TomKeddie/prj-artix7-pcie/hardware/v2/images/blank_top.png

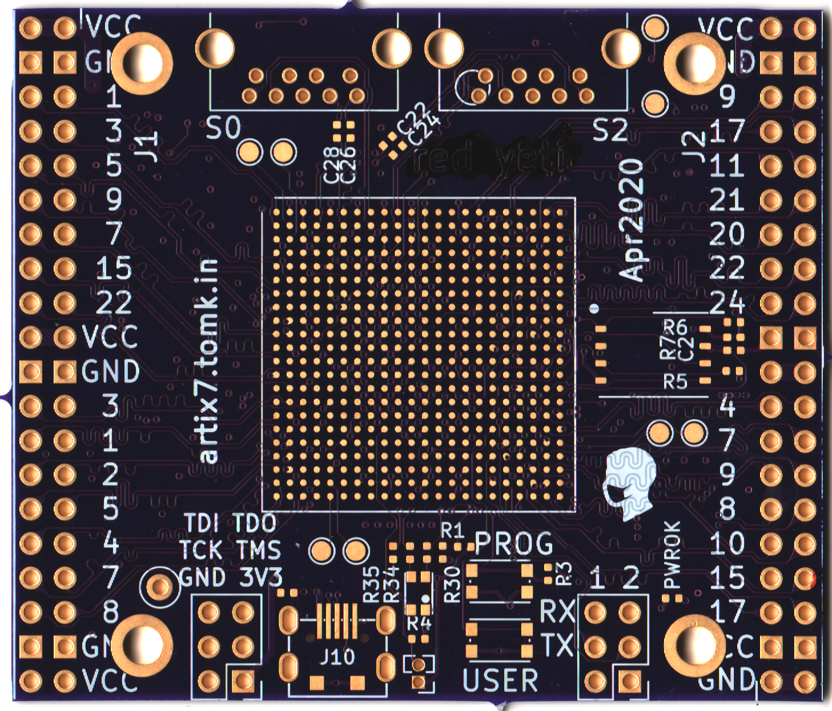
hardware/v2/images/blank_top.png
