TomKeddie/prj-artix7-pcie/hardware/v2/images/blank_bottom.png

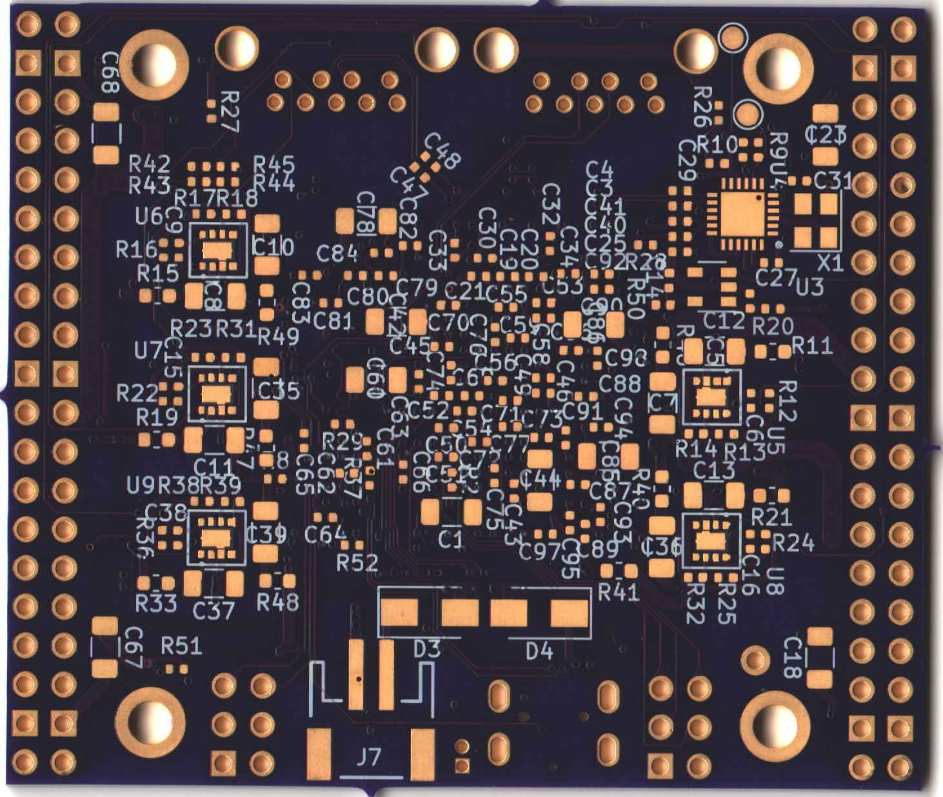
hardware/v2/images/blank_bottom.png
