TomKeddie/prj-artix7-pcie/hardware/v2/README.md

# PCIe artix7

## serdes
- x1 pcie connector (check serdes allocation)
- x1 usb3 connector for expanders and RPi
- x1 on SMA connectors
- x1 in loop?

## Power supply
- reuse supply from netv2

## PMODs
- lots

## CMOD
- maybe
