TomKeddie/prj-artix7-pcie/fpga/test_xc7a12t_cpg238/ex_des/pcie_7x_0_ex/pcie_7x_0_ex.runs/impl_1/.init_design.begin.rst

<?xml version="1.0"?>
<ProcessHandle Version="1" Minor="0">
    <Process Command=".planAhead." Owner="tom" Host="" Pid="7666">
    </Process>
</ProcessHandle>
