TomKeddie/prj-artix7-pcie/fpga/v2/plan/xilinx_ip/pcie_7x_0_ex/pcie_7x_0_ex.runs/synth_1/.vivado.begin.rst

<?xml version="1.0"?>
<ProcessHandle Version="1" Minor="0">
    <Process Command="vivado" Owner="tom" Host="" Pid="15843" HostCore="8" HostMemory="24609572">
    </Process>
</ProcessHandle>
