TomKeddie/prj-artix7-pcie/doc/artix7-pcie-power.pdf

Release: 14-Aug-2019

## Project Settings

| | | | 19% Transceiver…… | 0.494W
Family | | | | 14% I/O | | 0.364W
Device | | | | 59% Core Dynamic.. | 1.534W
Package | | 42.2°C | 5.8W | 8% Device Static | | 0.221W
Speed Grade | | | | Power supplied to off-chip devices… | 0.000W

### Temp Grade

Process | On-Chip Power | | | Power Supply
Voltage ID Used | | | | Voltage | Total (A) | Static
Characterization | (Jump to sheet) | (W) | (%) | 1.000 | 1.567 | 0.109
| | 0.507 | 19 | 1.000 | 0.063 | 0.009
| | 0.457 | 17 | 1.800 | 0.114 | 0.039
Junction Temperature | 42.8 °C | 0.271 | 10 | 2.000 | 0.000 | 0.000
Ambient Temp | | 0.125 | 5 | 3.300 | 0.105 | 0.002
Effective ΘJA | 6.8 °C/W | 0.000 | 0 | 2.500 | 0.000 | 0.000
Airflow | | 0.116 | 4 | 1.800 | 0.000 | 0.000
Heat Sink | | 0.001 | 0 | 1.500 | 0.000 | 0.000
ΘSA | | 0.058 | 2 | 1.350 | 0.000 | 0.000
Board Selection | I/O | 0.364 | 14 | 1.200 | 0.000 | 0.000
# of Board Layers | | 0.494 | 19 | 1.800 | 0.000 | 0.000

ΘJB | | 0.000 | 0 | 1.000 | 0.269 | 0.013
Board Temperature | | 0.000 | 0 | 1.200 | 0.156 | 0.004
| | 0.000 | 0 | 1.800 | 0.000 | 0.000
| Device Static | 0.221 | 8 | 1.075 | 0.000 | 0.000
Optimization | 1 | | | 1.075 | 0.000 | 0.000
1.800 | 0.030 | 0.030

## Spartan®-7, Artix®-7, Kintex®-7, Virtex®-7, Zynq®-7000

Maximum

Commercial

-1 | 6.8 °C/W

250 LFM

VCCO 2.5V

### Core Dynamic

VCCO 1.2V

VCCO 1.35V

Small (4"x4")

0.0 °C/W

## Environment

| | - | 1.500 | 0.000 | 0.000
| Messages | | | - | 1.800 | 0.000 | 0.000 0.000
| | | | - | 1.800 | 0.000
| | | | VCCADC

25.0 °C

### Transceiver

6.8 °C/W

## Summary

XILINX Power Advantage (check for updates) | File Support Request (WebCase)

## Implementation

Default

Xilinx Power Estimator User Guide

0.221

VCCAUX

## Xilinx Power Estimator (XPE) - 2019.1.2

## Power

## Device

Production

Resource | Source VCCINT
No

2.613 W

42.8 °C

Effective ΘJA

### Junction Temperature

### Total On-Chip Power

FGG484

Artix-7

MGTAVCC

### 8 to 11

MGTAVTT

VCCO 1.5V

### Thermal Margin

VCCO 1.8V

None

XC7A75T

25.0 °C | VCCO 3.3V VCCBRAM

VCCAUX_IO

Transceiver……

I/O |

Core Dynamic..

Device Static…..

Import File | Export File | Set Default Rates | Reset to Defaults

LOGIC

BRAM

DSP

IO

PLL

MMCM

GTP

Other

PCIE

CLOCK

User Override

User Override

Quick Estimate | Manage IP | Snapshot

Part
Ambient Temperature
Process
Implementation

### Summary

Total On-Chip Power
Junction Temperature
Effective ΘJA

### On-Chip Power

Clocking
Logic
I/O
BRAM
DSP
Transceiver
PS
Device Static

### Supply Summary

VCCINT

VCCBRAM

VCCAUX

VCCAUX_IO
VCCO 3.3V
VCCO 2.5V
VCCO 1.8V
VCCO 1.5V
VCCO 1.35V
VCCO 1.2V

MGTVCCAUX
MGTAVCC
MGTAVTT
MGTZVCCH
MGTZAVCC
MGTZVCCL

### Settings

Summary | Snapshot | Import | Clear All

VCCPINT

VCCPAUX

VCCPLL

VCCO_DDR

VCCO_MIO0

VCCO_MIO1

VCCADC

# Power Comparison Snapshots

# 0.2 Power ⁽W⁾

# 0.6 Power ⁽W⁾

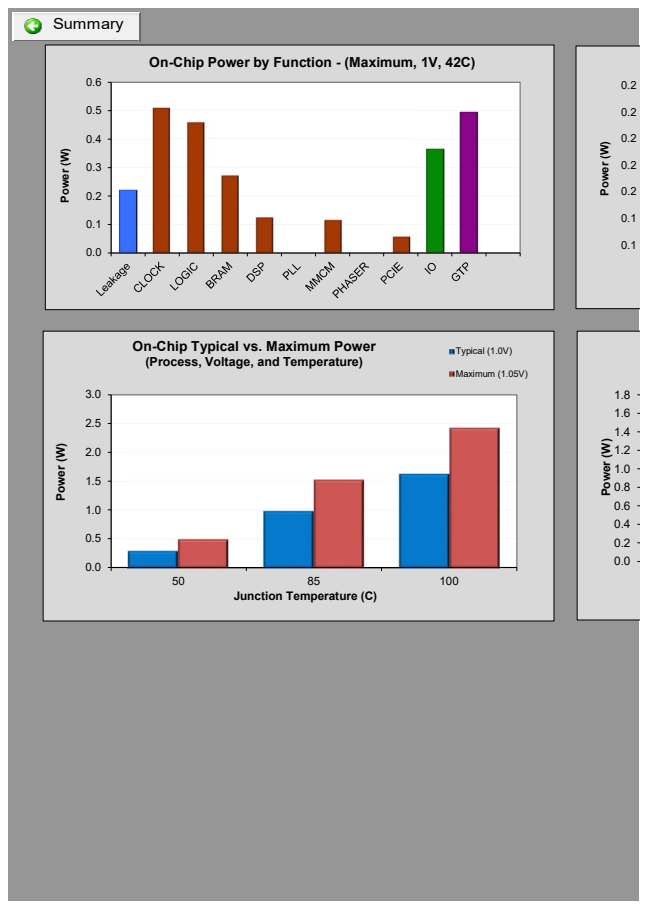
[picture p3: page 23]
1.8 Power ⁽W⁾; 100 Power ⁽W⁾; Junction Temperature (C); Typical (1.0V); Maximum (1.05V); Summary

On-Chip Power by Function - (Maximum, 1V, 42C)

On-Chip Typical vs. Maximum Power
(Process, Voltage, and Temperature)

On-Chip Power over Vccint - (Maximum, 42C)
On-Chip Power - (Maximum, 1V)

# 120 Current (mA⁾

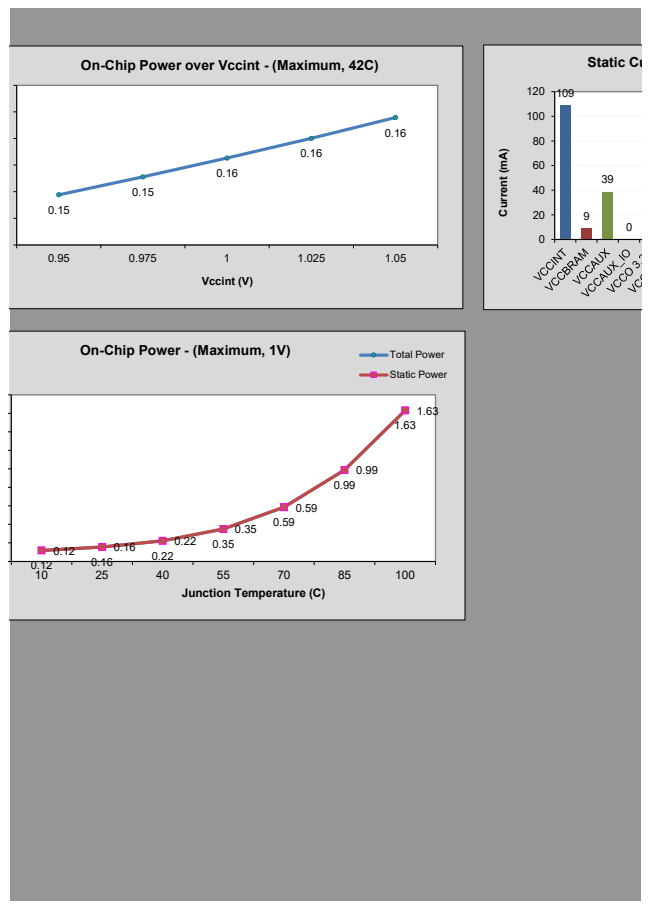
[picture p4: page 25]
Junction Temperature (C); On-Chip Power - (Maximum, 1V); Total Power; Static Power; Vccint (V)

Static Current by Supply

On-Chip Power over Vccint - (Maximum, 42C)

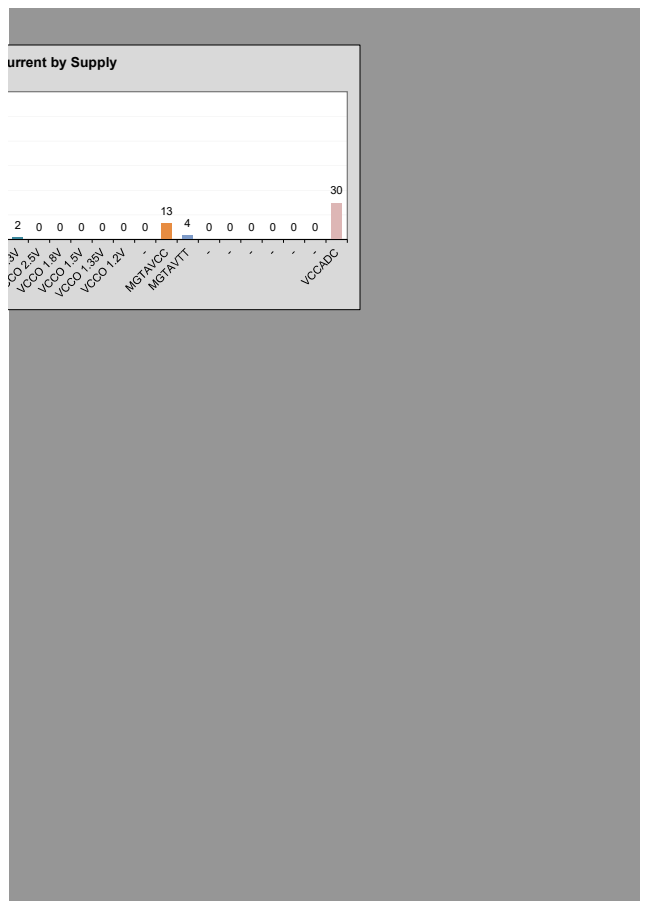
[picture p5: page 27]

Static Current by Supply

Part | XC7K325TFBG900-2LE | Junction Temp | 42.8 °C
Process | Maximum | Static Power | 0.221 W
Effective ΘJA 6.8 °C/W | | | 2.613 W
Implementation
Power (W) | Clocking* | Logic | I/O* | BRAM

29

### Total Power

Default

# IP Manager

## On-Chip Summary

## Device

## IP Modules

Summary | Manage IP

DSP | Transceiver* | Source

IP Catalog
Block Memory
Distributed Memory
Memory Interface
Transceiver Interface
Clock | PLL | MMCM | Logic | I/O | Phaser | BRAM | DSP | PCIE

GTP/X/H GTZ

VCCINT | 1.000V | 0.507W | Global | 2 | 6%
| | | Regional | 0 | 0%
I/O | 0 | 0%
Other | 0 | -

### Frequency

(MHz) | Type | Fanout

### Clock Buffer Enable

100.0 Global | 100000 | 100%
250.0 Global | 100000 | 100%
Global | 100%
Global | 100%
Global | 100%
Global | 100%
Global | 100%
Global | 100%
Global | 100%
Global | 100%
Global | 100%
Global | 100%
Global | 100%
Global | 100%
Global | 100%
Global | 100%
Global | 100%
Global | 100%
Global | 100%
Global | 100%
Global | 100%
Global | 100%
Global | 100%
Global | 100%
Global | 100%
Global | 100%
Global | 100%
Global | 100%
Global | 100%
Global | 100%
Global | 100%
Global | 100%
Global | 100%
Global | 100%
Global | 100%
Global | 100%
Global | 100%
Global | 100%

### Name

# Clock Tree Power

### Utilization

clk_100
clk_250

### Power

19% of total on-chip power 2.613W

Summary

Global | 100%
Global | 100%
Global | 100%
Global | 100%
Global | 100%
Global | 100%
Global | 100%
Global | 100%
Global | 100%
Global | 100%
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
0.000399
0.000399
0.000399
0.000399
0.000399
0.000399
0.000399
0.000399
0.000399
0.000399
0.000399
0.000399
0.000399
0.000399
0.000399
0.000399
0.000399
0.000399
0.000399
0.000399
0.000399
0.000399
0.000399
0.000399
0.000399
0.000399
0.000399
0.000399
0.000399
0.000399
0.000399
0.000399
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
