TomKeddie/prj-artix7-pcie/hardware/v2/bringup/rc2/hardware_manager.png

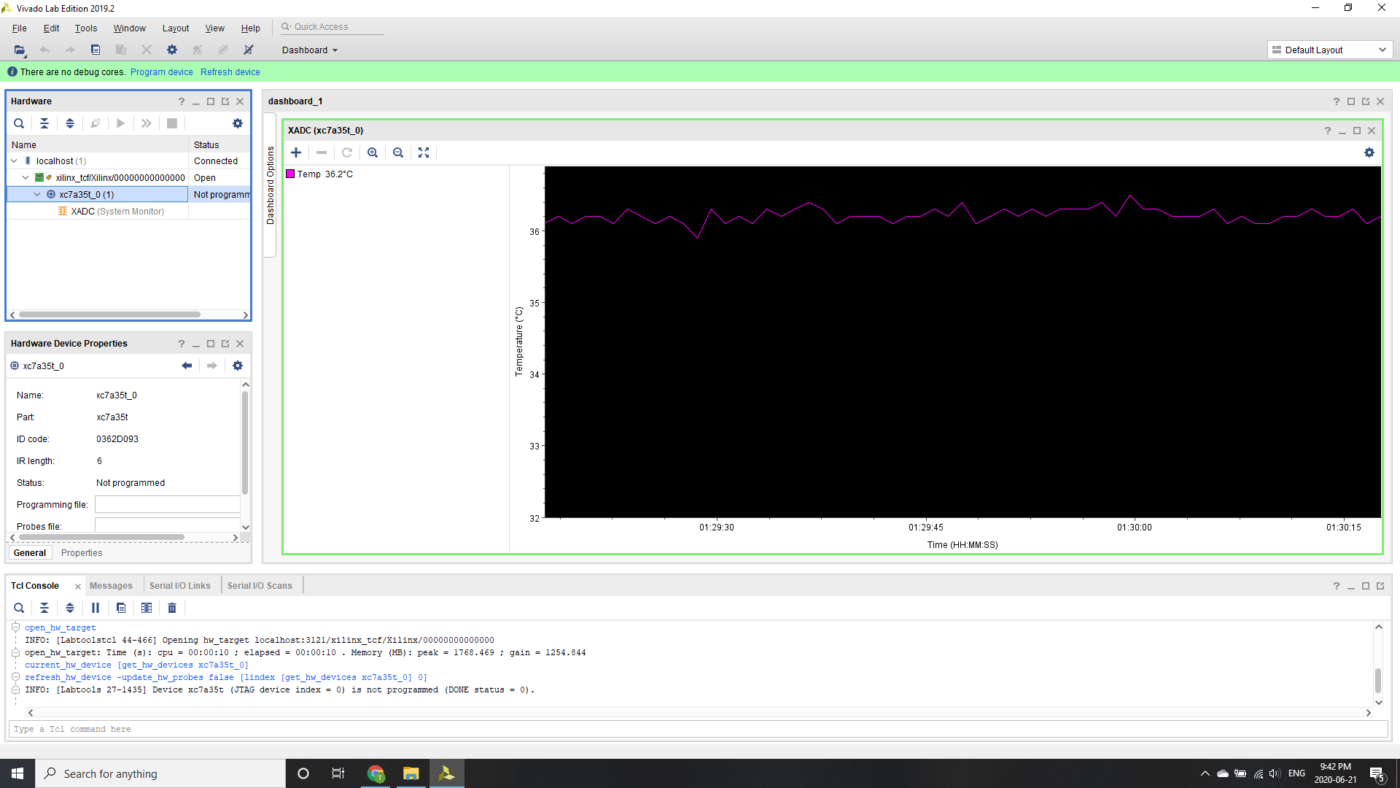
hardware/v2/bringup/rc2/hardware_manager.png
