TomKeddie/prj-artix7-pcie/hardware/v2/eye/20200802_X0Y0_X0Y2_eye_6.25_1e-5.png

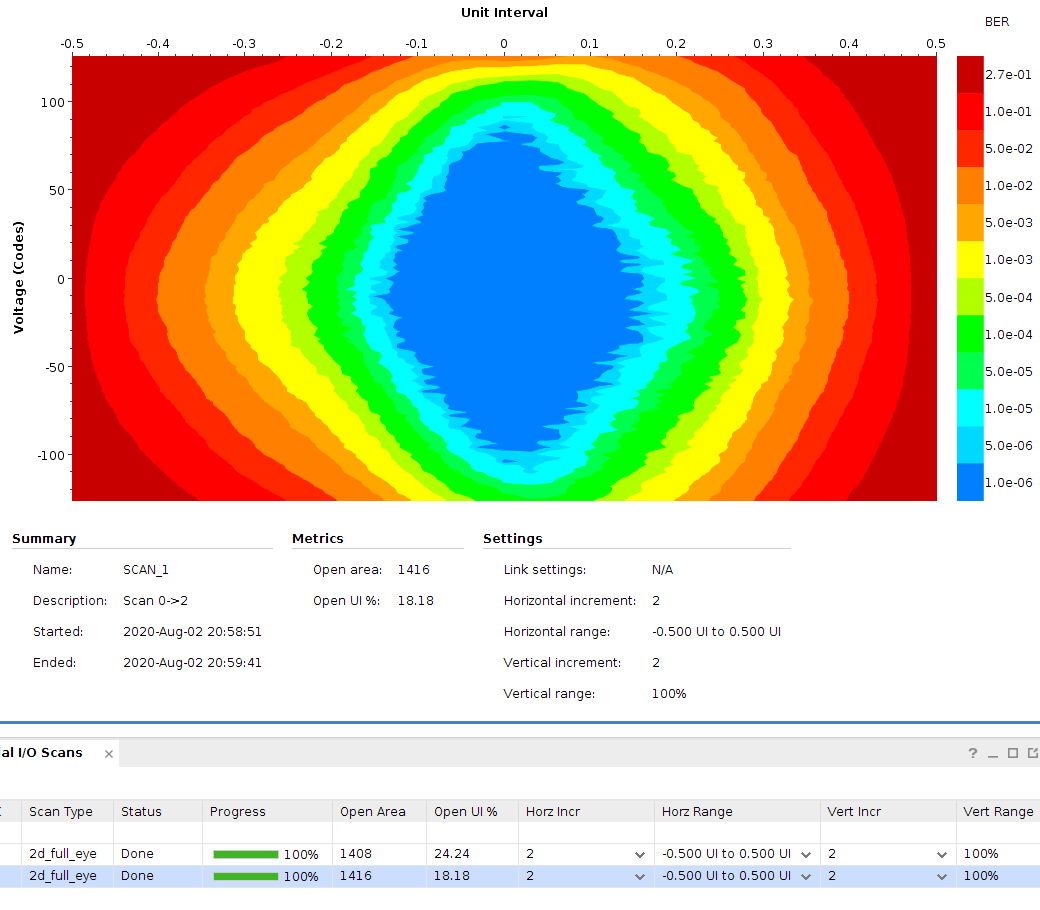
hardware/v2/eye/20200802_X0Y0_X0Y2_eye_6.25_1e-5.png
