TomKeddie/prj-artix7-pcie/hardware/v2/eye/20200802_X0Y2_X0Y0_eye_3.125_1e-10.png

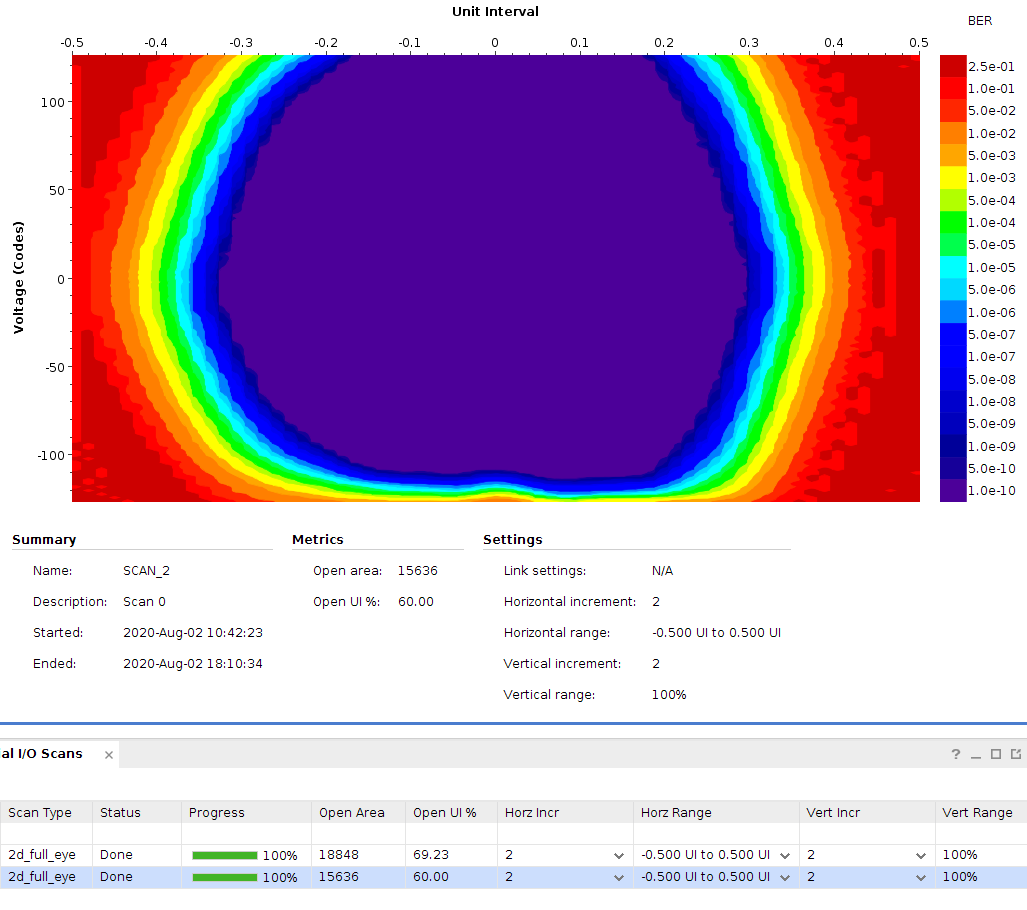
hardware/v2/eye/20200802_X0Y2_X0Y0_eye_3.125_1e-10.png
