TomKeddie/prj-artix7-pcie/hardware/v2/Screenshot_2020-03-27_16-05-11.png

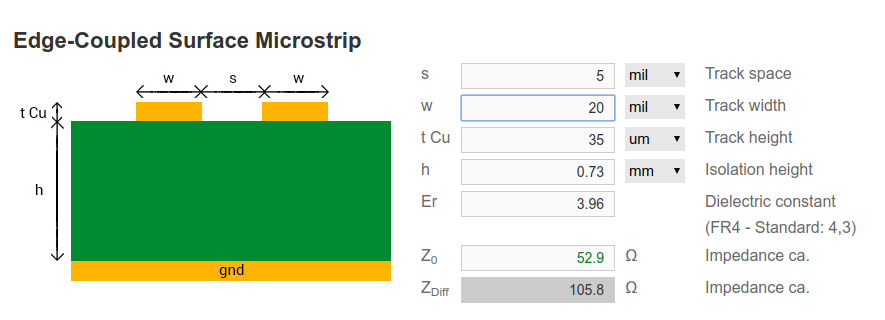
hardware/v2/Screenshot_2020-03-27_16-05-11.png
