TomKeddie/prj-artix7-pcie/hardware/v2/sep2020/Produce_DanZhi.SMT_Original_Snapshot.Bottom.2506220A_Y74.SMT020092078830.png

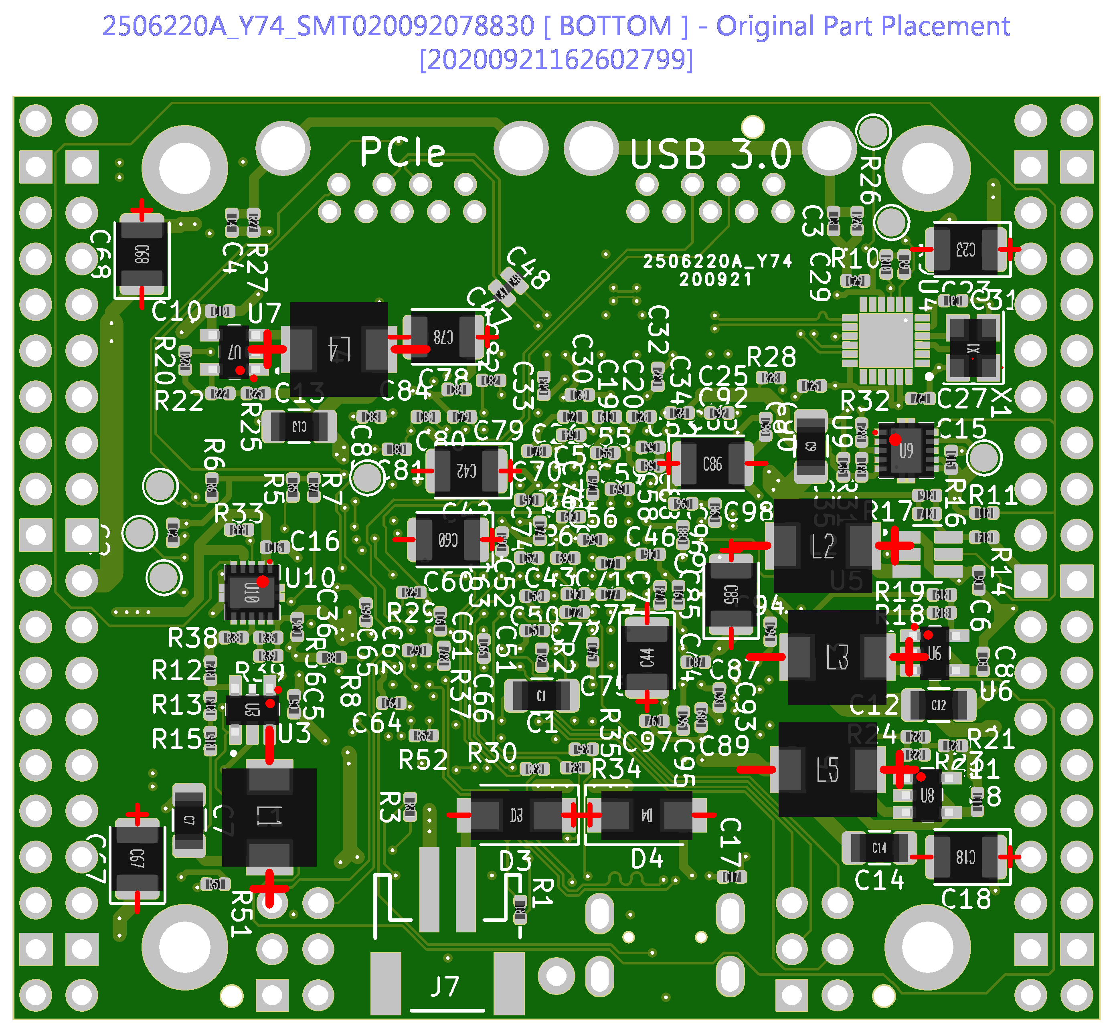
hardware/v2/sep2020/Produce_DanZhi.SMT_Original_Snapshot.Bottom.2506220A_Y74.SMT020092078830.png
