TomKeddie/prj-artix7-pcie/hardware/v2/artix7-pcie-v2_jlcpcb.csv

Comment | Designator | Footprint | LCSC
47uF/6.3V/X5R | C1 | tom-passives:C_1206_3216Metric | C96123
0.1uF/6.3V/X5R | C2,C3,C4,C17,C20,C21,C25,C27,C29,C30,C31,C32,C33 | tom-passives:C_0402_1005Metric | C1525
0.1uF/6.3V/X5R/PCIE | C22,C24,C26,C28,C47,C48 | tom-passives:C_0402_1005Metric | C1525
4.7uF/6.3V/X5R | C19,C34,C43,C45,C46,C50,C61,C62,C70,C71,C72,C73,C79,C80,C87,C88,C89,C90 | tom-passives:C_0402_1005Metric | C23733
4.7uF/10V/X5R | C5,C6,C8,C10,C11,C15,C16,C35,C36 | tom-passives:C_0402_1005Metric | C23733
10uF/25V/X7R | C7,C13 | tom-passives:C_1206_3216Metric | C13585
100uF/6.3V/X5R | C18,C23,C42,C44,C60,C67,C68,C78,C85,C86 | tom-passives:CP_EIA-3528-15_AVX-H | C16133
0.47uF/6.3V/X5R | C49,C51,C52,C53,C54,C55,C56,C58,C59,C63,C64,C65,C66,C69,C74,C75,C76,C77,C81,C82,C83,C84,C91,C92,C93,C94,C95,C96,C97,C98 | tom-passives:C_0402_1005Metric | C47339
47uF/10V/X7R | C9,C12,C14 | tom-passives:C_1206_3216Metric | C96123
DONE | D1 | tom-opto:LED_0402_1005Metric | C130722
E6C1206RGBC3UDA | D2 | tom-opto:E6C1206RGBC3UDA | C375571
SBR3U20SA-13 | D3,D4 | tom-semiconductors:D_SMA | C146738
PWR | D5,D6 | tom-opto:LED_0402_1005Metric | C130724
mask silk image | H1 | artix7-pcie-v2:mask | DNP
mech-only-no-pins | H2,H3,H4 | tom-mechanical:JLCPCB_ASSEMBLY_TOOL_HOLE | DNP
Conn_02x20_Odd_Even | J1,J2 | artix7-pcie-v2:Socket_Strip_Angled_2x20 | DNP
USB_B_Micro | J10 | tom-connectors:USB_MICRO_TAOBAO_SMD_PTH | DNP
USB3_A | J4 | tom-connectors:USB3_A_Aliexpress | DNP
USB3_A_AS_PCIE | J5 | tom-connectors:USB3_A_Aliexpress | DNP
JTAG | J6 | tom-connectors:PinHeader_2x03_P2.54mm_Vertical | DNP
Conn_01x02 | J7 | tom-connectors:JST-2-SMD | DNP
SER | J8 | tom-connectors:PinHeader_2x03_P2.54mm_Vertical | DNP
2.2uH/4.5A | L1,L2,L3,L4,L5 | tom-passives:L_MWSA0518S | C408345
300k/1% | R13,R22 | tom-passives:R_0402_1005Metric | C25774
100k/1% | R11,R12,R14,R17,R18,R20,R21,R24,R32,R33,R38 | tom-passives:R_0402_1005Metric | C25741
200k/1% | R16,R19,R23,R36 | tom-passives:R_0402_1005Metric | C25764
18k/1% | R25 | tom-passives:R_0402_1005Metric | C25762
1.5k | R29,R37 | tom-passives:R_0402_1005Metric | C25867
1.2k/1% | R30 | tom-passives:R_0402_1005Metric | C25862
150k/1% | R15,R31 | tom-passives:R_0402_1005Metric | C25755
300R/5% | R26,R27,R34,R35 | tom-passives:R_0402_1005Metric | C25102
330k/1% | R39 | tom-passives:R_0402_1005Metric | C25778
100R/1% | R28,R52 | tom-passives:R_0402_1005Metric | C25076
2.4k/5% | R6 | tom-passives:R_0402_1005Metric | C25882
4.7k/5% | R1,R2,R3,R4,R5,R7,R9,R10,R51 | tom-passives:R_0402_1005Metric | C25900
1k/1% | R8 | tom-passives:R_0402_1005Metric | C11702
PROG | SW1 | tom-mechanical:SW_Push_1P1T_NO_Vertical_Wuerth_434133025816 | DNP
USER | SW2 | tom-mechanical:SW_Push_1P1T_NO_Vertical_Wuerth_434133025816 | DNP
TestPoint | TP10,TP11,TP12,TP13 | tom-mechanical:MountingHole_2.7mm_M2.5_DIN965_Pad | DNP
SCL | TP14 | tom-mechanical:TestPoint_Pad_D1.5mm | DNP
SDA | TP15 | tom-mechanical:TestPoint_Pad_D1.5mm | DNP
TestPoint | TP1,TP2,TP3,TP4,TP5,TP6,TP7,TP8,TP16,TP17,TP18,TP19,TP20 | tom-mechanical:TestPoint_Pad_D1.5mm | DNP
TestPoint | TP9 | tom-mechanical:TestPoint_Loop_D2.50mm_Drill1.0mm | DNP
XC7A75T-FGG484 | U1 | artix7-pcie-v2:Xilinx_FGG484 | DNP
TPS74701DRCR | U9,U10 | artix7-pcie-v2:16624-01YE | C105262
MX25L51245GZ2I-10G | U2 | artix7-pcie-v2:WSON-8-1EP_8x6mm_P1.27mm | DNP
5P49V6965A000NLGI | U4 | artix7-pcie-v2:QFN50P400X400X100-25N-D | DNP
TLV62569PDDCR | U5 | artix7-pcie-v2:SOT95P280X110-6N | DNP
TLV62569DBVR | U3,U6,U7,U8 | artix7-pcie-v2:SOT95P280X145-5N | C141836
25MHz/10pF | X1 | tom-passives:Crystal_SMD_3225-4Pin_3.2x2.5mm | C9006
