TomKeddie/prj-artix7-pcie/fpga/v1/test_xc7a15t_csg325/ex_des/pcie_7x_0_ex/pcie_7x_0_ex.runs/impl_1/usage_statistics_webtalk.html

### Device Usage Page (usage_statistics_webtalk.html)

This HTML page displays the device usage statistics that will be sent to Xilinx.
To see the actual file transmitted to Xilinx, please click here.

software_version_and_target_device
beta | FALSE | build_version | 2188600
date_generated | Sat Sep 29 06:43:35 2018 | os_platform | LIN64
product_version | Vivado v2018.1 (64-bit) | project_id | d259a2cb10b943cda54699214e62da38
project_iteration | 1 | random_id | ff858b53-a1ef-43aa-b713-6dc5c6852ce6
registration_id | 211427051_0_0_653 | route_design | TRUE
target_device | xc7a25t | target_family | artix7
target_package | csg325 | target_speed | -1
tool_flow | Vivado

user_environment
cpu_name | Intel(R) Xeon(R) CPU W3530 @ 2.80GHz | cpu_speed | 1719.459 MHz
os_name | Arch | os_release | Arch Linux
system_ram | 25.000 GB | total_processors | 1

vivado_usage

gui_handlers
filesetpanel_file_set_panel_tree=5 | flownavigatortreepanel_flow_navigator_tree=1 | hcodeeditor_search_text_combo_box=2

java_command_handlers

runbitgen=1

other_data

guimode=1

project_data
constraintsetcount=1 | core_container=false | currentimplrun=impl_1 | currentsynthesisrun=synth_1
default_library=xil_defaultlib | designmode=RTL | export_simulation_activehdl=1 | export_simulation_ies=1
export_simulation_modelsim=1 | export_simulation_questa=1 | export_simulation_riviera=1 | export_simulation_vcs=1
export_simulation_xsim=1 | implstrategy=Vivado Implementation Defaults | launch_simulation_activehdl=0 | launch_simulation_ies=0
launch_simulation_modelsim=0 | launch_simulation_questa=0 | launch_simulation_riviera=0 | launch_simulation_vcs=0
launch_simulation_xsim=0 | simulator_language=Mixed | srcsetcount=17 | synthesisstrategy=Vivado Synthesis Defaults
target_language=VHDL | target_simulator=XSim | totalimplruns=1 | totalsynthesisruns=1

unisim_transformation

post_unisim_transformation
bufg=4 | bufgctrl=1 | carry4=9 | fdce=9
fdpe=2 | fdre=1586 | fdse=35 | gnd=33
gtpe2_channel=1 | gtpe2_common=2 | ibuf=5 | ibufds_gte2=1
lut1=60 | lut2=152 | lut3=253 | lut4=171
lut5=183 | lut6=218 | mmcme2_adv=1 | muxf7=2
obuf=2 | pcie_2_1=1 | ramb36e1=8 | srl16e=6
srlc32e=14 | vcc=41

pre_unisim_transformation
bufg=4 | bufgctrl=1 | carry4=9 | fdce=9
fdpe=2 | fdre=1586 | fdse=35 | gnd=33
gtpe2_channel=1 | gtpe2_common=2 | ibuf=5 | ibufds_gte2=1
lut1=60 | lut2=152 | lut3=253 | lut4=171
lut5=183 | lut6=218 | mmcme2_adv=1 | muxf7=2
obuf=2 | pcie_2_1=1 | ramb36e1=8 | srl16e=6
srlc32e=14 | vcc=41

power_opt_design

command_line_options_spo
-cell_types=default::all | -clocks=default::[not_specified] | -exclude_cells=default::[not_specified] | -include_cells=default::[not_specified]

usage
bram_ports_augmented=0 | bram_ports_newly_gated=8 | bram_ports_total=16 | flow_state=default
slice_registers_augmented=0 | slice_registers_newly_gated=0 | slice_registers_total=1223 | srls_augmented=0
srls_newly_gated=0 | srls_total=13

ip_statistics

pcie_7x_0_pcie2_top/1
bar_0=FFFFF804 | bar_1=FFFFFFFF | bar_2=00000000 | bar_3=00000000
bar_4=00000000 | bar_5=00000000 | bram_lat=0 | c_aer_base_ptr=000
c_aer_cap_ecrc_check_capable=FALSE | c_aer_cap_ecrc_gen_capable=FALSE | c_aer_cap_multiheader=FALSE | c_aer_cap_nextptr=000
c_aer_cap_on=FALSE | c_aer_cap_optional_err_support=000000 | c_aer_cap_permit_rooterr_update=FALSE | c_buf_opt_bma=TRUE
c_component_name=pcie_7x_0 | c_cpl_inf=TRUE | c_cpl_infinite=TRUE | c_cpl_timeout_disable_sup=FALSE
c_cpl_timeout_range=1110 | c_cpl_timeout_ranges_sup=E | c_d1_support=FALSE | c_d2_support=FALSE
c_data_width=64 | c_de_emph=FALSE | c_dev_cap2_ari_forwarding_supported=FALSE | c_dev_cap2_atomicop32_completer_supported=FALSE
c_dev_cap2_atomicop64_completer_supported=FALSE | c_dev_cap2_atomicop_routing_supported=FALSE | c_dev_cap2_cas128_completer_supported=FALSE | c_dev_cap2_tph_completer_supported=00
c_dev_control_ext_tag_default=FALSE | c_dev_port_type=0 | c_dis_lane_reverse=TRUE | c_disable_rx_poisoned_resp=FALSE
c_disable_scrambling=FALSE | c_disable_tx_aspm_l0s=FALSE | c_dll_lnk_actv_cap=FALSE | c_dsi_bool=FALSE
c_dsn_base_ptr=100 | c_dsn_cap_enabled=TRUE | c_dsn_next_ptr=000 | c_enable_msg_route=00000000000
c_ep_l0s_accpt_lat=6 | c_ep_l1_accpt_lat=7 | c_ext_pci_cfg_space_addr=3FF | c_fc_cpld=205
c_fc_cplh=36 | c_fc_npd=24 | c_fc_nph=12 | c_fc_pd=181
c_fc_ph=32 | c_gen1=false | c_header_type=00 | c_hw_auton_spd_disable=FALSE
c_last_cfg_dw=10C | c_link_cap_aspm_optionality=FALSE | c_ll_ack_timeout=0000 | c_ll_ack_timeout_enable=FALSE
c_ll_ack_timeout_function=0 | c_ll_replay_timeout=0000 | c_ll_replay_timeout_enable=FALSE | c_ll_replay_timeout_func=1
c_msi=0 | c_msi_64b_addr=TRUE | c_msi_cap_on=TRUE | c_msi_mult_msg_extn=0
c_msi_per_vctr_mask_cap=FALSE | c_msix_cap_on=FALSE | c_msix_next_ptr=00 | c_msix_pba_bir=0
c_msix_pba_offset=0 | c_msix_table_bir=0 | c_msix_table_offset=0 | c_msix_table_size=000
c_pci_cfg_space_addr=3F | c_pcie_blk_locn=0 | c_pcie_cap_next_ptr=00 | c_pcie_cap_slot_implemented=FALSE
c_pcie_dbg_ports=TRUE | c_pcie_fast_config=0 | c_perf_level_high=TRUE | c_phantom_functions=0
c_pm_cap_next_ptr=48 | c_pme_support=0F | c_rbar_base_ptr=000 | c_rbar_cap_control_encodedbar0=00
c_rbar_cap_control_encodedbar1=00 | c_rbar_cap_control_encodedbar2=00 | c_rbar_cap_control_encodedbar3=00 | c_rbar_cap_control_encodedbar4=00
c_rbar_cap_control_encodedbar5=00 | c_rbar_cap_index0=0 | c_rbar_cap_index1=0 | c_rbar_cap_index2=0
c_rbar_cap_index3=0 | c_rbar_cap_index4=0 | c_rbar_cap_index5=0 | c_rbar_cap_nextptr=000
c_rbar_cap_on=FALSE | c_rbar_cap_sup0=00001 | c_rbar_cap_sup1=00001 | c_rbar_cap_sup2=00001
c_rbar_cap_sup3=00001 | c_rbar_cap_sup4=00001 | c_rbar_cap_sup5=00001 | c_rbar_num=0
c_rcb=0 | c_recrc_check=0 | c_recrc_check_trim=FALSE | c_root_cap_crs=FALSE
c_rx_raddr_lat=0 | c_rx_ram_limit=3FF | c_rx_rdata_lat=2 | c_rx_write_lat=0
c_silicon_rev=2 | c_slot_cap_attn_butn=FALSE | c_slot_cap_attn_ind=FALSE | c_slot_cap_elec_interlock=FALSE
c_slot_cap_hotplug_cap=FALSE | c_slot_cap_hotplug_surprise=FALSE | c_slot_cap_mrl=FALSE | c_slot_cap_no_cmd_comp_sup=FALSE
c_slot_cap_physical_slot_num=0 | c_slot_cap_pwr_ctrl=FALSE | c_slot_cap_pwr_ind=FALSE | c_slot_cap_pwr_limit_scale=0
c_slot_cap_pwr_limit_value=0 | c_trgt_lnk_spd=0 | c_trn_np_fc=TRUE | c_tx_last_tlp=31
c_tx_raddr_lat=0 | c_tx_rdata_lat=2 | c_tx_write_lat=0 | c_upconfig_capable=TRUE
c_upstream_facing=TRUE | c_ur_atomic=FALSE | c_ur_inv_req=TRUE | c_ur_prs_response=TRUE
c_vc_base_ptr=000 | c_vc_cap_enabled=FALSE | c_vc_cap_reject_snoop=FALSE | c_vc_next_ptr=000
c_vsec_base_ptr=000 | c_vsec_cap_enabled=FALSE | c_vsec_next_ptr=000 | c_xlnx_ref_board=NONE
cap_ver=2 | cardbus_cis_ptr=00000000 | cfg_ctl_if=TRUE | cfg_fc_if=TRUE
cfg_mgmt_if=TRUE | cfg_status_if=TRUE | class_code=058000 | cmps=0
con_scl_fctr_d0_state=0 | con_scl_fctr_d1_state=0 | con_scl_fctr_d2_state=0 | con_scl_fctr_d3_state=0
core_container=NA | cost_table=1 | d1_sup=0 | d2_sup=0
dev_id=7011 | dev_port_type=0000 | dis_scl_fctr_d0_state=0 | dis_scl_fctr_d1_state=0
dis_scl_fctr_d2_state=0 | dis_scl_fctr_d3_state=0 | dsi=0 | enable_jtag_dbg=TRUE
ep_l0s_accpt_lat=110 | ep_l1_accpt_lat=111 | err_reporting_if=TRUE | ext_ch_gt_drp=TRUE
ext_pipe_interface=FALSE | ext_startup_primitive=FALSE | ext_tag_fld_sup=FALSE | int_pin=1
intx=TRUE | iptotal=1 | keep_width=8 | link_cap_max_link_width=1
max_lnk_spd=1 | max_lnk_wdt=000001 | mps=000 | no_soft_rst=TRUE
pci_exp_int_freq=2 | pci_exp_ref_freq=0 | pcie_async_en=FALSE | pcie_ext_clk=TRUE
pcie_ext_gt_common=TRUE | phantm_func_sup=00 | pipe_sim=FALSE | pl_interface=TRUE
pme_sup=0F | pwr_con_d0_state=00 | pwr_con_d1_state=00 | pwr_con_d2_state=00
pwr_con_d3_state=00 | pwr_dis_d0_state=00 | pwr_dis_d1_state=00 | pwr_dis_d2_state=00
pwr_dis_d3_state=00 | rcv_msg_if=TRUE | rev_id=00 | shared_logic_in_core=FALSE
slot_clk=TRUE | subsys_id=0007 | subsys_ven_id=10EE | transceiver_ctrl_status_ports=TRUE
ven_id=10EE | x_ipcorerevision=8 | x_iplanguage=VHDL | x_iplibrary=ip
x_ipname=pcie_7x | x_ipproduct=Vivado 2018.1 | x_ipsimlanguage=MIXED | x_ipvendor=xilinx.com
x_ipversion=3.3 | xrom_bar=00000000

xpm_cdc_single/1
core_container=NA | dest_sync_ff=2 | init_sync_ff=0 | iptotal=2
sim_assert_chk=0 | src_input_reg=0 | version=0

report_drc

command_line_options
-append=default::[not_specified] | -checks=default::[not_specified] | -fail_on=default::[not_specified] | -force=default::[not_specified]
-format=default::[not_specified] | -internal=default::[not_specified] | -internal_only=default::[not_specified] | -messages=default::[not_specified]
-name=default::[not_specified] | -no_waivers=default::[not_specified] | -return_string=default::[not_specified] | -ruledecks=default::[not_specified]
-upgrade_cw=default::[not_specified] | -waived=default::[not_specified]

results
cfgbvs-1=1 | rtstat-10=1

report_methodology

command_line_options
-append=default::[not_specified] | -checks=default::[not_specified] | -fail_on=default::[not_specified] | -force=default::[not_specified]
-format=default::[not_specified] | -messages=default::[not_specified] | -name=default::[not_specified] | -return_string=default::[not_specified]

-waived=default::[not_specified]

results
lutar-1=1 | timing-28=2 | xdcb-5=12

report_power

command_line_options
-advisory=default::[not_specified] | -append=default::[not_specified] | -file=[specified] | -format=default::text
-hier=default::power | -l=default::[not_specified] | -name=default::[not_specified] | -no_propagation=default::[not_specified]
-return_string=default::[not_specified] | -rpx=[specified] | -verbose=default::[not_specified] | -vid=default::[not_specified]

-xpe=default::[not_specified]

usage
-xpe=0.025000 | airflow=250 (LFM) | ambient_temp=25.0 (C) | bi-dir_toggle=12.500000
bidir_output_enable=1.000000 | board_layers=12to15 (12 to 15 Layers) | board_selection=medium (10"x10") | bram=0.014921
clocks=0.008585 | confidence_level_clock_activity=High | confidence_level_design_state=High | confidence_level_device_models=High
confidence_level_internal_activity=Medium | confidence_level_io_activity=Low | confidence_level_overall=Low | customer=TBD
customer_class=TBD | devstatic=0.063128 | die=xc7a25tcsg325-1 | dsp_output_toggle=12.500000
dynamic=0.310279 | effective_thetaja=5.3 | enable_probability=0.990000 | family=artix7
ff_toggle=12.500000 | flow_state=routed | gtp=0.148820 | heatsink=medium (Medium Profile)
i/o=0.000000 | input_toggle=12.500000 | junction_temp=27.0 (C) | logic=0.001604
mgtavcc_dynamic_current=0.066700 | mgtavcc_static_current=0.001386 | mgtavcc_total_current=0.068086 | mgtavcc_voltage=1.000000
mgtavtt_dynamic_current=0.059100 | mgtavtt_static_current=0.002529 | mgtavtt_total_current=0.061629 | mgtavtt_voltage=1.200000
mmcm=0.106817 | netlist_net_matched=NA | off-chip_power=0.000000 | on-chip_power=0.373407
output_enable=1.000000 | output_load=5.000000 | output_toggle=12.500000 | package=csg325
pct_clock_constrained=2.410000 | pct_inputs_defined=20 | platform=lin64 | process=typical
ram_enable=50.000000 | ram_write=50.000000 | read_saif=False | set/reset_probability=0.000000
signal_rate=False | signals=0.004531 | simulation_file=None | speedgrade=-1
static_prob=False | temp_grade=commercial | thetajb=9.4 (C/W) | thetasa=4.6 (C/W)
toggle_rate=False | user_board_temp=25.0 (C) | user_effective_thetaja=5.3 | user_junc_temp=27.0 (C)
user_thetajb=9.4 (C/W) | user_thetasa=4.6 (C/W) | vccadc_dynamic_current=0.000000 | vccadc_static_current=0.020000
vccadc_total_current=0.020000 | vccadc_voltage=1.800000 | vccaux_dynamic_current=0.058791 | vccaux_io_dynamic_current=0.000000
vccaux_io_static_current=0.000000 | vccaux_io_total_current=0.000000 | vccaux_io_voltage=1.800000 | vccaux_static_current=0.009477
vccaux_total_current=0.068268 | vccaux_voltage=1.800000 | vccbram_dynamic_current=0.001180 | vccbram_static_current=0.000380
vccbram_total_current=0.001560 | vccbram_voltage=1.000000 | vccint_dynamic_current=0.065654 | vccint_static_current=0.005269
vccint_total_current=0.070923 | vccint_voltage=1.000000 | vcco12_dynamic_current=0.000000 | vcco12_static_current=0.000000
vcco12_total_current=0.000000 | vcco12_voltage=1.200000 | vcco135_dynamic_current=0.000000 | vcco135_static_current=0.000000
vcco135_total_current=0.000000 | vcco135_voltage=1.350000 | vcco15_dynamic_current=0.000000 | vcco15_static_current=0.000000
vcco15_total_current=0.000000 | vcco15_voltage=1.500000 | vcco18_dynamic_current=0.000000 | vcco18_static_current=0.000000
vcco18_total_current=0.000000 | vcco18_voltage=1.800000 | vcco25_dynamic_current=0.000000 | vcco25_static_current=0.000000
vcco25_total_current=0.000000 | vcco25_voltage=2.500000 | vcco33_dynamic_current=0.000000 | vcco33_static_current=0.000000
vcco33_total_current=0.000000 | vcco33_voltage=3.300000 | version=2018.1

report_utilization

clocking
bufgctrl_available=32 | bufgctrl_fixed=0 | bufgctrl_used=4 | bufgctrl_util_percentage=12.50
bufhce_available=48 | bufhce_fixed=0 | bufhce_used=0 | bufhce_util_percentage=0.00
bufio_available=12 | bufio_fixed=0 | bufio_used=0 | bufio_util_percentage=0.00
bufmrce_available=6 | bufmrce_fixed=0 | bufmrce_used=0 | bufmrce_util_percentage=0.00
bufr_available=12 | bufr_fixed=0 | bufr_used=0 | bufr_util_percentage=0.00
mmcme2_adv_available=3 | mmcme2_adv_fixed=0 | mmcme2_adv_used=1 | mmcme2_adv_util_percentage=33.33
plle2_adv_available=3 | plle2_adv_fixed=0 | plle2_adv_used=0 | plle2_adv_util_percentage=0.00

dsp
dsps_available=80 | dsps_fixed=0 | dsps_used=0 | dsps_util_percentage=0.00

io_standard
blvds_25=0 | diff_hstl_i=0 | diff_hstl_i_18=0 | diff_hstl_ii=0
diff_hstl_ii_18=1 | diff_hsul_12=0 | diff_mobile_ddr=0 | diff_sstl135=0
diff_sstl135_r=0 | diff_sstl15=0 | diff_sstl15_r=0 | diff_sstl18_i=0
diff_sstl18_ii=0 | hstl_i=0 | hstl_i_18=0 | hstl_ii=0
hstl_ii_18=0 | hsul_12=0 | lvcmos12=0 | lvcmos15=0
lvcmos18=1 | lvcmos25=0 | lvcmos33=1 | lvds_25=0
lvttl=0 | mini_lvds_25=0 | mobile_ddr=0 | pci33_3=0
ppds_25=0 | rsds_25=0 | sstl135=0 | sstl135_r=0
sstl15=0 | sstl15_r=0 | sstl18_i=0 | sstl18_ii=0

tmds_33=0

memory
block_ram_tile_available=45 | block_ram_tile_fixed=0 | block_ram_tile_used=8 | block_ram_tile_util_percentage=17.78
ramb18_available=90 | ramb18_fixed=0 | ramb18_used=0 | ramb18_util_percentage=0.00
ramb36_fifo_available=45 | ramb36_fifo_fixed=4 | ramb36_fifo_used=8 | ramb36_fifo_util_percentage=17.78

ramb36e1_only_used=8

primitives
bufg_functional_category=Clock | bufg_used=3 | bufgctrl_functional_category=Clock | bufgctrl_used=1
carry4_functional_category=CarryLogic | carry4_used=3 | fdce_functional_category=Flop & Latch | fdce_used=9
fdpe_functional_category=Flop & Latch | fdpe_used=2 | fdre_functional_category=Flop & Latch | fdre_used=1185
fdse_functional_category=Flop & Latch | fdse_used=27 | gtpe2_channel_functional_category=IO | gtpe2_channel_used=1
gtpe2_common_functional_category=IO | gtpe2_common_used=1 | ibuf_functional_category=IO | ibuf_used=5
ibufds_gte2_functional_category=IO | ibufds_gte2_used=1 | lut1_functional_category=LUT | lut1_used=12
lut2_functional_category=LUT | lut2_used=117 | lut3_functional_category=LUT | lut3_used=211
lut4_functional_category=LUT | lut4_used=154 | lut5_functional_category=LUT | lut5_used=100
lut6_functional_category=LUT | lut6_used=183 | mmcme2_adv_functional_category=Clock | mmcme2_adv_used=1
obuf_functional_category=IO | obuf_used=2 | pcie_2_1_functional_category=Specialized Resource | pcie_2_1_used=1
ramb36e1_functional_category=Block Memory | ramb36e1_used=8 | srl16e_functional_category=Distributed Memory | srl16e_used=6
srlc32e_functional_category=Distributed Memory | srlc32e_used=7

slice_logic
f7_muxes_available=7300 | f7_muxes_fixed=0 | f7_muxes_used=0 | f7_muxes_util_percentage=0.00
f8_muxes_available=3650 | f8_muxes_fixed=0 | f8_muxes_used=0 | f8_muxes_util_percentage=0.00
lut_as_distributed_ram_fixed=0 | lut_as_distributed_ram_used=0 | lut_as_logic_available=14600 | lut_as_logic_fixed=0
lut_as_logic_used=677 | lut_as_logic_util_percentage=4.64 | lut_as_memory_available=5000 | lut_as_memory_fixed=0
lut_as_memory_used=11 | lut_as_memory_util_percentage=0.22 | lut_as_shift_register_fixed=0 | lut_as_shift_register_used=11
register_as_flip_flop_available=29200 | register_as_flip_flop_fixed=0 | register_as_flip_flop_used=1223 | register_as_flip_flop_util_percentage=4.19
register_as_latch_available=29200 | register_as_latch_fixed=0 | register_as_latch_used=0 | register_as_latch_util_percentage=0.00
slice_luts_available=14600 | slice_luts_fixed=0 | slice_luts_used=688 | slice_luts_util_percentage=4.71
slice_registers_available=29200 | slice_registers_fixed=0 | slice_registers_used=1223 | slice_registers_util_percentage=4.19
fully_used_lut_ff_pairs_fixed=4.19 | fully_used_lut_ff_pairs_used=61 | lut_as_distributed_ram_fixed=0 | lut_as_distributed_ram_used=0
lut_as_logic_available=14600 | lut_as_logic_fixed=0 | lut_as_logic_used=677 | lut_as_logic_util_percentage=4.64
lut_as_memory_available=5000 | lut_as_memory_fixed=0 | lut_as_memory_used=11 | lut_as_memory_util_percentage=0.22
lut_as_shift_register_fixed=0 | lut_as_shift_register_used=11 | lut_ff_pairs_with_one_unused_flip_flop_fixed=11 | lut_ff_pairs_with_one_unused_flip_flop_used=309
lut_ff_pairs_with_one_unused_lut_output_fixed=309 | lut_ff_pairs_with_one_unused_lut_output_used=365 | lut_flip_flop_pairs_available=14600 | lut_flip_flop_pairs_fixed=0
lut_flip_flop_pairs_used=443 | lut_flip_flop_pairs_util_percentage=3.03 | slice_available=3650 | slice_fixed=0
slice_used=363 | slice_util_percentage=9.95 | slicel_fixed=0 | slicel_used=229
slicem_fixed=0 | slicem_used=134 | unique_control_sets_used=32 | using_o5_and_o6_fixed=32
using_o5_and_o6_used=2 | using_o5_output_only_fixed=2 | using_o5_output_only_used=0 | using_o6_output_only_fixed=0

using_o6_output_only_used=9

specific_feature
bscane2_available=4 | bscane2_fixed=0 | bscane2_used=0 | bscane2_util_percentage=0.00
capturee2_available=1 | capturee2_fixed=0 | capturee2_used=0 | capturee2_util_percentage=0.00
dna_port_available=1 | dna_port_fixed=0 | dna_port_used=0 | dna_port_util_percentage=0.00
efuse_usr_available=1 | efuse_usr_fixed=0 | efuse_usr_used=0 | efuse_usr_util_percentage=0.00
frame_ecce2_available=1 | frame_ecce2_fixed=0 | frame_ecce2_used=0 | frame_ecce2_util_percentage=0.00
icape2_available=2 | icape2_fixed=0 | icape2_used=0 | icape2_util_percentage=0.00
pcie_2_1_available=1 | pcie_2_1_fixed=1 | pcie_2_1_used=1 | pcie_2_1_util_percentage=100.00
startupe2_available=1 | startupe2_fixed=0 | startupe2_used=0 | startupe2_util_percentage=0.00
xadc_available=1 | xadc_fixed=0 | xadc_used=0 | xadc_util_percentage=0.00

router

usage
actual_expansions=10004202 | bogomips=5602 | bram18=0 | bram36=8
bufg=0 | bufr=0 | congestion_level=0 | ctrls=32
dsp=0 | effort=2 | estimated_expansions=2286738 | ff=1223
global_clocks=4 | high_fanout_nets=2 | iob=1 | lut=721
movable_instances=2135 | nets=3295 | pins=14983 | pll=0
router_runtime=0.000000 | router_timing_driven=1 | threads=8 | timing_constraints_exist=1

synthesis

command_line_options
-assert=default::[not_specified] | -bufg=default::12 | -cascade_dsp=default::auto | -constrset=default::[not_specified]
-control_set_opt_threshold=default::auto | -directive=default::default | -fanout_limit=default::10000 | -flatten_hierarchy=default::rebuilt
-fsm_extraction=default::auto | -gated_clock_conversion=default::off | -generic=default::[not_specified] | -include_dirs=default::[not_specified]
-keep_equivalent_registers=default::[not_specified] | -max_bram=default::-1 | -max_bram_cascade_height=default::-1 | -max_dsp=default::-1
-max_uram=default::-1 | -max_uram_cascade_height=default::-1 | -mode=default::default | -name=default::[not_specified]
-no_lc=default::[not_specified] | -no_srlextract=default::[not_specified] | -no_timing_driven=default::[not_specified] | -part=xc7a25tcsg325-1
-resource_sharing=default::auto | -retiming=default::[not_specified] | -rtl=default::[not_specified] | -rtl_skip_constraints=default::[not_specified]
-rtl_skip_ip=default::[not_specified] | -seu_protect=default::none | -sfcu=default::[not_specified] | -shreg_min_size=default::3
-top=xilinx_pcie_2_1_ep_7x | -verilog_define=default::[not_specified]

usage
elapsed=00:00:58s | hls_ip=0 | memory_gain=476.348MB | memory_peak=1656.301MB
