TomKeddie/prj-artix7-pcie/fpga/test_xc7a12t_cpg238/test_xc7a12t_cpg238.runs/pcie_7x_0_synth_1/.vivado.begin.rst

<?xml version="1.0"?>
<ProcessHandle Version="1" Minor="0">
    <Process Command="vivado" Owner="tom" Host="z400" Pid="26144">
    </Process>
</ProcessHandle>
