TomKeddie/prj-artix7-pcie/fpga/v1/test_xc7a12t_cpg238/test_xc7a12t_cpg238.ip_user_files/sim_scripts/pcie_7x_0/activehdl/file_info.txt

xpm_cdc.sv,systemverilog,xil_defaultlib,../../../../../../../../../../../opt/Xilinx/Vivado/2018.1/data/ip/xpm/xpm_cdc/hdl/xpm_cdc.sv,
xpm_memory.sv,systemverilog,xil_defaultlib,../../../../../../../../../../../opt/Xilinx/Vivado/2018.1/data/ip/xpm/xpm_memory/hdl/xpm_memory.sv,
xpm_VCOMP.vhd,vhdl,xpm,../../../../../../../../../../../opt/Xilinx/Vivado/2018.1/data/ip/xpm/xpm_VCOMP.vhd,
pcie_7x_0_core_top.vhd,vhdl,xil_defaultlib,../../../../test_xc7a12t_cpg238.srcs/sources_1/ip/pcie_7x_0/source/pcie_7x_0_core_top.vhd,
pcie_7x_0_pipe_drp.v,verilog,xil_defaultlib,../../../../test_xc7a12t_cpg238.srcs/sources_1/ip/pcie_7x_0/source/pcie_7x_0_pipe_drp.v,
pcie_7x_0_pipe_eq.v,verilog,xil_defaultlib,../../../../test_xc7a12t_cpg238.srcs/sources_1/ip/pcie_7x_0/source/pcie_7x_0_pipe_eq.v,
pcie_7x_0_pipe_rate.v,verilog,xil_defaultlib,../../../../test_xc7a12t_cpg238.srcs/sources_1/ip/pcie_7x_0/source/pcie_7x_0_pipe_rate.v,
pcie_7x_0_pipe_reset.v,verilog,xil_defaultlib,../../../../test_xc7a12t_cpg238.srcs/sources_1/ip/pcie_7x_0/source/pcie_7x_0_pipe_reset.v,
pcie_7x_0_pipe_sync.v,verilog,xil_defaultlib,../../../../test_xc7a12t_cpg238.srcs/sources_1/ip/pcie_7x_0/source/pcie_7x_0_pipe_sync.v,
pcie_7x_0_gtp_pipe_rate.v,verilog,xil_defaultlib,../../../../test_xc7a12t_cpg238.srcs/sources_1/ip/pcie_7x_0/source/pcie_7x_0_gtp_pipe_rate.v,
pcie_7x_0_gtp_pipe_drp.v,verilog,xil_defaultlib,../../../../test_xc7a12t_cpg238.srcs/sources_1/ip/pcie_7x_0/source/pcie_7x_0_gtp_pipe_drp.v,
pcie_7x_0_gtp_pipe_reset.v,verilog,xil_defaultlib,../../../../test_xc7a12t_cpg238.srcs/sources_1/ip/pcie_7x_0/source/pcie_7x_0_gtp_pipe_reset.v,
pcie_7x_0_pipe_user.v,verilog,xil_defaultlib,../../../../test_xc7a12t_cpg238.srcs/sources_1/ip/pcie_7x_0/source/pcie_7x_0_pipe_user.v,
pcie_7x_0_pipe_wrapper.v,verilog,xil_defaultlib,../../../../test_xc7a12t_cpg238.srcs/sources_1/ip/pcie_7x_0/source/pcie_7x_0_pipe_wrapper.v,
pcie_7x_0_qpll_drp.v,verilog,xil_defaultlib,../../../../test_xc7a12t_cpg238.srcs/sources_1/ip/pcie_7x_0/source/pcie_7x_0_qpll_drp.v,
pcie_7x_0_qpll_reset.v,verilog,xil_defaultlib,../../../../test_xc7a12t_cpg238.srcs/sources_1/ip/pcie_7x_0/source/pcie_7x_0_qpll_reset.v,
pcie_7x_0_qpll_wrapper.v,verilog,xil_defaultlib,../../../../test_xc7a12t_cpg238.srcs/sources_1/ip/pcie_7x_0/source/pcie_7x_0_qpll_wrapper.v,
pcie_7x_0_rxeq_scan.v,verilog,xil_defaultlib,../../../../test_xc7a12t_cpg238.srcs/sources_1/ip/pcie_7x_0/source/pcie_7x_0_rxeq_scan.v,
pcie_7x_0_axi_basic_rx_null_gen.vhd,vhdl,xil_defaultlib,../../../../test_xc7a12t_cpg238.srcs/sources_1/ip/pcie_7x_0/source/pcie_7x_0_axi_basic_rx_null_gen.vhd,
pcie_7x_0_axi_basic_rx_pipeline.vhd,vhdl,xil_defaultlib,../../../../test_xc7a12t_cpg238.srcs/sources_1/ip/pcie_7x_0/source/pcie_7x_0_axi_basic_rx_pipeline.vhd,
pcie_7x_0_axi_basic_rx.vhd,vhdl,xil_defaultlib,../../../../test_xc7a12t_cpg238.srcs/sources_1/ip/pcie_7x_0/source/pcie_7x_0_axi_basic_rx.vhd,
pcie_7x_0_axi_basic_top.vhd,vhdl,xil_defaultlib,../../../../test_xc7a12t_cpg238.srcs/sources_1/ip/pcie_7x_0/source/pcie_7x_0_axi_basic_top.vhd,
pcie_7x_0_axi_basic_tx_pipeline.vhd,vhdl,xil_defaultlib,../../../../test_xc7a12t_cpg238.srcs/sources_1/ip/pcie_7x_0/source/pcie_7x_0_axi_basic_tx_pipeline.vhd,
pcie_7x_0_axi_basic_tx_thrtl_ctl.vhd,vhdl,xil_defaultlib,../../../../test_xc7a12t_cpg238.srcs/sources_1/ip/pcie_7x_0/source/pcie_7x_0_axi_basic_tx_thrtl_ctl.vhd,
pcie_7x_0_axi_basic_tx.vhd,vhdl,xil_defaultlib,../../../../test_xc7a12t_cpg238.srcs/sources_1/ip/pcie_7x_0/source/pcie_7x_0_axi_basic_tx.vhd,
pcie_7x_0_pcie_7x.vhd,vhdl,xil_defaultlib,../../../../test_xc7a12t_cpg238.srcs/sources_1/ip/pcie_7x_0/source/pcie_7x_0_pcie_7x.vhd,
pcie_7x_0_pcie_bram_7x.vhd,vhdl,xil_defaultlib,../../../../test_xc7a12t_cpg238.srcs/sources_1/ip/pcie_7x_0/source/pcie_7x_0_pcie_bram_7x.vhd,
pcie_7x_0_pcie_bram_top_7x.vhd,vhdl,xil_defaultlib,../../../../test_xc7a12t_cpg238.srcs/sources_1/ip/pcie_7x_0/source/pcie_7x_0_pcie_bram_top_7x.vhd,
pcie_7x_0_pcie_brams_7x.vhd,vhdl,xil_defaultlib,../../../../test_xc7a12t_cpg238.srcs/sources_1/ip/pcie_7x_0/source/pcie_7x_0_pcie_brams_7x.vhd,
pcie_7x_0_pcie_pipe_lane.vhd,vhdl,xil_defaultlib,../../../../test_xc7a12t_cpg238.srcs/sources_1/ip/pcie_7x_0/source/pcie_7x_0_pcie_pipe_lane.vhd,
pcie_7x_0_pcie_pipe_misc.vhd,vhdl,xil_defaultlib,../../../../test_xc7a12t_cpg238.srcs/sources_1/ip/pcie_7x_0/source/pcie_7x_0_pcie_pipe_misc.vhd,
pcie_7x_0_pcie_pipe_pipeline.vhd,vhdl,xil_defaultlib,../../../../test_xc7a12t_cpg238.srcs/sources_1/ip/pcie_7x_0/source/pcie_7x_0_pcie_pipe_pipeline.vhd,
pcie_7x_0_gt_rx_valid_filter_7x.vhd,vhdl,xil_defaultlib,../../../../test_xc7a12t_cpg238.srcs/sources_1/ip/pcie_7x_0/source/pcie_7x_0_gt_rx_valid_filter_7x.vhd,
pcie_7x_0_gt_top.vhd,vhdl,xil_defaultlib,../../../../test_xc7a12t_cpg238.srcs/sources_1/ip/pcie_7x_0/source/pcie_7x_0_gt_top.vhd,
pcie_7x_0_gt_wrapper.v,verilog,xil_defaultlib,../../../../test_xc7a12t_cpg238.srcs/sources_1/ip/pcie_7x_0/source/pcie_7x_0_gt_wrapper.v,
pcie_7x_0_gt_common.v,verilog,xil_defaultlib,../../../../test_xc7a12t_cpg238.srcs/sources_1/ip/pcie_7x_0/source/pcie_7x_0_gt_common.v,
pcie_7x_0_gtp_cpllpd_ovrd.v,verilog,xil_defaultlib,../../../../test_xc7a12t_cpg238.srcs/sources_1/ip/pcie_7x_0/source/pcie_7x_0_gtp_cpllpd_ovrd.v,
pcie_7x_0_gtx_cpllpd_ovrd.v,verilog,xil_defaultlib,../../../../test_xc7a12t_cpg238.srcs/sources_1/ip/pcie_7x_0/source/pcie_7x_0_gtx_cpllpd_ovrd.v,
pcie_7x_0_pcie_top.vhd,vhdl,xil_defaultlib,../../../../test_xc7a12t_cpg238.srcs/sources_1/ip/pcie_7x_0/source/pcie_7x_0_pcie_top.vhd,
pcie_7x_0_pcie2_top.vhd,vhdl,xil_defaultlib,../../../../test_xc7a12t_cpg238.srcs/sources_1/ip/pcie_7x_0/source/pcie_7x_0_pcie2_top.vhd,
pcie_7x_0.vhd,vhdl,xil_defaultlib,../../../../test_xc7a12t_cpg238.srcs/sources_1/ip/pcie_7x_0/sim/pcie_7x_0.vhd,
glbl.v,Verilog,xil_defaultlib,glbl.v
