TomKeddie/prj-artix7-pcie/fpga/v1/test_xc7a25t_csg325/test_xc7a25t_csg325.ip_user_files/sim_scripts/pcie_7x_0/activehdl/file_info.txt

xpm_cdc.sv,systemverilog,xil_defaultlib,../../../../../../../../../../../../../opt/Xilinx/Vivado/2018.1/data/ip/xpm/xpm_cdc/hdl/xpm_cdc.sv,incdir="../../../../test_xc7a25t_csg325.srcs/sources_1/ip/pcie_7x_0/ip_0/hdl/verilog"
xpm_memory.sv,systemverilog,xil_defaultlib,../../../../../../../../../../../../../opt/Xilinx/Vivado/2018.1/data/ip/xpm/xpm_memory/hdl/xpm_memory.sv,incdir="../../../../test_xc7a25t_csg325.srcs/sources_1/ip/pcie_7x_0/ip_0/hdl/verilog"
xpm_VCOMP.vhd,vhdl,xpm,../../../../../../../../../../../../../opt/Xilinx/Vivado/2018.1/data/ip/xpm/xpm_VCOMP.vhd,incdir="../../../../test_xc7a25t_csg325.srcs/sources_1/ip/pcie_7x_0/ip_0/hdl/verilog"
jtag_axi_v1_2_rfs.v,verilog,jtag_axi,../../../ipstatic/hdl/jtag_axi_v1_2_rfs.v,incdir="../../../../test_xc7a25t_csg325.srcs/sources_1/ip/pcie_7x_0/ip_0/hdl/verilog"
pcie_7x_0_jtag.v,verilog,xil_defaultlib,../../../../test_xc7a25t_csg325.srcs/sources_1/ip/pcie_7x_0/ip_0/sim/pcie_7x_0_jtag.v,incdir="../../../../test_xc7a25t_csg325.srcs/sources_1/ip/pcie_7x_0/ip_0/hdl/verilog"
pcie_7x_0_core_top.vhd,vhdl,xil_defaultlib,../../../../test_xc7a25t_csg325.srcs/sources_1/ip/pcie_7x_0/source/pcie_7x_0_core_top.vhd,incdir="../../../../test_xc7a25t_csg325.srcs/sources_1/ip/pcie_7x_0/ip_0/hdl/verilog"
pcie_7x_0_pipe_drp.v,verilog,xil_defaultlib,../../../../test_xc7a25t_csg325.srcs/sources_1/ip/pcie_7x_0/source/pcie_7x_0_pipe_drp.v,incdir="../../../../test_xc7a25t_csg325.srcs/sources_1/ip/pcie_7x_0/ip_0/hdl/verilog"
pcie_7x_0_pipe_eq.v,verilog,xil_defaultlib,../../../../test_xc7a25t_csg325.srcs/sources_1/ip/pcie_7x_0/source/pcie_7x_0_pipe_eq.v,incdir="../../../../test_xc7a25t_csg325.srcs/sources_1/ip/pcie_7x_0/ip_0/hdl/verilog"
pcie_7x_0_pipe_rate.v,verilog,xil_defaultlib,../../../../test_xc7a25t_csg325.srcs/sources_1/ip/pcie_7x_0/source/pcie_7x_0_pipe_rate.v,incdir="../../../../test_xc7a25t_csg325.srcs/sources_1/ip/pcie_7x_0/ip_0/hdl/verilog"
pcie_7x_0_pipe_reset.v,verilog,xil_defaultlib,../../../../test_xc7a25t_csg325.srcs/sources_1/ip/pcie_7x_0/source/pcie_7x_0_pipe_reset.v,incdir="../../../../test_xc7a25t_csg325.srcs/sources_1/ip/pcie_7x_0/ip_0/hdl/verilog"
pcie_7x_0_pipe_sync.v,verilog,xil_defaultlib,../../../../test_xc7a25t_csg325.srcs/sources_1/ip/pcie_7x_0/source/pcie_7x_0_pipe_sync.v,incdir="../../../../test_xc7a25t_csg325.srcs/sources_1/ip/pcie_7x_0/ip_0/hdl/verilog"
pcie_7x_0_gtp_pipe_rate.v,verilog,xil_defaultlib,../../../../test_xc7a25t_csg325.srcs/sources_1/ip/pcie_7x_0/source/pcie_7x_0_gtp_pipe_rate.v,incdir="../../../../test_xc7a25t_csg325.srcs/sources_1/ip/pcie_7x_0/ip_0/hdl/verilog"
pcie_7x_0_gtp_pipe_drp.v,verilog,xil_defaultlib,../../../../test_xc7a25t_csg325.srcs/sources_1/ip/pcie_7x_0/source/pcie_7x_0_gtp_pipe_drp.v,incdir="../../../../test_xc7a25t_csg325.srcs/sources_1/ip/pcie_7x_0/ip_0/hdl/verilog"
pcie_7x_0_gtp_pipe_reset.v,verilog,xil_defaultlib,../../../../test_xc7a25t_csg325.srcs/sources_1/ip/pcie_7x_0/source/pcie_7x_0_gtp_pipe_reset.v,incdir="../../../../test_xc7a25t_csg325.srcs/sources_1/ip/pcie_7x_0/ip_0/hdl/verilog"
pcie_7x_0_pipe_user.v,verilog,xil_defaultlib,../../../../test_xc7a25t_csg325.srcs/sources_1/ip/pcie_7x_0/source/pcie_7x_0_pipe_user.v,incdir="../../../../test_xc7a25t_csg325.srcs/sources_1/ip/pcie_7x_0/ip_0/hdl/verilog"
pcie_7x_0_pipe_wrapper.v,verilog,xil_defaultlib,../../../../test_xc7a25t_csg325.srcs/sources_1/ip/pcie_7x_0/source/pcie_7x_0_pipe_wrapper.v,incdir="../../../../test_xc7a25t_csg325.srcs/sources_1/ip/pcie_7x_0/ip_0/hdl/verilog"
pcie_7x_0_qpll_reset.v,verilog,xil_defaultlib,../../../../test_xc7a25t_csg325.srcs/sources_1/ip/pcie_7x_0/source/pcie_7x_0_qpll_reset.v,incdir="../../../../test_xc7a25t_csg325.srcs/sources_1/ip/pcie_7x_0/ip_0/hdl/verilog"
pcie_7x_0_rxeq_scan.v,verilog,xil_defaultlib,../../../../test_xc7a25t_csg325.srcs/sources_1/ip/pcie_7x_0/source/pcie_7x_0_rxeq_scan.v,incdir="../../../../test_xc7a25t_csg325.srcs/sources_1/ip/pcie_7x_0/ip_0/hdl/verilog"
pcie_7x_0_axi_basic_rx_null_gen.vhd,vhdl,xil_defaultlib,../../../../test_xc7a25t_csg325.srcs/sources_1/ip/pcie_7x_0/source/pcie_7x_0_axi_basic_rx_null_gen.vhd,incdir="../../../../test_xc7a25t_csg325.srcs/sources_1/ip/pcie_7x_0/ip_0/hdl/verilog"
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
pcie_7x_0.vhd,vhdl,xil_defaultlib,../../../../test_xc7a25t_csg325.srcs/sources_1/ip/pcie_7x_0/sim/pcie_7x_0.vhd,incdir="../../../../test_xc7a25t_csg325.srcs/sources_1/ip/pcie_7x_0/ip_0/hdl/verilog"
glbl.v,Verilog,xil_defaultlib,glbl.v
