TomKeddie/prj-artix7-pcie/hardware/v2/bringup/rc2/power-sequence-saleae.png

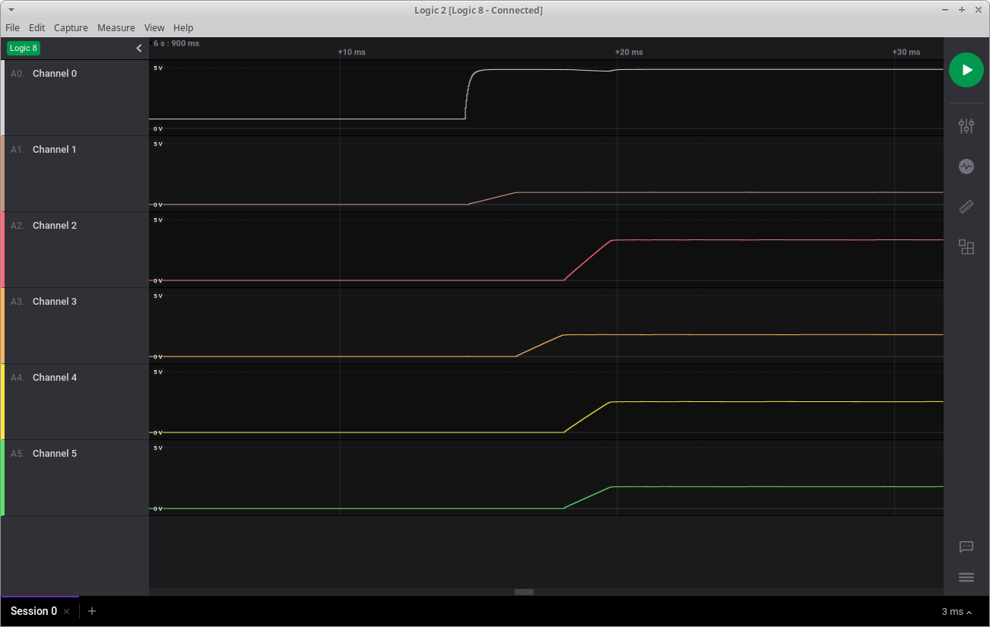
hardware/v2/bringup/rc2/power-sequence-saleae.png
