TomKeddie/prj-artix7-pcie/hardware/v2/artix7-pcie-v2.kicad_pcb

## KiCad design hardware/v2/artix7-pcie-v2.kicad_pcb (2020-12-11)

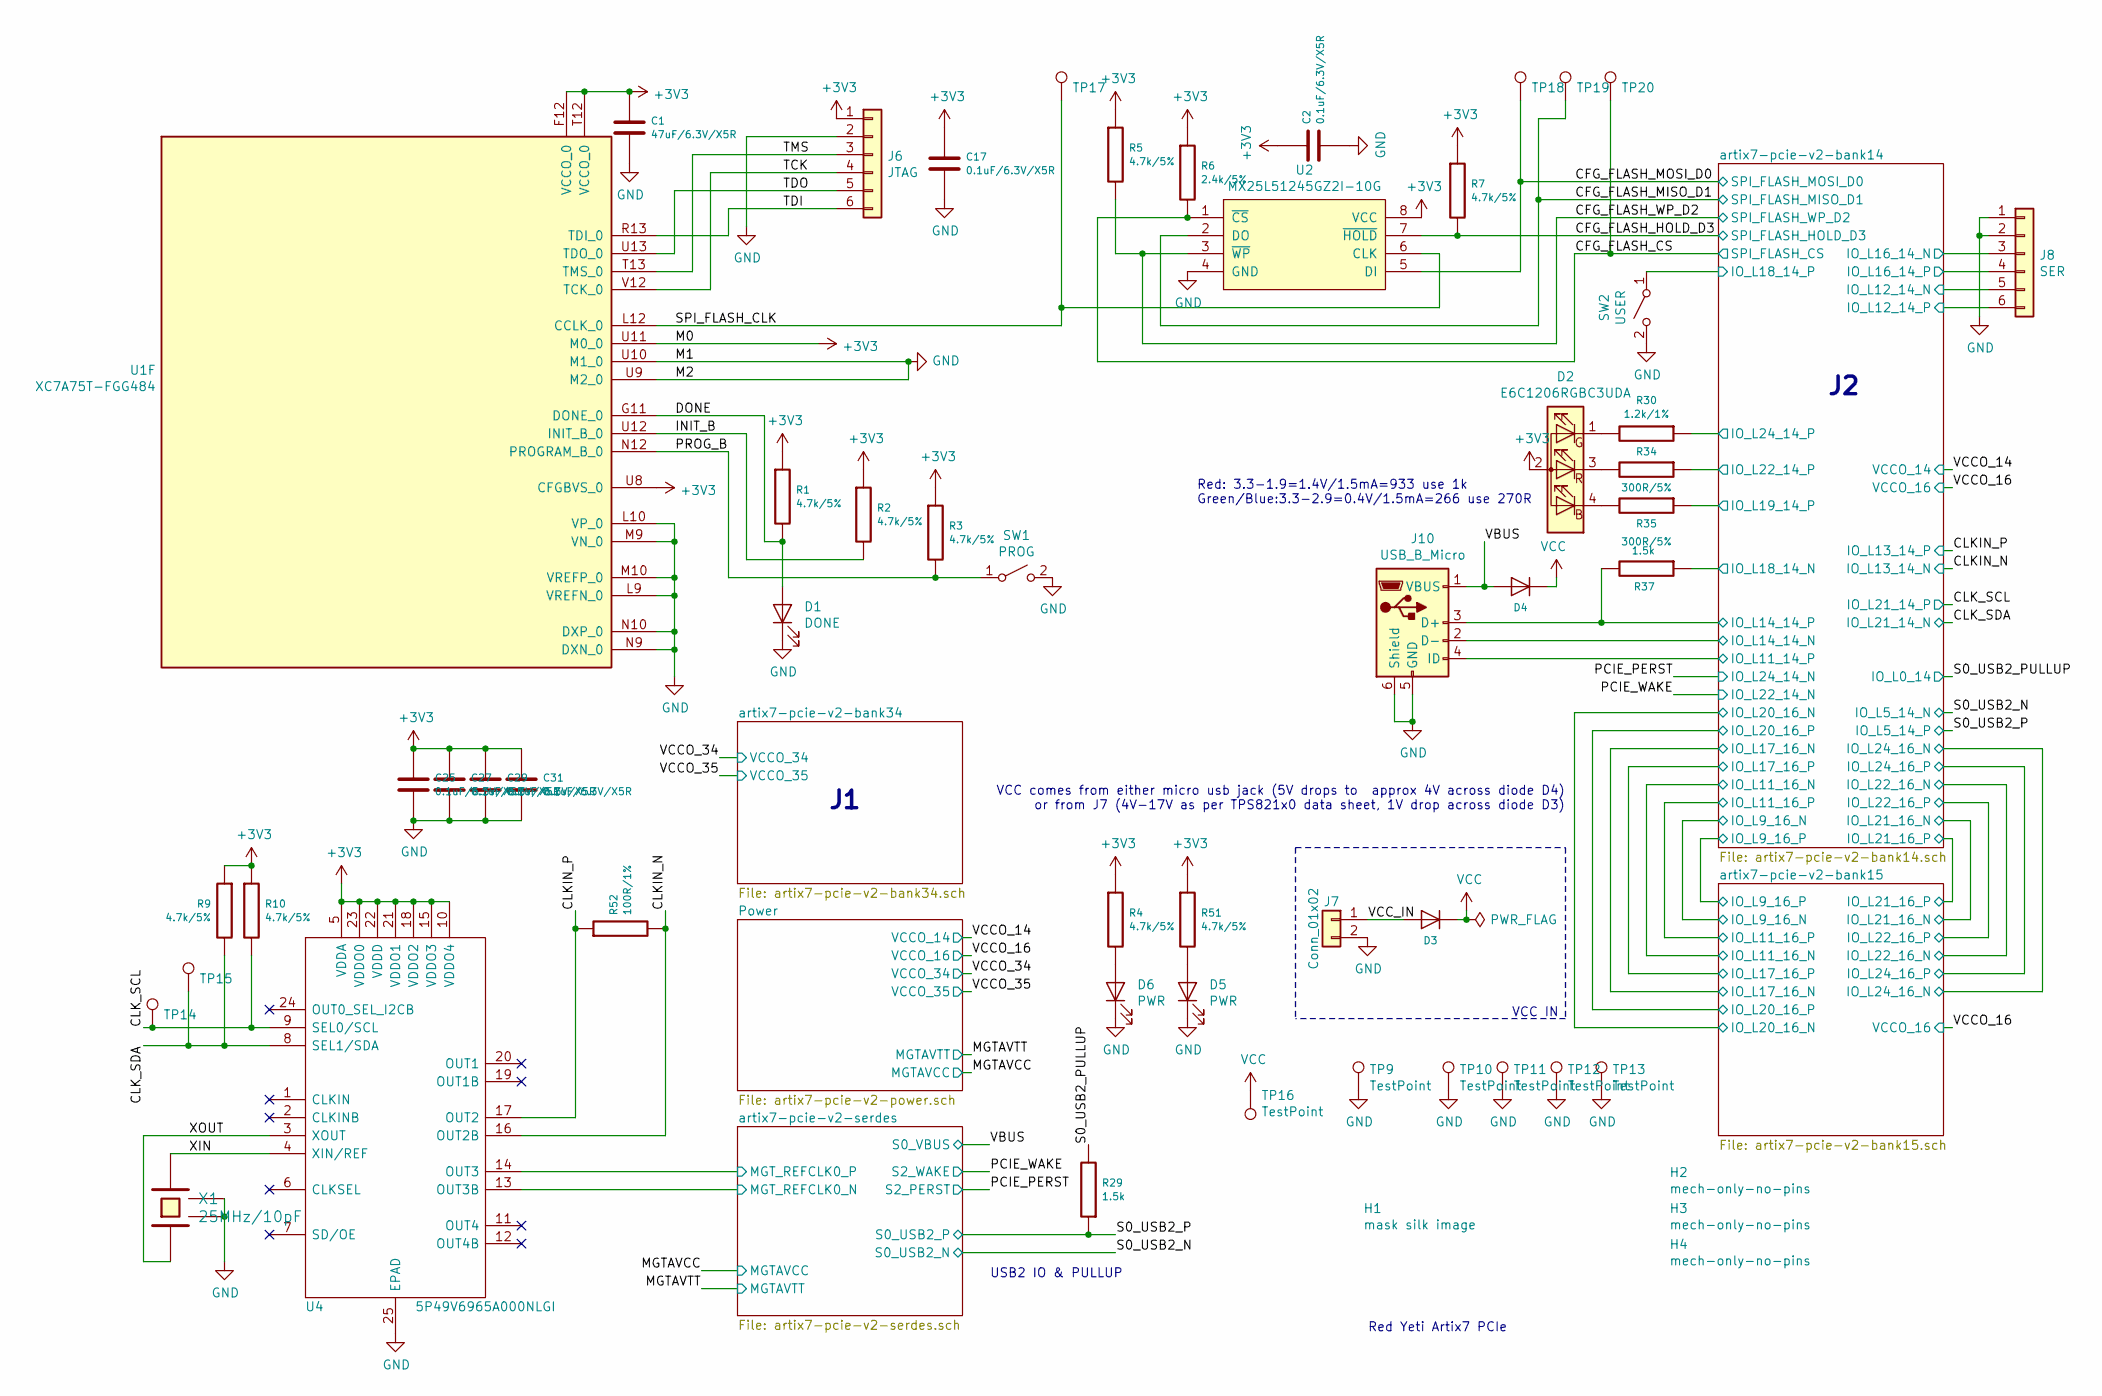
[picture p15: schematic artix7-pcie-v2.sch]

Parts:
C1: 47uF/6.3V/X5R; C_1206_3216Metric; LCSC C96123
C2, C17, C25, C27, C29, C31: 0.1uF/6.3V/X5R; C_0402_1005Metric; LCSC C1525
D1: DONE; LED_0402_1005Metric; LCSC C130722
D2: E6C1206RGBC3UDA; LCSC C375571
D3, D4: SBR3U20SA-13; D_SMA; LCSC C146738
D5, D6: PWR; LED_0402_1005Metric; LCSC C130724
H1: mask silk image; mask; LCSC DNP
H2, H3, H4: mech-only-no-pins; JLCPCB_ASSEMBLY_TOOL_HOLE; LCSC DNP
J6: JTAG; PinHeader_2x03_P2.54mm_Vertical; LCSC DNP
J7: Conn_01x02; JST-2-SMD; LCSC DNP
J8: SER; PinHeader_2x03_P2.54mm_Vertical; LCSC DNP
J10: USB_B_Micro; USB_MICRO_TAOBAO_SMD_PTH; LCSC DNP
R1, R2, R3, R4, R5, R7, R9, R10, R51: 4.7k/5%; R_0402_1005Metric; LCSC C25900
R6: 2.4k/5%; R_0402_1005Metric; LCSC C25882
R29, R37: 1.5k; R_0402_1005Metric; LCSC C25867
R30: 1.2k/1%; R_0402_1005Metric; LCSC C25862
R34, R35: 300R/5%; R_0402_1005Metric; LCSC C25102
R52: 100R/1%; R_0402_1005Metric; LCSC C25076
SW1: PROG; SW_Push_1P1T_NO_Vertical_Wuerth_434133025816; LCSC DNP
SW2: USER; SW_Push_1P1T_NO_Vertical_Wuerth_434133025816; LCSC DNP
TP9: TestPoint; TestPoint_Loop_D2.50mm_Drill1.0mm; LCSC DNP
TP10, TP11, TP12, TP13: TestPoint; MountingHole_2.7mm_M2.5_DIN965_Pad; LCSC DNP
TP14: SCL; TestPoint_Pad_D1.5mm; LCSC DNP
TP15: SDA; TestPoint_Pad_D1.5mm; LCSC DNP
TP16, TP17, TP18, TP19, TP20: TestPoint; TestPoint_Pad_D1.5mm; LCSC DNP
U1: XC7A75T-FGG484; Xilinx_FGG484; LCSC DNP
U2: MX25L51245GZ2I-10G; WSON-8-1EP_8x6mm_P1.27mm; LCSC DNP
U4: 5P49V6965A000NLGI; QFN50P400X400X100-25N-D; Mouser Part Number 972-49V6965A000NLGI
X1: 25MHz/10pF; Crystal_SMD_3225-4Pin_3.2x2.5mm; LCSC C9006

Connections:
+3V3: C1.1, C2.1, C17.1, C25.1, C27.1, C29.1, C31.1, D2.2 (A), J6.1, R1.1, R2.1, R3.1, R4.1, R5.1, R6.1, R7.1, R9.1, R10.1, R51.1, U1.F12 (VCCO_0), U1.T12 (VCCO_0), U1.U8 (CFGBVS_0), U1.U11 (M0_0), U2.8 (VCC), U4.5 (VDDA), U4.10 (VDDO4), U4.15 (VDDO3), U4.18 (VDDO2), U4.21 (VDDO1), U4.22 (VDDD), U4.23 (VDDO0); also elsewhere on the board
/CFG_FLASH_CS: R6.2, TP20.1, U2.1 (~CS); also elsewhere on the board
/CFG_FLASH_HOLD_D3: R7.2, U2.7 (~HOLD); also elsewhere on the board
/CFG_FLASH_MISO_D1: TP19.1, U2.2 (DO); also elsewhere on the board
/CFG_FLASH_MOSI_D0: TP18.1, U2.5 (DI); also elsewhere on the board
/CFG_FLASH_WP_D2: R5.2, U2.3 (~WP); also elsewhere on the board
/CLKIN_N: R52.2, U4.16 (OUT2B); also elsewhere on the board
/CLKIN_P: R52.1, U4.17 (OUT2); also elsewhere on the board
/CLK_SCL: R10.2, TP14.1, U4.9 (SEL0/SCL); also elsewhere on the board
/CLK_SDA: R9.2, TP15.1, U4.8 (SEL1/SDA); also elsewhere on the board
/DONE: D1.2 (A), R1.2, U1.G11 (DONE_0)
/INIT_B: R2.2, U1.U12 (INIT_B_0)
/PROG_B: R3.2, SW1.1 (A), U1.N12 (PROGRAM_B_0)
/S0_USB2_P: R29.1; also elsewhere on the board
/S0_USB2_PULLUP: R29.2; also elsewhere on the board
/SPI_FLASH_CLK: TP17.1, U1.L12 (CCLK_0), U2.6 (CLK)
/TCK: J6.4, U1.V12 (TCK_0)
/TDI: J6.6, U1.R13 (TDI_0)
/TDO: J6.5, U1.U13 (TDO_0)
/TMS: J6.3, U1.T13 (TMS_0)
/VBUS: D4.2 (A), J10.1 (VBUS); also elsewhere on the board
/VCC_IN: D3.2 (A), J7.1
/XIN: U4.4 (XIN/REF), X1.3
/XOUT: U4.3 (XOUT), X1.1
/artix7-pcie-v2-bank14/IO_L11_14_P: J10.4 (ID); also elsewhere on the board
/artix7-pcie-v2-bank14/IO_L12_14_N: J8.5; also elsewhere on the board
/artix7-pcie-v2-bank14/IO_L12_14_P: J8.6; also elsewhere on the board
/artix7-pcie-v2-bank14/IO_L14_14_N: J10.2 (D-); also elsewhere on the board
/artix7-pcie-v2-bank14/IO_L14_14_P: J10.3 (D+), R37.2; also elsewhere on the board
/artix7-pcie-v2-bank14/IO_L16_14_N: J8.3; also elsewhere on the board
/artix7-pcie-v2-bank14/IO_L16_14_P: J8.4; also elsewhere on the board
/artix7-pcie-v2-bank14/IO_L18_14_N: R37.1; also elsewhere on the board
/artix7-pcie-v2-bank14/IO_L18_14_P: SW2.1 (A); also elsewhere on the board
/artix7-pcie-v2-bank14/IO_L19_14_P: R35.1; also elsewhere on the board
/artix7-pcie-v2-bank14/IO_L22_14_P: R34.1; also elsewhere on the board
/artix7-pcie-v2-bank14/IO_L24_14_P: R30.1; also elsewhere on the board
/artix7-pcie-v2-serdes/MGT_REFCLK0_N: U4.13 (OUT3B); also elsewhere on the board
/artix7-pcie-v2-serdes/MGT_REFCLK0_P: U4.14 (OUT3); also elsewhere on the board
GND: C1.2, C2.2, C17.2, C25.2, C27.2, C29.2, C31.2, D1.1 (K), D5.1 (K), D6.1 (K), J6.2, J7.2, J8.1, J8.2, J10.5 (GND), J10.6 (Shield), SW1.2 (B), SW2.2 (B), TP9.1, TP10.1, TP11.1, TP12.1, TP13.1, U1.L9 (VREFN_0), U1.L10 (VP_0), U1.M9 (VN_0), U1.M10 (VREFP_0), U1.N9 (DXN_0), U1.N10 (DXP_0), U1.U9 (M2_0), U1.U10 (M1_0), U2.4 (GND), U4.25 (EPAD), X1.2 (GND), X1.4 (GND); also elsewhere on the board
unnamed: D2.1 (G), R30.2
unnamed: D2.3 (R), R34.2
unnamed: D2.4 (B), R35.2
unnamed: D5.2 (A), R51.2
unnamed: D6.2 (A), R4.2
VCC: D3.1 (K), D4.1 (K), TP16.1; also elsewhere on the board

Notes on the sheet:
USB2 IO & PULLUP
VCC IN
Red: 3.3-1.9=1.4V/1.5mA=933 use 1k Green/Blue:3.3-2.9=0.4V/1.5mA=266 use 270R
VCC comes from either micro usb jack (5V drops to approx 4V across diode D4) or from J7 (4V-17V as per TPS821x0 data sheet, 1V drop across diode D3)
Red Yeti Artix7 PCIe

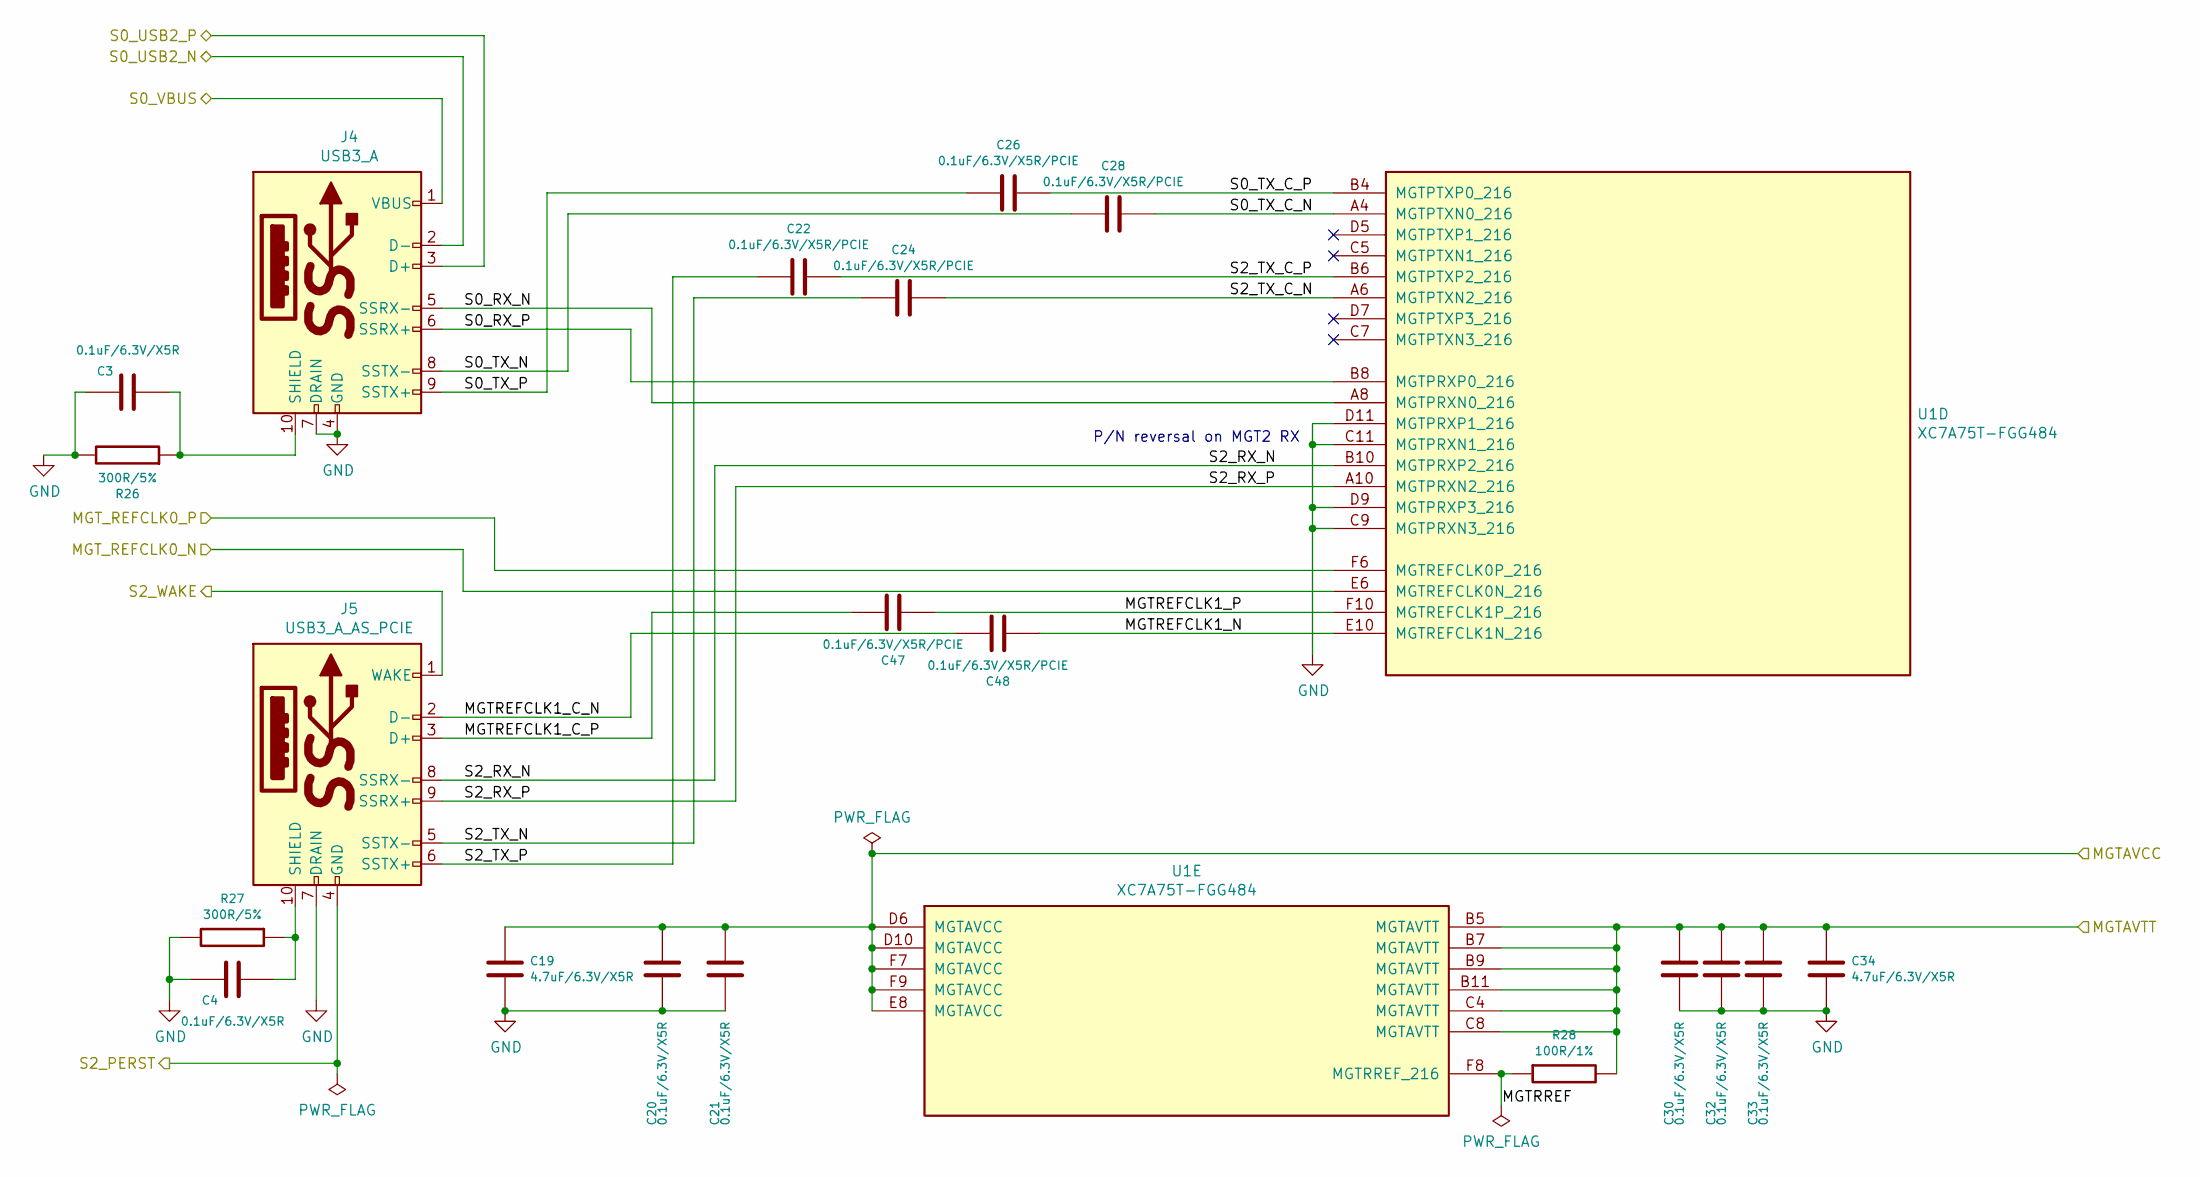
[picture p16: schematic artix7-pcie-v2-serdes.sch]

Parts:
C3, C4, C20, C21, C30, C32, C33: 0.1uF/6.3V/X5R; C_0402_1005Metric; LCSC C1525
C19, C34: 4.7uF/6.3V/X5R; C_0402_1005Metric; LCSC C23733
C22, C24, C26, C28, C47, C48: 0.1uF/6.3V/X5R/PCIE; C_0402_1005Metric; LCSC C1525
J4: USB3_A; USB3_A_Aliexpress; Digikey 2057-USB-A3-S-RA-ND
J5: USB3_A_AS_PCIE; USB3_A_Aliexpress; Digikey 2057-USB-A3-S-RA-ND
R26, R27: 300R/5%; R_0402_1005Metric; LCSC C25102
R28: 100R/1%; R_0402_1005Metric; LCSC C25076
U1: XC7A75T-FGG484; Xilinx_FGG484; LCSC DNP

Connections:
+1V0: C19.1, C20.1, C21.1, U1.D6 (MGTAVCC), U1.D10 (MGTAVCC), U1.E8 (MGTAVCC), U1.F7 (MGTAVCC), U1.F9 (MGTAVCC); also elsewhere on the board
/MGTAVTT: C30.1, C32.1, C33.1, C34.1, R28.2, U1.B5 (MGTAVTT), U1.B7 (MGTAVTT), U1.B9 (MGTAVTT), U1.B11 (MGTAVTT), U1.C4 (MGTAVTT), U1.C8 (MGTAVTT); also elsewhere on the board
/PCIE_PERST: J5.4 (GND); also elsewhere on the board
/PCIE_WAKE: J5.1 (WAKE); also elsewhere on the board
/S0_USB2_N: J4.2 (D-); also elsewhere on the board
/S0_USB2_P: J4.3 (D+); also elsewhere on the board
/VBUS: J4.1 (VBUS); also elsewhere on the board
/artix7-pcie-v2-serdes/MGTREFCLK1_C_N: C48.2, J5.2 (D-)
/artix7-pcie-v2-serdes/MGTREFCLK1_C_P: C47.2, J5.3 (D+)
/artix7-pcie-v2-serdes/MGTREFCLK1_N: C48.1, U1.E10 (MGTREFCLK1N_216)
/artix7-pcie-v2-serdes/MGTREFCLK1_P: C47.1, U1.F10 (MGTREFCLK1P_216)
/artix7-pcie-v2-serdes/MGTRREF: R28.1, U1.F8 (MGTRREF_216)
/artix7-pcie-v2-serdes/MGT_REFCLK0_N: U1.E6 (MGTREFCLK0N_216); also elsewhere on the board
/artix7-pcie-v2-serdes/MGT_REFCLK0_P: U1.F6 (MGTREFCLK0P_216); also elsewhere on the board
/artix7-pcie-v2-serdes/S0_RX_N: J4.5 (SSRX-), U1.A8 (MGTPRXN0_216)
/artix7-pcie-v2-serdes/S0_RX_P: J4.6 (SSRX+), U1.B8 (MGTPRXP0_216)
/artix7-pcie-v2-serdes/S0_TX_C_N: C28.1, U1.A4 (MGTPTXN0_216)
/artix7-pcie-v2-serdes/S0_TX_C_P: C26.1, U1.B4 (MGTPTXP0_216)
/artix7-pcie-v2-serdes/S0_TX_N: C28.2, J4.8 (SSTX-)
/artix7-pcie-v2-serdes/S0_TX_P: C26.2, J4.9 (SSTX+)
/artix7-pcie-v2-serdes/S2_RX_N: J5.8 (SSRX-), U1.B10 (MGTPRXP2_216)
/artix7-pcie-v2-serdes/S2_RX_P: J5.9 (SSRX+), U1.A10 (MGTPRXN2_216)
/artix7-pcie-v2-serdes/S2_TX_C_N: C24.1, U1.A6 (MGTPTXN2_216)
/artix7-pcie-v2-serdes/S2_TX_C_P: C22.1, U1.B6 (MGTPTXP2_216)
/artix7-pcie-v2-serdes/S2_TX_N: C24.2, J5.5 (SSTX-)
/artix7-pcie-v2-serdes/S2_TX_P: C22.2, J5.6 (SSTX+)
GND: C3.2, C4.2, C19.2, C20.2, C21.2, C30.2, C32.2, C33.2, C34.2, J4.4 (GND), J4.7 (DRAIN), J5.7 (DRAIN), R26.2, R27.2, U1.C9 (MGTPRXN3_216), U1.C11 (MGTPRXN1_216), U1.D9 (MGTPRXP3_216), U1.D11 (MGTPRXP1_216); also elsewhere on the board
unnamed: C3.1, J4.10 (SHIELD), R26.1
unnamed: C4.1, J5.10 (SHIELD), R27.1

Notes on the sheet:
P/N reversal on MGT2 RX

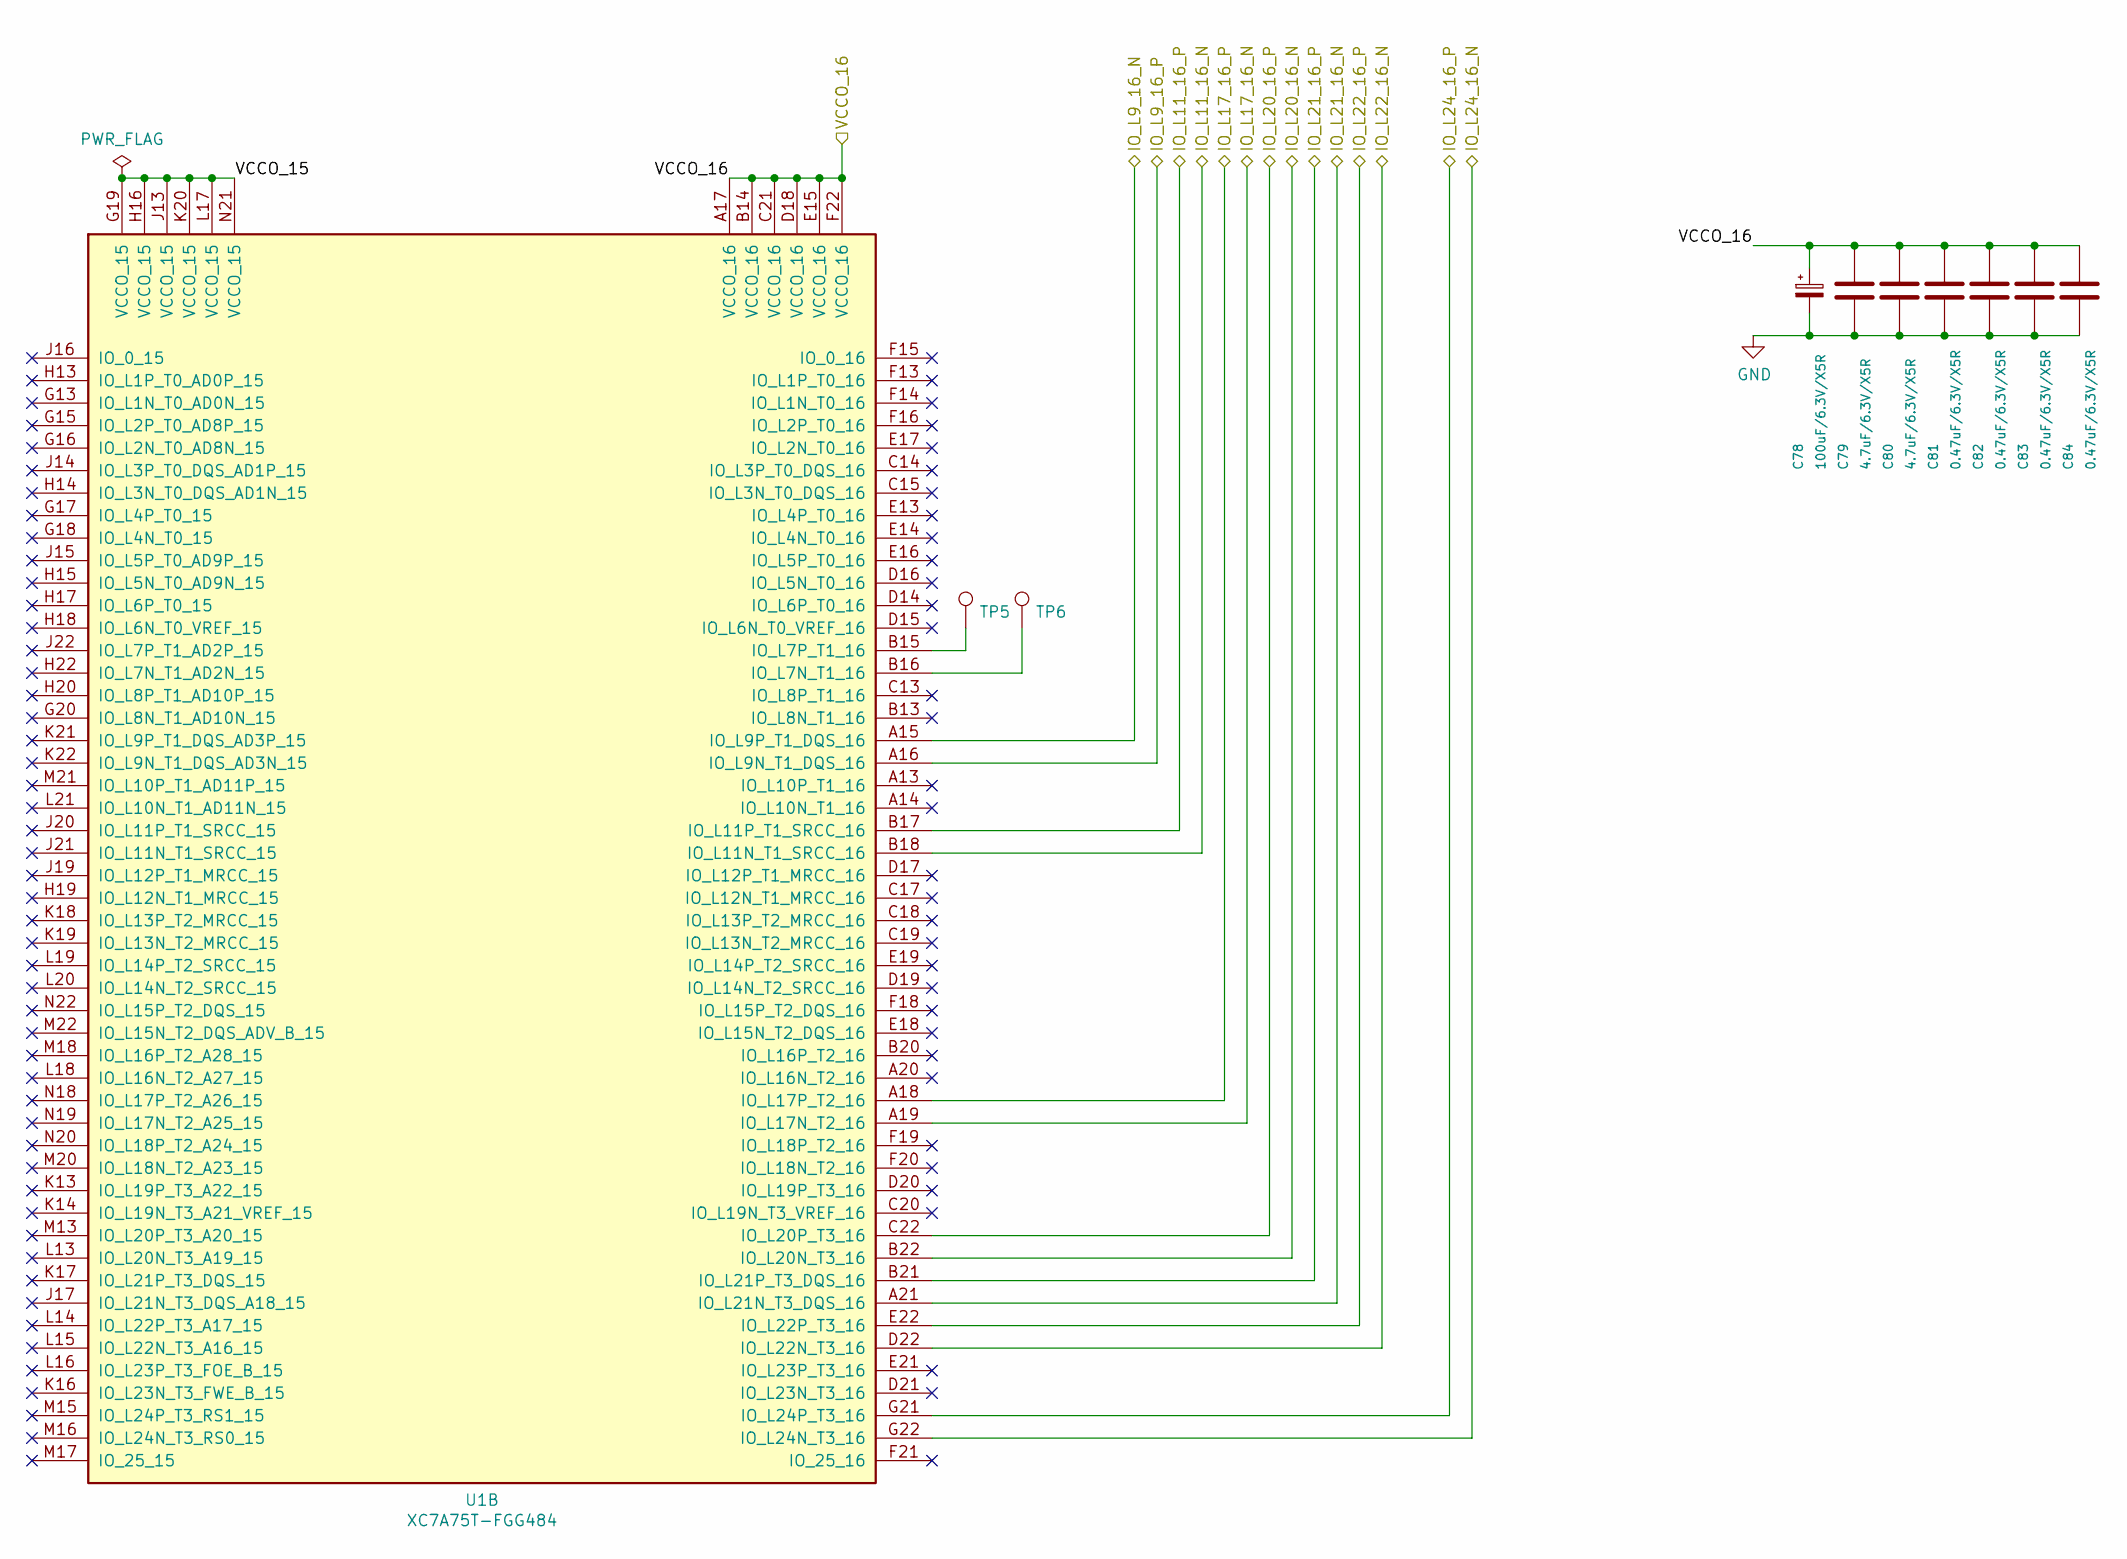
[picture p17: schematic artix7-pcie-v2-bank15.sch]

Parts:
C78: 100uF/6.3V/X5R; CP_EIA-3528-15_AVX-H; LCSC C16133
C79, C80: 4.7uF/6.3V/X5R; C_0402_1005Metric; LCSC C23733
C81, C82, C83, C84: 0.47uF/6.3V/X5R; C_0402_1005Metric; LCSC C47339
TP5, TP6: TestPoint; TestPoint_Pad_D1.5mm; LCSC DNP
U1: XC7A75T-FGG484; Xilinx_FGG484; LCSC DNP

Connections:
/VCCO_16: C78.1, C79.1, C80.1, C81.1, C82.1, C83.1, C84.1, U1.A17 (VCCO_16), U1.B14 (VCCO_16), U1.C21 (VCCO_16), U1.D18 (VCCO_16), U1.E15 (VCCO_16), U1.F22 (VCCO_16); also elsewhere on the board
/artix7-pcie-v2-bank14/IO_L9_16_N: U1.A15 (IO_L9P_T1_DQS_16); also elsewhere on the board
/artix7-pcie-v2-bank14/IO_L9_16_P: U1.A16 (IO_L9N_T1_DQS_16); also elsewhere on the board
/artix7-pcie-v2-bank14/IO_L11_16_N: U1.B18 (IO_L11N_T1_SRCC_16); also elsewhere on the board
/artix7-pcie-v2-bank14/IO_L11_16_P: U1.B17 (IO_L11P_T1_SRCC_16); also elsewhere on the board
/artix7-pcie-v2-bank14/IO_L17_16_N: U1.A19 (IO_L17N_T2_16); also elsewhere on the board
/artix7-pcie-v2-bank14/IO_L17_16_P: U1.A18 (IO_L17P_T2_16); also elsewhere on the board
/artix7-pcie-v2-bank14/IO_L20_16_N: U1.B22 (IO_L20N_T3_16); also elsewhere on the board
/artix7-pcie-v2-bank14/IO_L20_16_P: U1.C22 (IO_L20P_T3_16); also elsewhere on the board
/artix7-pcie-v2-bank14/IO_L21_16_N: U1.A21 (IO_L21N_T3_DQS_16); also elsewhere on the board
/artix7-pcie-v2-bank14/IO_L21_16_P: U1.B21 (IO_L21P_T3_DQS_16); also elsewhere on the board
/artix7-pcie-v2-bank14/IO_L22_16_N: U1.D22 (IO_L22N_T3_16); also elsewhere on the board
/artix7-pcie-v2-bank14/IO_L22_16_P: U1.E22 (IO_L22P_T3_16); also elsewhere on the board
/artix7-pcie-v2-bank14/IO_L24_16_N: U1.G22 (IO_L24N_T3_16); also elsewhere on the board
/artix7-pcie-v2-bank14/IO_L24_16_P: U1.G21 (IO_L24P_T3_16); also elsewhere on the board
/artix7-pcie-v2-bank15/VCCO_15: U1.G19 (VCCO_15), U1.H16 (VCCO_15), U1.J13 (VCCO_15), U1.K20 (VCCO_15), U1.L17 (VCCO_15), U1.N21 (VCCO_15)
GND: C78.2, C79.2, C80.2, C81.2, C82.2, C83.2, C84.2; also elsewhere on the board
unnamed: TP5.1, U1.B15 (IO_L7P_T1_16)
unnamed: TP6.1, U1.B16 (IO_L7N_T1_16)

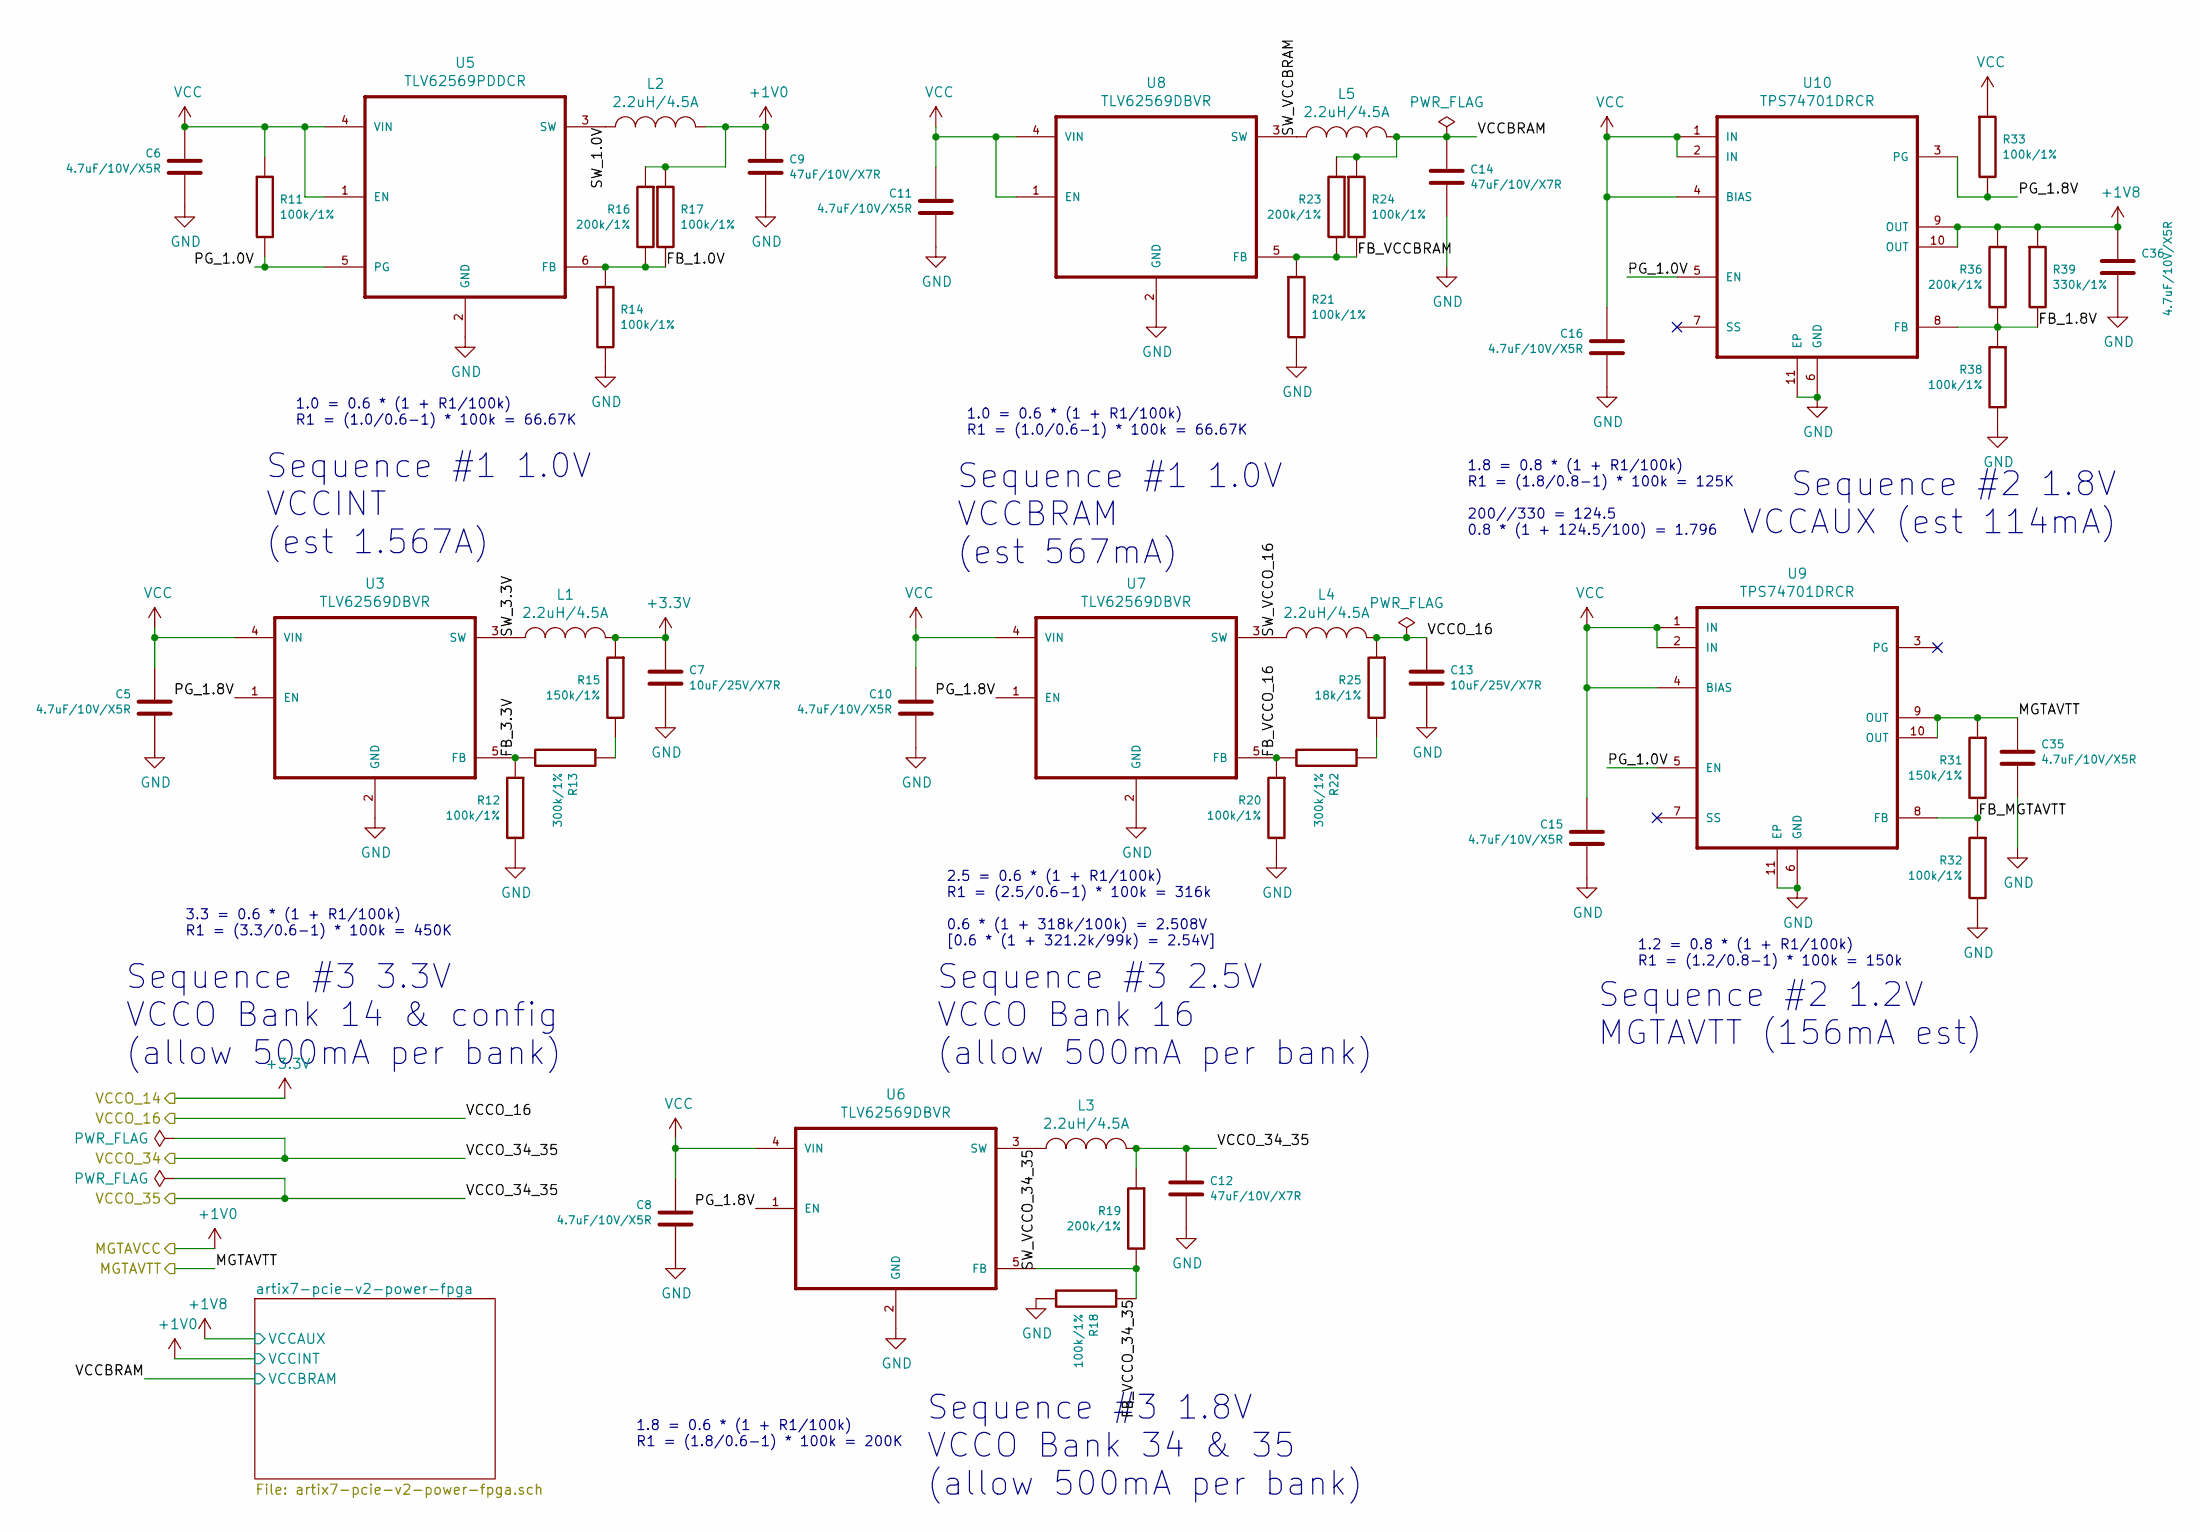
[picture p18: schematic artix7-pcie-v2-power.sch]

Parts:
C5, C6, C8, C10, C11, C15, C16, C35, C36: 4.7uF/10V/X5R; C_0402_1005Metric; LCSC C23733
C7, C13: 10uF/25V/X7R; C_1206_3216Metric; MFGPN C3216X7R1E106M160AE; LCSC C13585
C9, C12, C14: 47uF/10V/X7R; C_1206_3216Metric; LCSC C96123
L1, L2, L3, L4, L5: 2.2uH/4.5A; L_MWSA0518S; MPN MWSA0518S-2R2MT; LCSC C408345
R11, R12, R14, R17, R18, R20, R21, R24, R32, R33, R38: 100k/1%; R_0402_1005Metric; LCSC C25741
R13, R22: 300k/1%; R_0402_1005Metric; LCSC C25774
R15, R31: 150k/1%; R_0402_1005Metric; LCSC C25755
R16, R19, R23, R36: 200k/1%; R_0402_1005Metric; LCSC C25764
R25: 18k/1%; R_0402_1005Metric; LCSC C25762
R39: 330k/1%; R_0402_1005Metric; LCSC C25778
U3, U6, U7, U8: TLV62569DBVR; SOT95P280X145-5N; LCSC C141836
U5: TLV62569PDDCR; SOT95P280X110-6N; LCSC DNP
U9, U10: TPS74701DRCR; 16624-01YE; LCSC C105262

Connections:
+1V0: C9.2, L2.2, R16.1, R17.1; also elsewhere on the board
+1V8: C36.2, R36.1, R39.1, U10.9 (OUT), U10.10 (OUT); also elsewhere on the board
+3V3: C7.2, L1.2, R15.1; also elsewhere on the board
/MGTAVTT: C35.2, R31.1, U9.9 (OUT), U9.10 (OUT); also elsewhere on the board
/Power/FB_1.0V: R14.1, R16.2, R17.2, U5.6 (FB)
/Power/FB_1.8V: R36.2, R38.1, R39.2, U10.8 (FB)
/Power/FB_3.3V: R12.1, R13.2, U3.5 (FB)
/Power/FB_MGTAVTT: R31.2, R32.1, U9.8 (FB)
/Power/FB_VCCBRAM: R21.1, R23.2, R24.2, U8.5 (FB)
/Power/FB_VCCO_16: R20.1, R22.2, U7.5 (FB)
/Power/FB_VCCO_34_35: R18.1, R19.2, U6.5 (FB)
/Power/PG_1.0V: R11.2, U5.5 (PG), U9.5 (EN), U10.5 (EN)
/Power/PG_1.8V: R33.2, U3.1 (EN), U6.1 (EN), U7.1 (EN), U10.3 (PG)
/Power/SW_1.0V: L2.1, U5.3 (SW)
/Power/SW_3.3V: L1.1, U3.3 (SW)
/Power/SW_VCCBRAM: L5.1, U8.3 (SW)
/Power/SW_VCCO_16: L4.1, U7.3 (SW)
/Power/SW_VCCO_34_35: L3.1, U6.3 (SW)
/Power/VCCBRAM: C14.2, L5.2, R23.1, R24.1; also elsewhere on the board
/VCCO_16: C13.2, L4.2, R25.1; also elsewhere on the board
/VCCO_34: C12.2, L3.2, R19.1; also elsewhere on the board
GND: C5.1, C6.1, C7.1, C8.1, C9.1, C10.1, C11.1, C12.1, C13.1, C14.1, C15.1, C16.1, C35.1, C36.1, R12.2, R14.2, R18.2, R20.2, R21.2, R32.2, R38.2, U3.2 (GND), U5.2 (GND), U6.2 (GND), U7.2 (GND), U8.2 (GND), U9.6 (GND), U9.11 (EP), U10.6 (GND), U10.11 (EP); also elsewhere on the board
unnamed: R13.1, R15.2
unnamed: R22.1, R25.2
VCC: C5.2, C6.2, C8.2, C10.2, C11.2, C15.2, C16.2, R11.1, R33.1, U3.4 (VIN), U5.1 (EN), U5.4 (VIN), U6.4 (VIN), U7.4 (VIN), U8.1 (EN), U8.4 (VIN), U9.1 (IN), U9.2 (IN), U9.4 (BIAS), U10.1 (IN), U10.2 (IN), U10.4 (BIAS); also elsewhere on the board

Notes on the sheet:
1.0 = 0.6 * (1 + R1/100k) R1 = (1.0/0.6-1) * 100k = 66.67K
Sequence #1 1.0V VCCINT (est 1.567A)
Sequence #1 1.0V VCCBRAM (est 567mA)
Sequence #2 1.8V VCCAUX (est 114mA)
1.8 = 0.8 * (1 + R1/100k) R1 = (1.8/0.8-1) * 100k = 125K 200//330 = 124.5 0.8 * (1 + 124.5/100) = 1.796
1.2 = 0.8 * (1 + R1/100k) R1 = (1.2/0.8-1) * 100k = 150k
Sequence #2 1.2V MGTAVTT (156mA est)
Sequence #3 3.3V VCCO Bank 14 & config (allow 500mA per bank)
3.3 = 0.6 * (1 + R1/100k) R1 = (3.3/0.6-1) * 100k = 450K
2.5 = 0.6 * (1 + R1/100k) R1 = (2.5/0.6-1) * 100k = 316k 0.6 * (1 + 318k/100k) = 2.508V [0.6 * (1 + 321.2k/99k) = 2.54V]
Sequence #3 2.5V VCCO Bank 16 (allow 500mA per bank)
Sequence #3 1.8V VCCO Bank 34 & 35 (allow 500mA per bank)
1.8 = 0.6 * (1 + R1/100k) R1 = (1.8/0.6-1) * 100k = 200K
