TomKeddie/prj-artix7-pcie/hardware/v2/artix7-pcie-v2.kicad_pcb

## KiCad design hardware/v2/artix7-pcie-v2.kicad_pcb (continued)

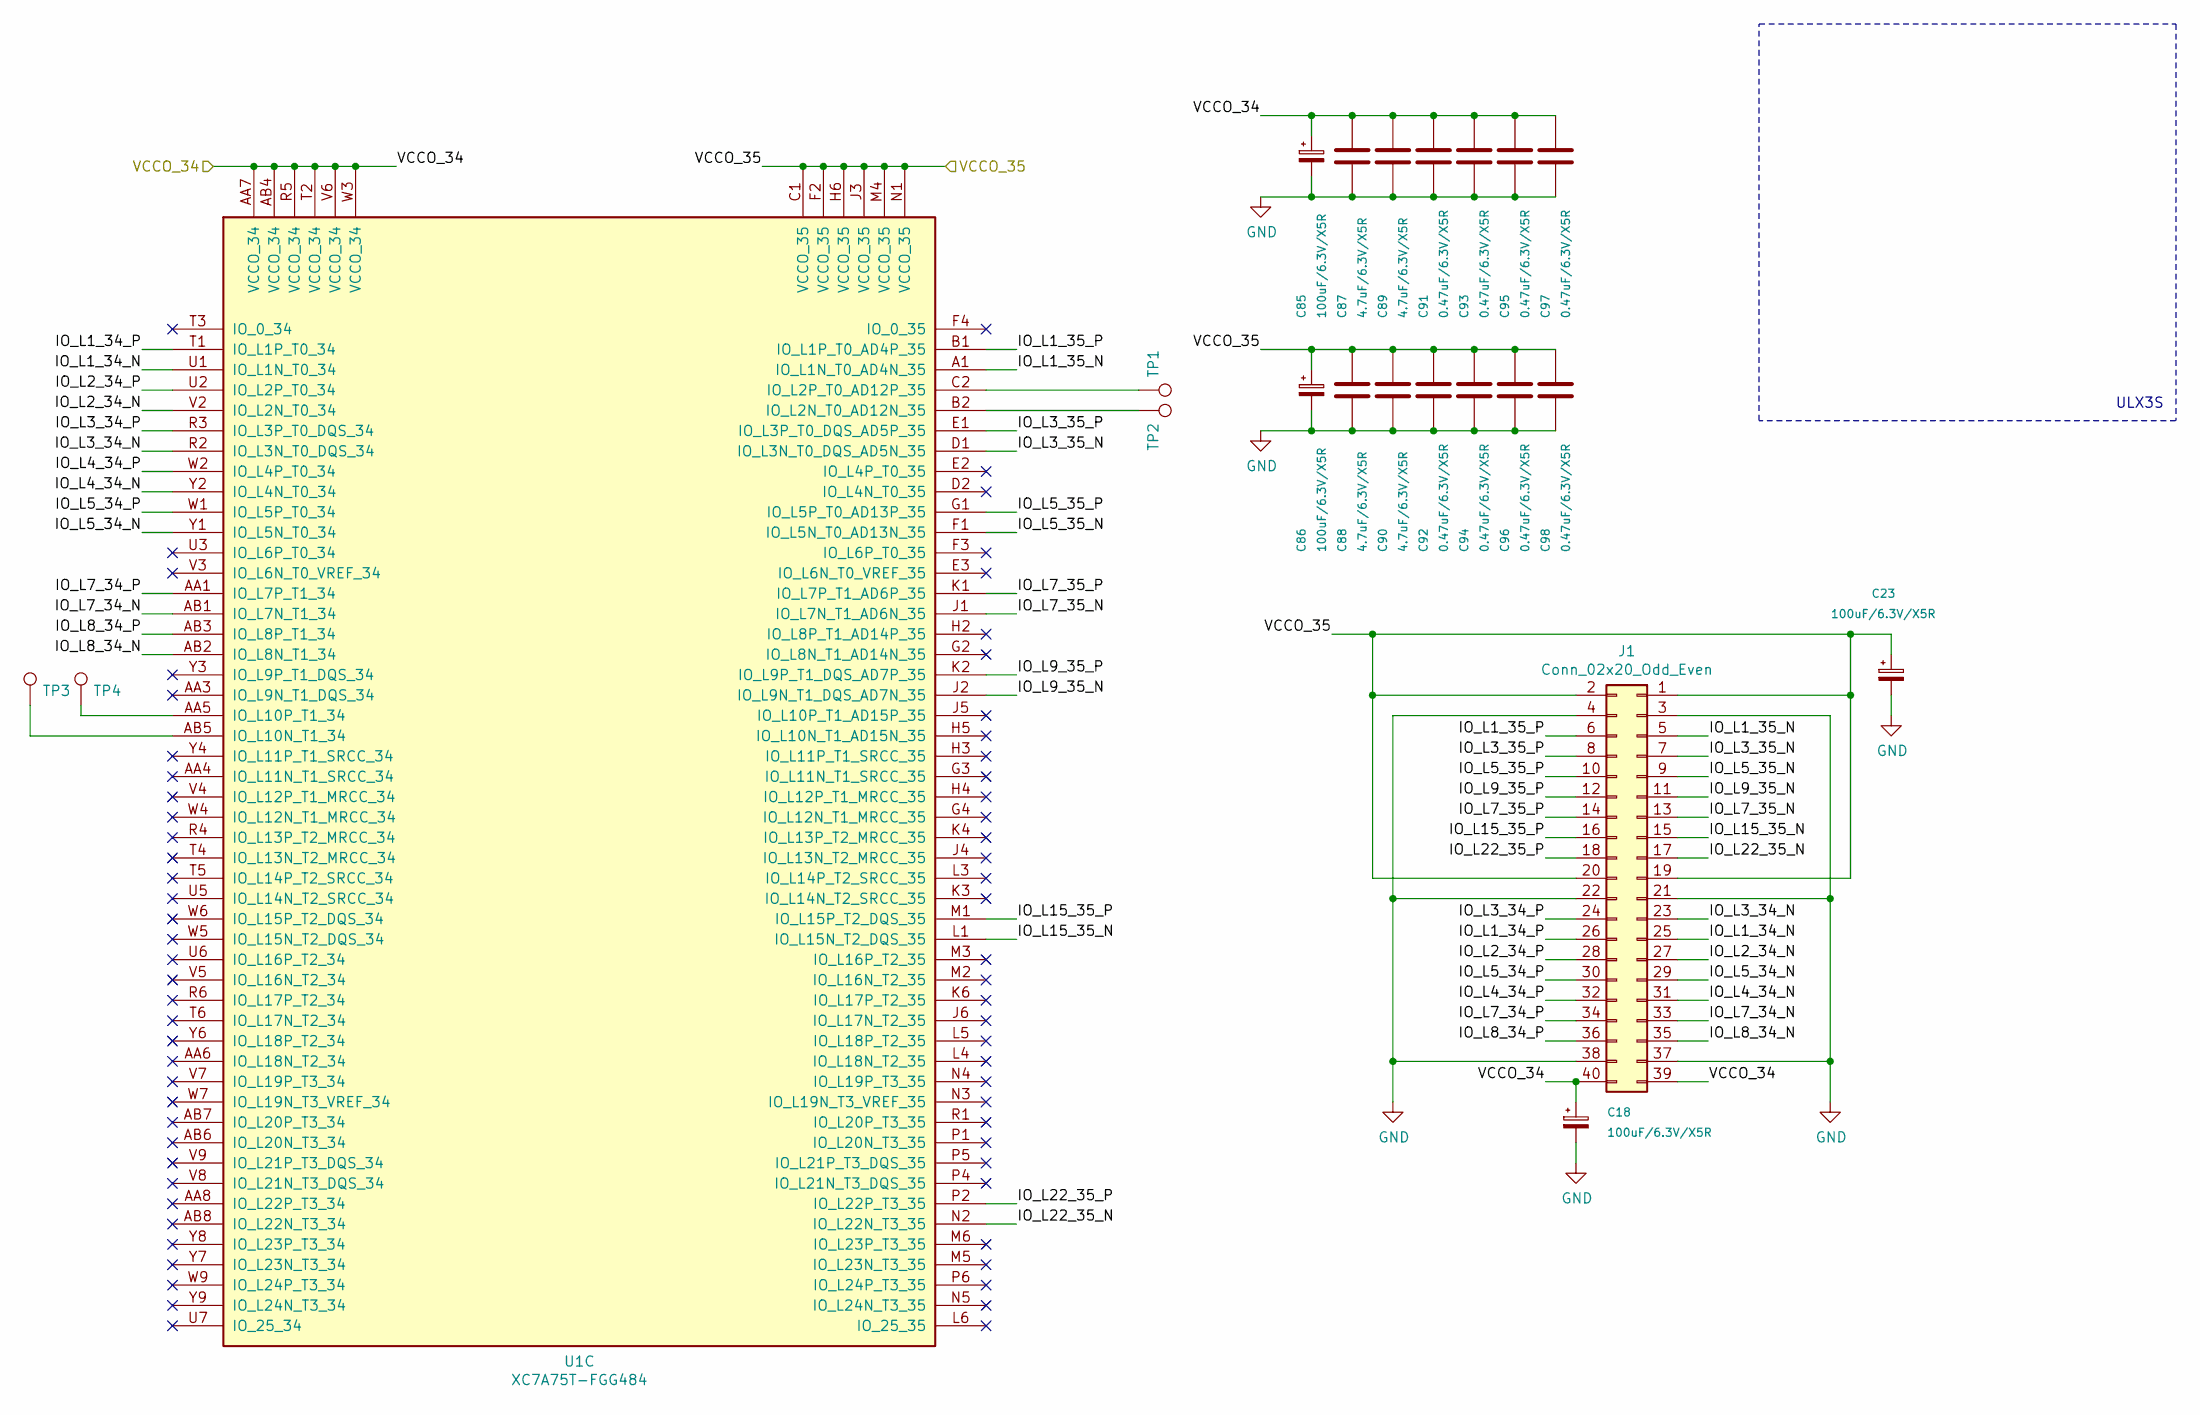
[picture p19: schematic artix7-pcie-v2-bank34.sch]

Parts:
C18, C23, C85, C86: 100uF/6.3V/X5R; CP_EIA-3528-15_AVX-H; LCSC C16133
C87, C88, C89, C90: 4.7uF/6.3V/X5R; C_0402_1005Metric; LCSC C23733
C91, C92, C93, C94, C95, C96, C97, C98: 0.47uF/6.3V/X5R; C_0402_1005Metric; LCSC C47339
J1: Conn_02x20_Odd_Even; Socket_Strip_Angled_2x20; LCSC DNP
TP1, TP2, TP3, TP4: TestPoint; TestPoint_Pad_D1.5mm; LCSC DNP
U1: XC7A75T-FGG484; Xilinx_FGG484; LCSC DNP

Connections:
/VCCO_34: C18.1, C23.1, C85.1, C86.1, C87.1, C88.1, C89.1, C90.1, C91.1, C92.1, C93.1, C94.1, C95.1, C96.1, C97.1, C98.1, J1.1, J1.2, J1.19, J1.20, J1.39, J1.40, U1.AA7 (VCCO_34), U1.AB4 (VCCO_34), U1.C1 (VCCO_35), U1.F2 (VCCO_35), U1.H6 (VCCO_35), U1.J3 (VCCO_35), U1.M4 (VCCO_35), U1.N1 (VCCO_35), U1.R5 (VCCO_34), U1.T2 (VCCO_34), U1.V6 (VCCO_34), U1.W3 (VCCO_34); also elsewhere on the board
/artix7-pcie-v2-bank34/IO_L1_34_N: J1.25, U1.U1 (IO_L1N_T0_34)
/artix7-pcie-v2-bank34/IO_L1_34_P: J1.26, U1.T1 (IO_L1P_T0_34)
/artix7-pcie-v2-bank34/IO_L1_35_N: J1.5, U1.A1 (IO_L1N_T0_AD4N_35)
/artix7-pcie-v2-bank34/IO_L1_35_P: J1.6, U1.B1 (IO_L1P_T0_AD4P_35)
/artix7-pcie-v2-bank34/IO_L2_34_N: J1.27, U1.V2 (IO_L2N_T0_34)
/artix7-pcie-v2-bank34/IO_L2_34_P: J1.28, U1.U2 (IO_L2P_T0_34)
/artix7-pcie-v2-bank34/IO_L3_34_N: J1.23, U1.R2 (IO_L3N_T0_DQS_34)
/artix7-pcie-v2-bank34/IO_L3_34_P: J1.24, U1.R3 (IO_L3P_T0_DQS_34)
/artix7-pcie-v2-bank34/IO_L3_35_N: J1.7, U1.D1 (IO_L3N_T0_DQS_AD5N_35)
/artix7-pcie-v2-bank34/IO_L3_35_P: J1.8, U1.E1 (IO_L3P_T0_DQS_AD5P_35)
/artix7-pcie-v2-bank34/IO_L4_34_N: J1.31, U1.Y2 (IO_L4N_T0_34)
/artix7-pcie-v2-bank34/IO_L4_34_P: J1.32, U1.W2 (IO_L4P_T0_34)
/artix7-pcie-v2-bank34/IO_L5_34_N: J1.29, U1.Y1 (IO_L5N_T0_34)
/artix7-pcie-v2-bank34/IO_L5_34_P: J1.30, U1.W1 (IO_L5P_T0_34)
/artix7-pcie-v2-bank34/IO_L5_35_N: J1.9, U1.F1 (IO_L5N_T0_AD13N_35)
/artix7-pcie-v2-bank34/IO_L5_35_P: J1.10, U1.G1 (IO_L5P_T0_AD13P_35)
/artix7-pcie-v2-bank34/IO_L7_34_N: J1.33, U1.AB1 (IO_L7N_T1_34)
/artix7-pcie-v2-bank34/IO_L7_34_P: J1.34, U1.AA1 (IO_L7P_T1_34)
/artix7-pcie-v2-bank34/IO_L7_35_N: J1.13, U1.J1 (IO_L7N_T1_AD6N_35)
/artix7-pcie-v2-bank34/IO_L7_35_P: J1.14, U1.K1 (IO_L7P_T1_AD6P_35)
/artix7-pcie-v2-bank34/IO_L8_34_N: J1.35, U1.AB2 (IO_L8N_T1_34)
/artix7-pcie-v2-bank34/IO_L8_34_P: J1.36, U1.AB3 (IO_L8P_T1_34)
/artix7-pcie-v2-bank34/IO_L9_35_N: J1.11, U1.J2 (IO_L9N_T1_DQS_AD7N_35)
/artix7-pcie-v2-bank34/IO_L9_35_P: J1.12, U1.K2 (IO_L9P_T1_DQS_AD7P_35)
/artix7-pcie-v2-bank34/IO_L15_35_N: J1.15, U1.L1 (IO_L15N_T2_DQS_35)
/artix7-pcie-v2-bank34/IO_L15_35_P: J1.16, U1.M1 (IO_L15P_T2_DQS_35)
/artix7-pcie-v2-bank34/IO_L22_35_N: J1.17, U1.N2 (IO_L22N_T3_35)
/artix7-pcie-v2-bank34/IO_L22_35_P: J1.18, U1.P2 (IO_L22P_T3_35)
GND: C18.2, C23.2, C85.2, C86.2, C87.2, C88.2, C89.2, C90.2, C91.2, C92.2, C93.2, C94.2, C95.2, C96.2, C97.2, C98.2, J1.3, J1.4, J1.21, J1.22, J1.37, J1.38; also elsewhere on the board
unnamed: TP1.1, U1.C2 (IO_L2P_T0_AD12P_35)
unnamed: TP2.1, U1.B2 (IO_L2N_T0_AD12N_35)
unnamed: TP3.1, U1.AB5 (IO_L10N_T1_34)
unnamed: TP4.1, U1.AA5 (IO_L10P_T1_34)

Notes on the sheet:
ULX3S

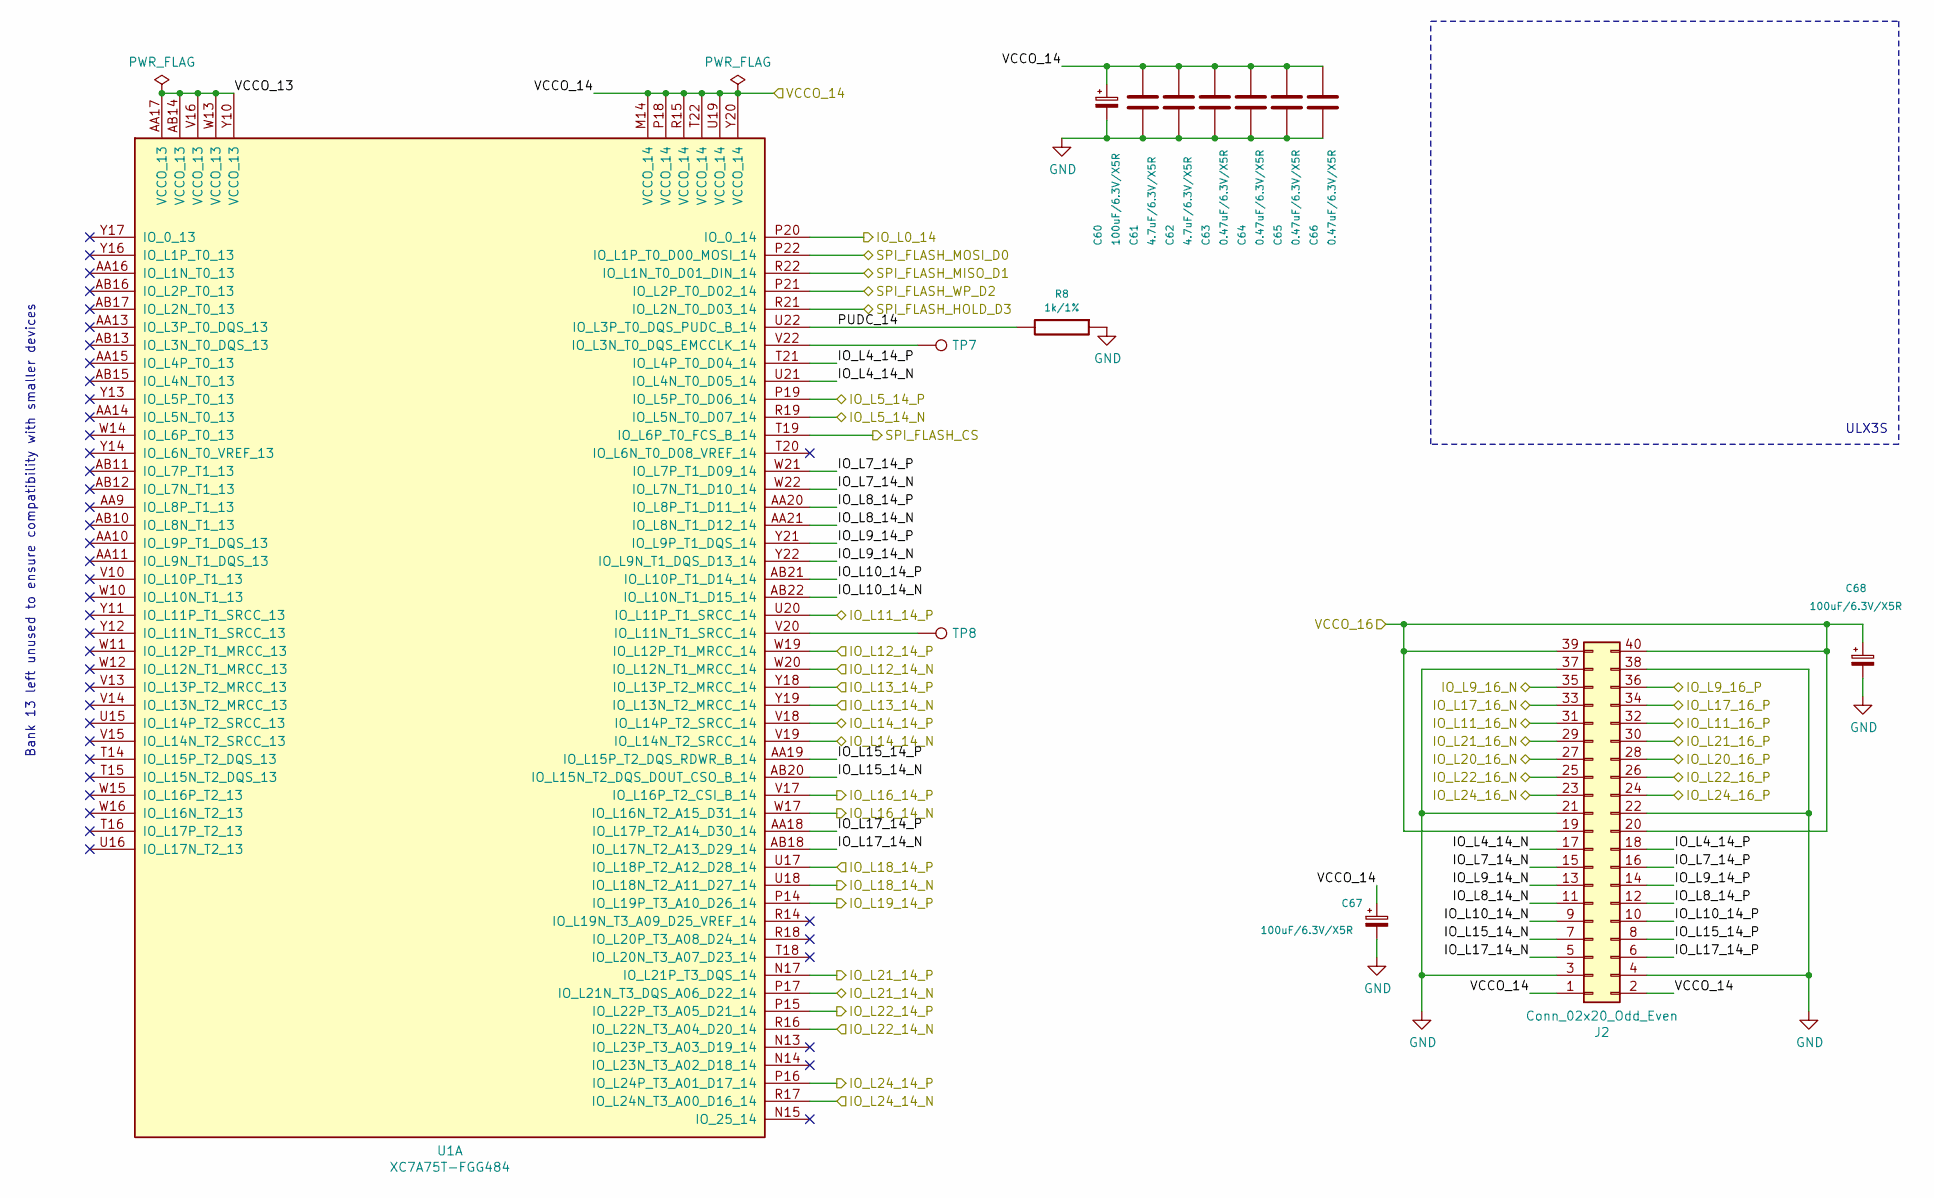
[picture p20: schematic artix7-pcie-v2-bank14.sch]

Parts:
C60, C67, C68: 100uF/6.3V/X5R; CP_EIA-3528-15_AVX-H; LCSC C16133
C61, C62: 4.7uF/6.3V/X5R; C_0402_1005Metric; LCSC C23733
C63, C64, C65, C66: 0.47uF/6.3V/X5R; C_0402_1005Metric; LCSC C47339
J2: Conn_02x20_Odd_Even; Socket_Strip_Angled_2x20; LCSC DNP
R8: 1k/1%; R_0402_1005Metric; LCSC C11702
TP7, TP8: TestPoint; TestPoint_Pad_D1.5mm; LCSC DNP
U1: XC7A75T-FGG484; Xilinx_FGG484; LCSC DNP

Connections:
+3V3: C60.1, C61.1, C62.1, C63.1, C64.1, C65.1, C66.1, C67.1, J2.1, J2.2, U1.M14 (VCCO_14), U1.P18 (VCCO_14), U1.R15 (VCCO_14), U1.T22 (VCCO_14), U1.U19 (VCCO_14), U1.Y20 (VCCO_14); also elsewhere on the board
/CFG_FLASH_CS: U1.T19 (IO_L6P_T0_FCS_B_14); also elsewhere on the board
/CFG_FLASH_HOLD_D3: U1.R21 (IO_L2N_T0_D03_14); also elsewhere on the board
/CFG_FLASH_MISO_D1: U1.R22 (IO_L1N_T0_D01_DIN_14); also elsewhere on the board
/CFG_FLASH_MOSI_D0: U1.P22 (IO_L1P_T0_D00_MOSI_14); also elsewhere on the board
/CFG_FLASH_WP_D2: U1.P21 (IO_L2P_T0_D02_14); also elsewhere on the board
/CLKIN_N: U1.Y19 (IO_L13N_T2_MRCC_14); also elsewhere on the board
/CLKIN_P: U1.Y18 (IO_L13P_T2_MRCC_14); also elsewhere on the board
/CLK_SCL: U1.N17 (IO_L21P_T3_DQS_14); also elsewhere on the board
/CLK_SDA: U1.P17 (IO_L21N_T3_DQS_A06_D22_14); also elsewhere on the board
/PCIE_PERST: U1.R17 (IO_L24N_T3_A00_D16_14); also elsewhere on the board
/PCIE_WAKE: U1.R16 (IO_L22N_T3_A04_D20_14); also elsewhere on the board
/S0_USB2_N: U1.R19 (IO_L5N_T0_D07_14); also elsewhere on the board
/S0_USB2_P: U1.P19 (IO_L5P_T0_D06_14); also elsewhere on the board
/S0_USB2_PULLUP: U1.P20 (IO_0_14); also elsewhere on the board
/VCCO_16: C68.1, J2.19, J2.20, J2.39, J2.40; also elsewhere on the board
/artix7-pcie-v2-bank14/IO_L4_14_N: J2.17, U1.U21 (IO_L4N_T0_D05_14)
/artix7-pcie-v2-bank14/IO_L4_14_P: J2.18, U1.T21 (IO_L4P_T0_D04_14)
/artix7-pcie-v2-bank14/IO_L7_14_N: J2.15, U1.W22 (IO_L7N_T1_D10_14)
/artix7-pcie-v2-bank14/IO_L7_14_P: J2.16, U1.W21 (IO_L7P_T1_D09_14)
/artix7-pcie-v2-bank14/IO_L8_14_N: J2.11, U1.AA21 (IO_L8N_T1_D12_14)
/artix7-pcie-v2-bank14/IO_L8_14_P: J2.12, U1.AA20 (IO_L8P_T1_D11_14)
/artix7-pcie-v2-bank14/IO_L9_14_N: J2.13, U1.Y22 (IO_L9N_T1_DQS_D13_14)
/artix7-pcie-v2-bank14/IO_L9_14_P: J2.14, U1.Y21 (IO_L9P_T1_DQS_14)
/artix7-pcie-v2-bank14/IO_L9_16_N: J2.35; also elsewhere on the board
/artix7-pcie-v2-bank14/IO_L9_16_P: J2.36; also elsewhere on the board
/artix7-pcie-v2-bank14/IO_L10_14_N: J2.9, U1.AB22 (IO_L10N_T1_D15_14)
/artix7-pcie-v2-bank14/IO_L10_14_P: J2.10, U1.AB21 (IO_L10P_T1_D14_14)
/artix7-pcie-v2-bank14/IO_L11_14_P: U1.U20 (IO_L11P_T1_SRCC_14); also elsewhere on the board
/artix7-pcie-v2-bank14/IO_L11_16_N: J2.31; also elsewhere on the board
/artix7-pcie-v2-bank14/IO_L11_16_P: J2.32; also elsewhere on the board
/artix7-pcie-v2-bank14/IO_L12_14_N: U1.W20 (IO_L12N_T1_MRCC_14); also elsewhere on the board
/artix7-pcie-v2-bank14/IO_L12_14_P: U1.W19 (IO_L12P_T1_MRCC_14); also elsewhere on the board
/artix7-pcie-v2-bank14/IO_L14_14_N: U1.V19 (IO_L14N_T2_SRCC_14); also elsewhere on the board
/artix7-pcie-v2-bank14/IO_L14_14_P: U1.V18 (IO_L14P_T2_SRCC_14); also elsewhere on the board
/artix7-pcie-v2-bank14/IO_L15_14_N: J2.7, U1.AB20 (IO_L15N_T2_DQS_DOUT_CSO_B_14)
/artix7-pcie-v2-bank14/IO_L15_14_P: J2.8, U1.AA19 (IO_L15P_T2_DQS_RDWR_B_14)
/artix7-pcie-v2-bank14/IO_L16_14_N: U1.W17 (IO_L16N_T2_A15_D31_14); also elsewhere on the board
/artix7-pcie-v2-bank14/IO_L16_14_P: U1.V17 (IO_L16P_T2_CSI_B_14); also elsewhere on the board
/artix7-pcie-v2-bank14/IO_L17_14_N: J2.5, U1.AB18 (IO_L17N_T2_A13_D29_14)
/artix7-pcie-v2-bank14/IO_L17_14_P: J2.6, U1.AA18 (IO_L17P_T2_A14_D30_14)
/artix7-pcie-v2-bank14/IO_L17_16_N: J2.33; also elsewhere on the board
/artix7-pcie-v2-bank14/IO_L17_16_P: J2.34; also elsewhere on the board
/artix7-pcie-v2-bank14/IO_L18_14_N: U1.U18 (IO_L18N_T2_A11_D27_14); also elsewhere on the board
/artix7-pcie-v2-bank14/IO_L18_14_P: U1.U17 (IO_L18P_T2_A12_D28_14); also elsewhere on the board
/artix7-pcie-v2-bank14/IO_L19_14_P: U1.P14 (IO_L19P_T3_A10_D26_14); also elsewhere on the board
/artix7-pcie-v2-bank14/IO_L20_16_N: J2.27; also elsewhere on the board
/artix7-pcie-v2-bank14/IO_L20_16_P: J2.28; also elsewhere on the board
/artix7-pcie-v2-bank14/IO_L21_16_N: J2.29; also elsewhere on the board
/artix7-pcie-v2-bank14/IO_L21_16_P: J2.30; also elsewhere on the board
/artix7-pcie-v2-bank14/IO_L22_14_P: U1.P15 (IO_L22P_T3_A05_D21_14); also elsewhere on the board
/artix7-pcie-v2-bank14/IO_L22_16_N: J2.25; also elsewhere on the board
/artix7-pcie-v2-bank14/IO_L22_16_P: J2.26; also elsewhere on the board
/artix7-pcie-v2-bank14/IO_L24_14_P: U1.P16 (IO_L24P_T3_A01_D17_14); also elsewhere on the board
/artix7-pcie-v2-bank14/IO_L24_16_N: J2.23; also elsewhere on the board
/artix7-pcie-v2-bank14/IO_L24_16_P: J2.24; also elsewhere on the board
/artix7-pcie-v2-bank14/PUDC_14: R8.2, U1.U22 (IO_L3P_T0_DQS_PUDC_B_14)
/artix7-pcie-v2-bank14/VCCO_13: U1.AA17 (VCCO_13), U1.AB14 (VCCO_13), U1.V16 (VCCO_13), U1.W13 (VCCO_13), U1.Y10 (VCCO_13)
GND: C60.2, C61.2, C62.2, C63.2, C64.2, C65.2, C66.2, C67.2, C68.2, J2.3, J2.4, J2.21, J2.22, J2.37, J2.38, R8.1; also elsewhere on the board
unnamed: TP7.1, U1.V22 (IO_L3N_T0_DQS_EMCCLK_14)
unnamed: TP8.1, U1.V20 (IO_L11N_T1_SRCC_14)

Notes on the sheet:
Bank 13 left unused to ensure compatibility with smaller devices
ULX3S

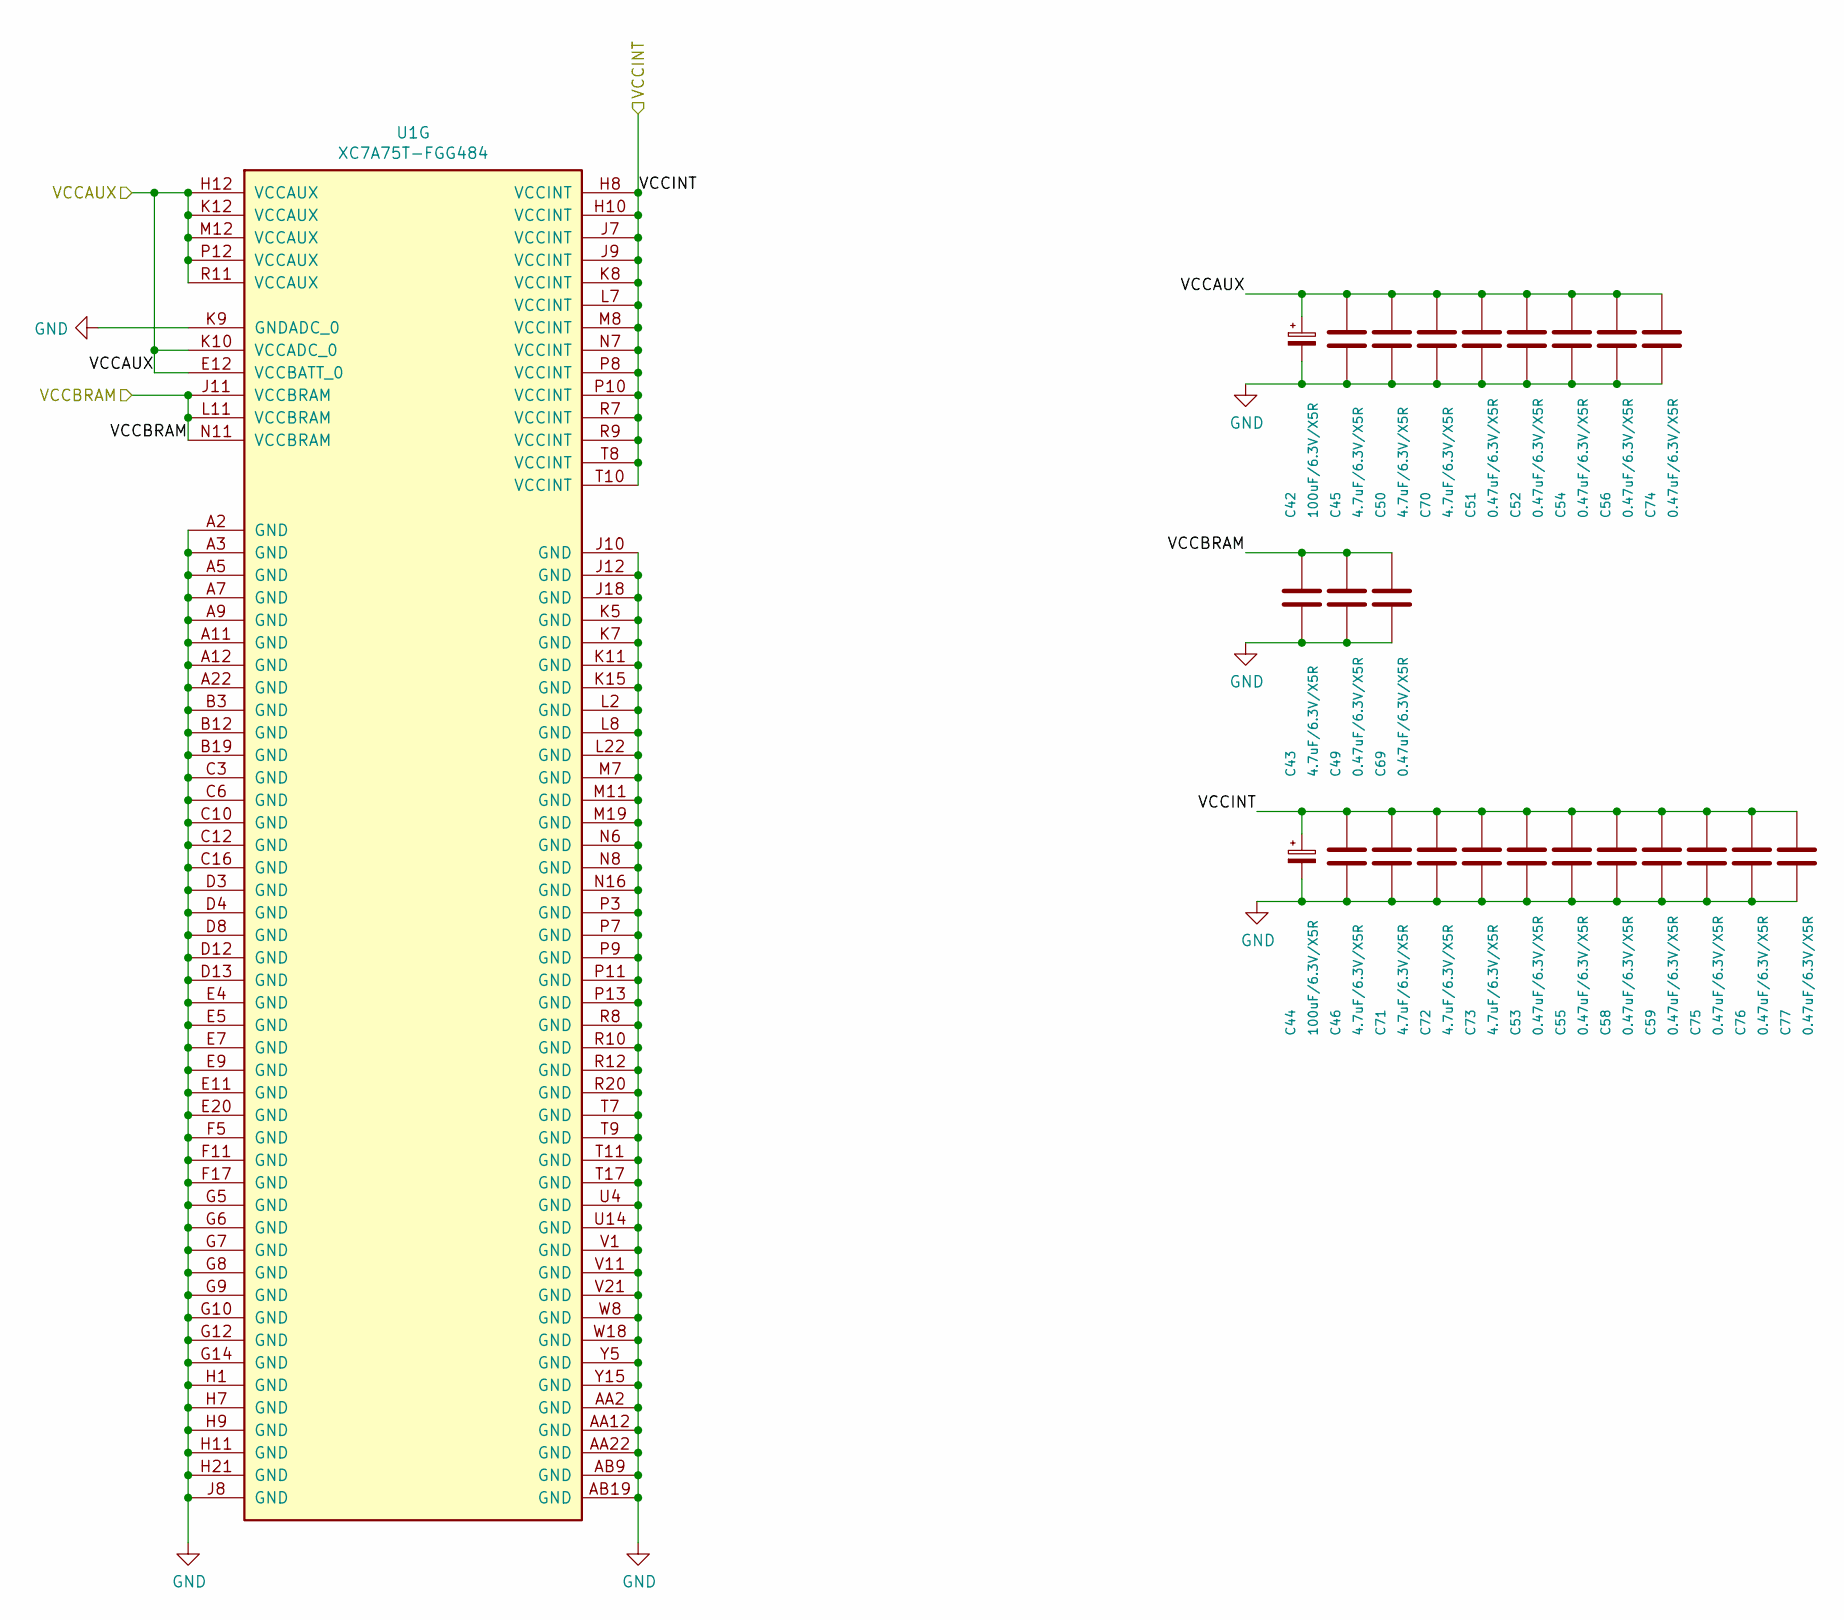
[picture p21: schematic artix7-pcie-v2-power-fpga.sch]

Parts:
C42, C44: 100uF/6.3V/X5R; CP_EIA-3528-15_AVX-H; LCSC C16133
C43, C45, C46, C50, C70, C71, C72, C73: 4.7uF/6.3V/X5R; C_0402_1005Metric; LCSC C23733
C49, C51, C52, C53, C54, C55, C56, C58, C59, C69, C74, C75, C76, C77: 0.47uF/6.3V/X5R; C_0402_1005Metric; LCSC C47339
U1: XC7A75T-FGG484; Xilinx_FGG484; LCSC DNP

Connections:
+1V0: C44.1, C46.1, C53.1, C55.1, C58.1, C59.1, C71.1, C72.1, C73.1, C75.1, C76.1, C77.1, U1.H8 (VCCINT), U1.H10 (VCCINT), U1.J7 (VCCINT), U1.J9 (VCCINT), U1.K8 (VCCINT), U1.L7 (VCCINT), U1.M8 (VCCINT), U1.N7 (VCCINT), U1.P8 (VCCINT), U1.P10 (VCCINT), U1.R7 (VCCINT), U1.R9 (VCCINT), U1.T8 (VCCINT), U1.T10 (VCCINT); also elsewhere on the board
+1V8: C42.1, C45.1, C50.1, C51.1, C52.1, C54.1, C56.1, C70.1, C74.1, U1.E12 (VCCBATT_0), U1.H12 (VCCAUX), U1.K10 (VCCADC_0), U1.K12 (VCCAUX), U1.M12 (VCCAUX), U1.P12 (VCCAUX), U1.R11 (VCCAUX); also elsewhere on the board
/Power/VCCBRAM: C43.1, C49.1, C69.1, U1.J11 (VCCBRAM), U1.L11 (VCCBRAM), U1.N11 (VCCBRAM); also elsewhere on the board
GND: C42.2, C43.2, C44.2, C45.2, C46.2, C49.2, C50.2, C51.2, C52.2, C53.2, C54.2, C55.2, C56.2, C58.2, C59.2, C69.2, C70.2, C71.2, C72.2, C73.2, C74.2, C75.2, C76.2, C77.2, U1.A2 (GND), U1.A3 (GND), U1.A5 (GND), U1.A7 (GND), U1.A9 (GND), U1.A11 (GND), U1.A12 (GND), U1.A22 (GND), U1.AA2 (GND), U1.AA12 (GND), U1.AA22 (GND), U1.AB9 (GND), U1.AB19 (GND), U1.B3 (GND), U1.B12 (GND), U1.B19 (GND), U1.C3 (GND), U1.C6 (GND), U1.C10 (GND), U1.C12 (GND), U1.C16 (GND), U1.D3 (GND), U1.D4 (GND), U1.D8 (GND), U1.D12 (GND), U1.D13 (GND), U1.E4 (GND), U1.E5 (GND), U1.E7 (GND), U1.E9 (GND), U1.E11 (GND), U1.E20 (GND), U1.F5 (GND), U1.F11 (GND), U1.F17 (GND), U1.G5 (GND), U1.G6 (GND), U1.G7 (GND), U1.G8 (GND), U1.G9 (GND), U1.G10 (GND), U1.G12 (GND), U1.G14 (GND), U1.H1 (GND), U1.H7 (GND), U1.H9 (GND), U1.H11 (GND), U1.H21 (GND), U1.J8 (GND), U1.J10 (GND), U1.J12 (GND), U1.J18 (GND), U1.K5 (GND), U1.K7 (GND), U1.K9 (GNDADC_0), U1.K11 (GND), U1.K15 (GND), U1.L2 (GND), U1.L8 (GND), U1.L22 (GND), U1.M7 (GND), U1.M11 (GND), U1.M19 (GND), U1.N6 (GND), U1.N8 (GND), U1.N16 (GND), U1.P3 (GND), U1.P7 (GND), U1.P9 (GND), U1.P11 (GND), U1.P13 (GND), U1.R8 (GND), U1.R10 (GND), U1.R12 (GND), U1.R20 (GND), U1.T7 (GND), U1.T9 (GND), U1.T11 (GND), U1.T17 (GND), U1.U4 (GND), U1.U14 (GND), U1.V1 (GND), U1.V11 (GND), U1.V21 (GND), U1.W8 (GND), U1.W18 (GND), U1.Y5 (GND), U1.Y15 (GND); also elsewhere on the board

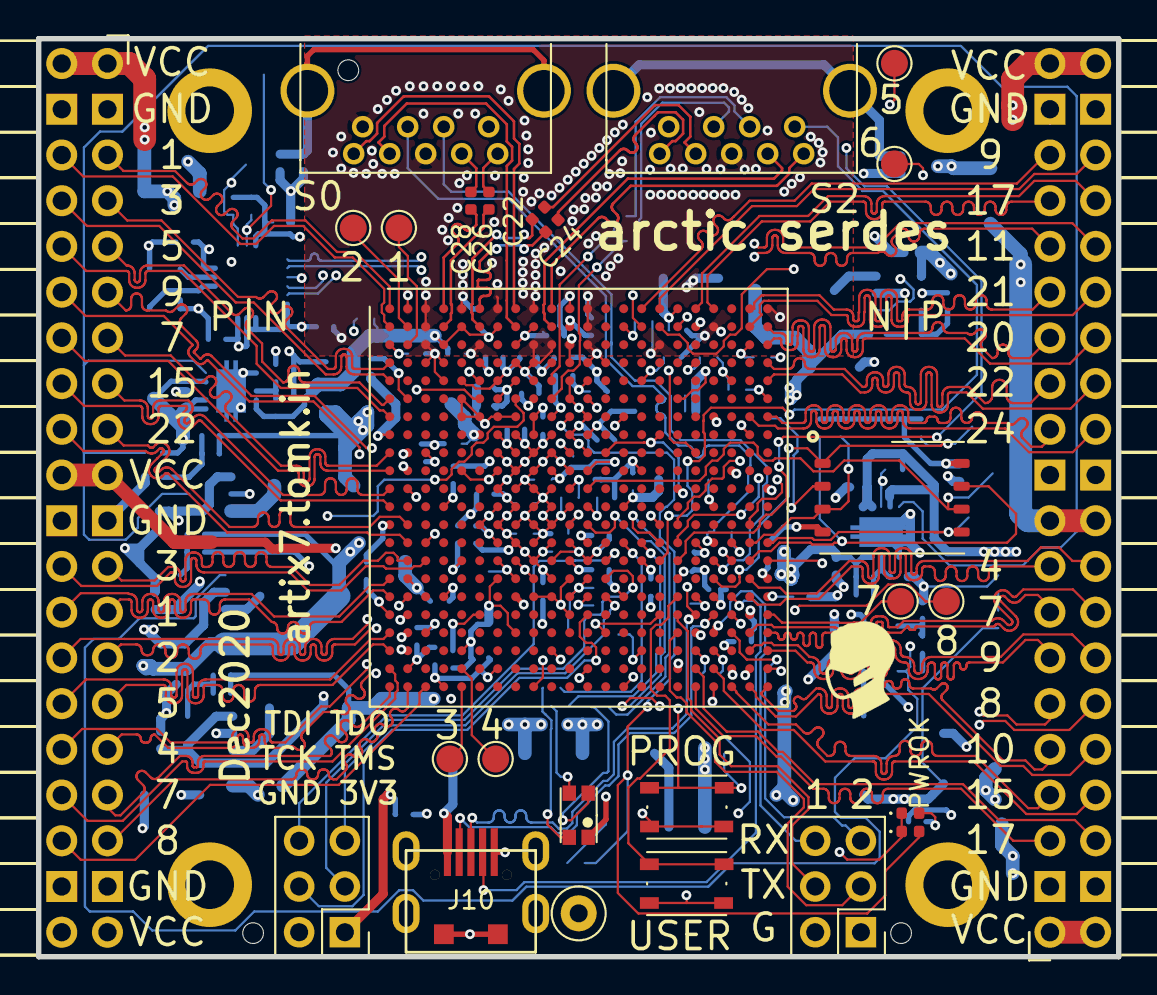
[picture p22: board artix7-pcie-v2.kicad_pcb from above]

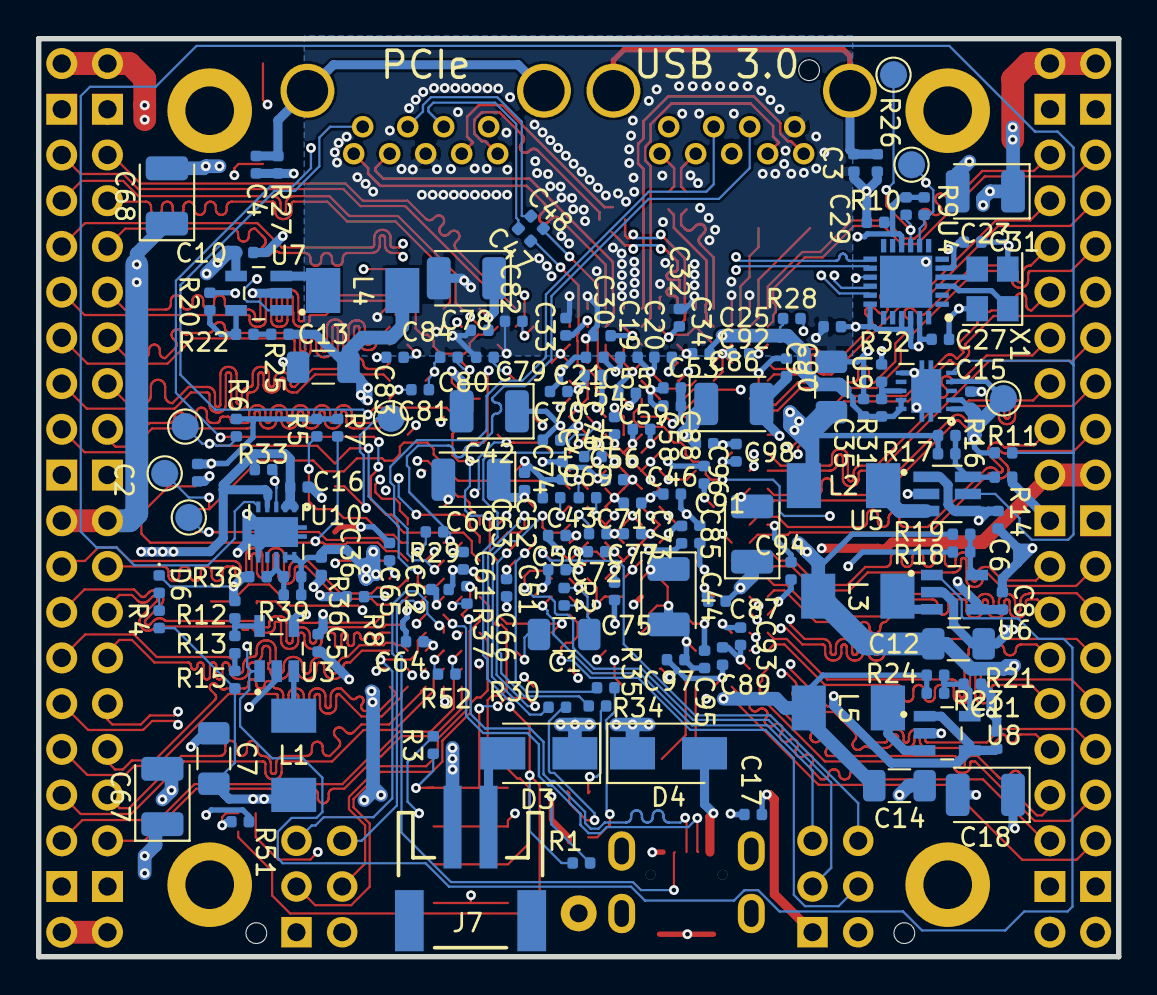
[picture p23: board artix7-pcie-v2.kicad_pcb from below]

Board: 4 copper layers, 60.0 x 51.0 mm, 189 parts (154 on the bottom side), 156 nets.
