TomKeddie/prj-artix7-pcie/hardware/practice/practice.kicad_pcb

## KiCad design hardware/practice/practice.kicad_pcb (2020-04-12)

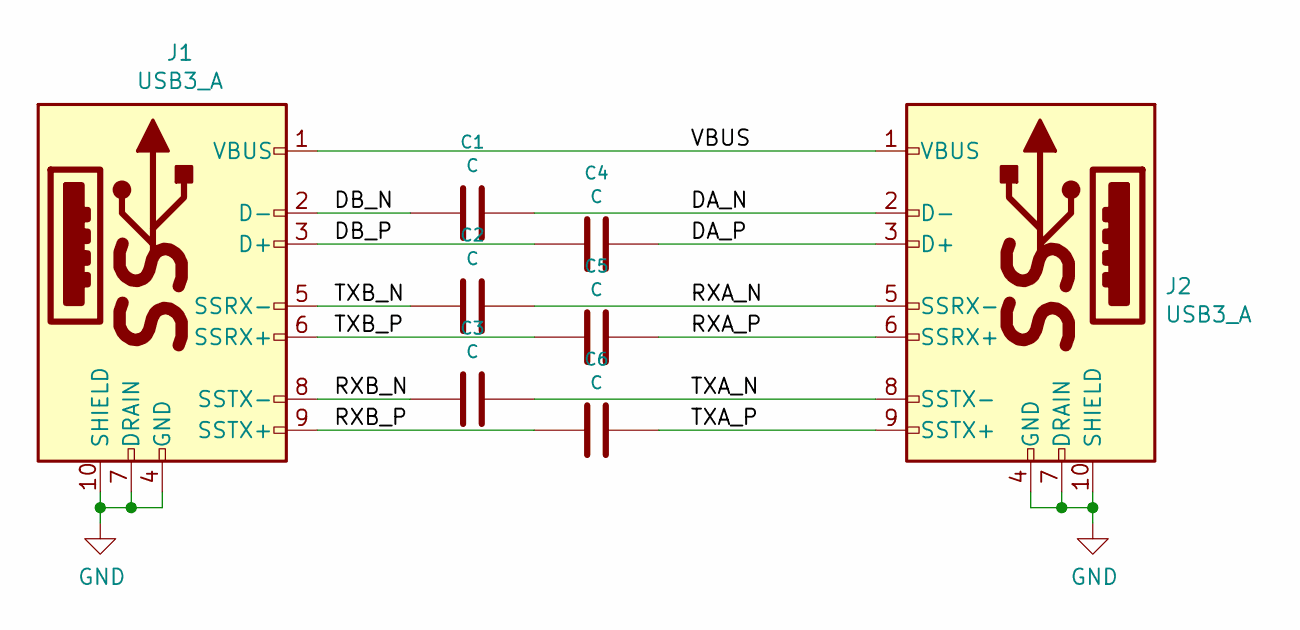
[picture p24: schematic practice.sch]

Parts:
C1, C2, C3, C4, C5, C6: C; C_0402_1005Metric
J1, J2: USB3_A; USB3_A_Aliexpress

Connections:
/DA_N: C1.1, J2.2 (D-)
/DA_P: C4.1, J2.3 (D+)
/DB_N: C1.2, J1.2 (D-)
/DB_P: C4.2, J1.3 (D+)
/RXA_N: C2.1, J2.5 (SSRX-)
/RXA_P: C5.1, J2.6 (SSRX+)
/RXB_N: C3.2, J1.8 (SSTX-)
/RXB_P: C6.2, J1.9 (SSTX+)
/TXA_N: C3.1, J2.8 (SSTX-)
/TXA_P: C6.1, J2.9 (SSTX+)
/TXB_N: C2.2, J1.5 (SSRX-)
/TXB_P: C5.2, J1.6 (SSRX+)
/VBUS: J1.1 (VBUS), J2.1 (VBUS)
GND: J1.4 (GND), J1.7 (DRAIN), J1.10 (SHIELD), J2.4 (GND), J2.7 (DRAIN), J2.10 (SHIELD)

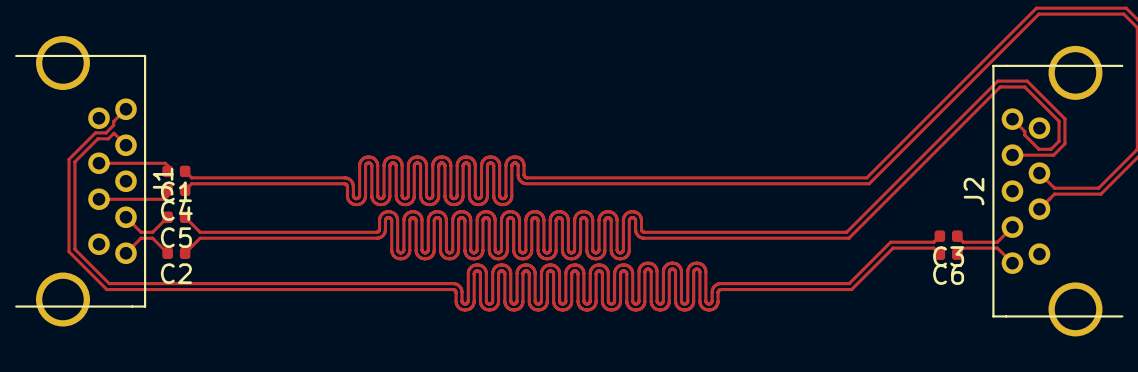
[picture p25: board practice.kicad_pcb from above]

Board: 4 copper layers, 8 parts (0 on the bottom side), 14 nets.
