TomKeddie/prj-artix7-pcie/fpga/v2/plan/xilinx_ip/pcie_7x_0_ex/pcie_7x_0_ex.srcs/sources_1/ip/pcie_7x_0/source/pcie_7x_0_pipe_wrapper.v

//-----------------------------------------------------------------------------
//
// (c) Copyright 2010-2011 Xilinx, Inc. All rights reserved.
//
// This file contains confidential and proprietary information
// of Xilinx, Inc. and is protected under U.S. and
// international copyright and other intellectual property
// laws.
//
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
// CRITICAL APPLICATIONS
// Xilinx products are not designed or intended to be fail-
// safe, or for use in any application requiring fail-safe
// performance, such as life-support or safety devices or
// systems, Class III medical devices, nuclear facilities,
// applications related to the deployment of airbags, or any
// other applications that could lead to death, personal
// injury, or severe property or environmental damage
// (individually and collectively, "Critical
// Applications"). Customer assumes the sole risk and
// liability of any use of Xilinx products in Critical
// Applications, subject only to applicable laws and
// regulations governing limitations on product liability.
//
// THIS COPYRIGHT NOTICE AND DISCLAIMER MUST BE RETAINED AS
// PART OF THIS FILE AT ALL TIMES.
//
//-----------------------------------------------------------------------------
// Project    : Series-7 Integrated Block for PCI Express
// File       : pcie_7x_0_pipe_wrapper.v
// Version    : 3.3
//------------------------------------------------------------------------------
//  Filename     :  pipe_wrapper.v
//  Description  :  PIPE Wrapper for 7 Series Transceiver
//  Version      :  20.2
//------------------------------------------------------------------------------

//---------- PIPE Wrapper Hierarchy --------------------------------------------
//  pipe_wrapper.v 
//      pipe_clock.v
//      pipe_reset.v or gtp_pipe_reset.v
//      qpll_reset.v
//          * Generate GTXE2_CHANNEL for every lane.
//              pipe_user.v
//              pipe_rate.v or gtp_pipe_rate.v
//              pipe_sync.v 
//              pipe_drp.v or gtp_pipe_drp.v
//              pipe_eq.v
//                  rxeq_scan.v
//              gt_wrapper.v
//                  GTXE2_CHANNEL or GTHE2_CHANNEL or GTPE2_CHANNEL
//                  GTXE2_COMMON  or GTHE2_COMMON or GTPE2_CHANNEL
//          * Generate GTXE2_COMMON for every quad.
//              qpll_drp.v
//              qpll_wrapper.v
//------------------------------------------------------------------------------

//---------- PIPE Wrapper Parameter Encoding -----------------------------------
//  PCIE_SIM_MODE                 : "FALSE" = Normal mode (default)
//                                : "TRUE"  = Simulation only
//  PCIE_SIM_TX_EIDLE_DRIVE_LEVEL : "0", "1" (default), "X" simulation TX electrical idle drive level 
//  PCIE_GT_DEVICE                : "GTX" (default)
//                                : "GTH"
//                                : "GTP"
//  PCIE_USE_MODE                 : "1.0" = GTX IES 325T or GTP IES/GES use mode.
//                                : "1.1" = GTX IES 485T use mode.
//                                : "2.0" = GTH IES 690T use mode for 1.0 silicon.
//                                : "2.1" = GTH GES 690T use mode for 1.2 and 2.0 silicon.  SW model use "2.0"
//                                : "3.0" = GTX GES 325T or 485T use mode (default).
//  PCIE_PLL_SEL                  : "CPLL" (default)
//                                : "QPLL"
//  PCIE_AUX_CDR_GEN3_EN          : "FALSE" Use Primary CDR for Gen3 only (GTH 2.0) 
//                                : "TRUE"  Use AUX CDR for Gen3 only (default) (GTH 2.0)
//  PCIE_LPM_DFE                  : "DFE" for Gen1/Gen2 only (GTX, GTH)
//                                : "LPM" for Gen1/Gen2 only (default) (GTX, GTH)
//  PCIE_LPM_DFE_GEN3             : "DFE" for Gen3 only (GTX, GTH)
//                                : "LPM" for Gen3 only (default) (GTX, GTH)
//  PCIE_EXT_CLK                  : "FALSE" = Use internal clock module(default)
//                                : "TRUE"  = Use external clock module
//  PCIE_POWER_SAVING             : "FALSE" = Disable PLL power saving
//                                : "TRUE"  = Enable PLL power saving (default)
//  PCIE_ASYNC_EN                 : "FALSE" = Synchronous  mode (default)
//                                : "TRUE"  = Asynchronous mode.
//  PCIE_TXBUF_EN                 : "FALSE" = TX buffer bypass for Gen1/Gen2 only (default)
//                                : "TRUE"  = TX buffer use    for Gen1/Gen2 only (for debug only)
//  PCIE_RXBUF_EN                 : "FALSE" = RX buffer bypass for Gen3      only (not supported)
//                                : "TRUE"  = RX buffer use    for Gen3      only (default)
//  PCIE_TXSYNC_MODE              : 0 = Manual TX sync (default) (GTX, GTH)
//                                : 1 = Auto TX sync (GTH)
//  PCIE_RXSYNC_MODE              : 0 = Manual RX sync (default) (GTX, GTH)
//                                : 1 = Auto RX sync (GTH)
//  PCIE_CHAN_BOND                : 0 = One-Hop (default)
//                                : 1 = Daisy-Chain
//                                : 2 = Binary-Tree
//  PCIE_CHAN_BOND_EN             : "FALSE" = Channel bonding disable for Gen1/Gen2 only
//                                : "TRUE"  = Channel bonding enable  for Gen1/Gen2 only
//  PCIE_LANE                     : 1 (default), 2, 4, or 8
//  PCIE_LINK_SPEED               : 1 = PCIe Gen1           Mode
//                                : 2 = PCIe Gen1/Gen2      Mode (default)
//                                : 3 = PCIe Gen1/Gen2/Gen3 Mode
//  PCIE_REFCLK_FREQ              : 0 = 100 MHz (default)
//                                : 1 = 125 MHz
//                                : 2 = 250 MHz
//  PCIE_USERCLK[1/2]_FREQ        : 0 = Disable user clock
//                                : 1 =  31.25 MHz
//                                : 2 =  62.50 MHz (default)
//                                : 3 = 125.00 MHz
//                                : 4 = 250.00 MHz
//                                : 5 = 500.00 MHz
//  PCIE_TX_EIDLE_ASSERT_DELAY    : 3'd0 to 3'd7 (default = 3'd4)
//  PCIE_RXEQ_MODE_GEN3           : 0 = Return same TX coefficients 
//                                : 1 = Return TX preset #5
//  PCIE_OOBCLK_MODE              : 0 = Reference clock
//                                : 1 =  62.50 MHz (default)
//                                : 2 =  50.00 MHz (requires 1 BUFG)
//  PCIE_JTAG_MODE                : 0 = Normal operation (default)
//                                : 1 = JTAG mode (for debug only)
//  PCIE_DEBUG_MODE               : 0 = Normal operation (default)
//                                : 1 = Debug mode (for debug only)
//------------------------------------------------------------------------------

//---------- Notes -------------------------------------------------------------
//  Notes within the PIPE Wrapper RTL files are for internal use only.
//  Data Width : This PIPE Wrapper supports a 32-bit [TX/RX]DATA interface.  
//               In Gen1/Gen2 modes, only 16-bits [15:0] are used.
//               In Gen3 mode, all 32-bits are used.
//------------------------------------------------------------------------------


`timescale 1ns / 1ps


//---------- PIPE Wrapper ------------------------------------------------------
(* DowngradeIPIdentifiedWarnings = "yes" *)
module pcie_7x_0_pipe_wrapper #
(

    parameter PCIE_SIM_MODE                 = "FALSE",      // PCIe sim mode 
    parameter PCIE_SIM_SPEEDUP              = "FALSE",      // PCIe sim speedup
    parameter PCIE_SIM_TX_EIDLE_DRIVE_LEVEL = "1",          // PCIe sim TX electrical idle drive level 
    parameter PCIE_GT_DEVICE                = "GTP",        // PCIe GT device
    parameter PCIE_USE_MODE                 = "1.0",        // PCIe use mode
    parameter PCIE_PLL_SEL                  = "CPLL",       // PCIe PLL select for Gen1/Gen2 (GTX/GTH) only
    parameter PCIE_AUX_CDR_GEN3_EN          = "TRUE",       // PCIe AUX CDR for Gen3 (GTH 2.0) only
    parameter PCIE_LPM_DFE                  = "LPM",        // PCIe LPM or DFE mode for Gen1/Gen2 only
    parameter PCIE_LPM_DFE_GEN3             = "DFE",        // PCIe LPM or DFE mode for Gen3      only
    parameter PCIE_EXT_CLK                  = "FALSE",      // PCIe external clock
    parameter PCIE_EXT_GT_COMMON            = "TRUE",      // PCIe external GT COMMON
    parameter EXT_CH_GT_DRP                 = "FALSE",      // PCIe external CH DRP

    parameter TX_MARGIN_FULL_0              = 7'b1001111,                          // 1000 mV
    parameter TX_MARGIN_FULL_1              = 7'b1001110,                          // 950 mV
    parameter TX_MARGIN_FULL_2              = 7'b1001101,                          // 900 mV
    parameter TX_MARGIN_FULL_3              = 7'b1001100,                          // 850 mV
    parameter TX_MARGIN_FULL_4              = 7'b1000011,                          // 400 mV
    parameter TX_MARGIN_LOW_0               = 7'b1000101,                          // 500 mV
    parameter TX_MARGIN_LOW_1               = 7'b1000110 ,                          // 450 mV
    parameter TX_MARGIN_LOW_2               = 7'b1000011,                          // 400 mV
    parameter TX_MARGIN_LOW_3               = 7'b1000010 ,                          // 350 mV
    parameter TX_MARGIN_LOW_4               = 7'b1000000 ,

    parameter PCIE_POWER_SAVING             = "TRUE",       // PCIe power saving
    parameter PCIE_ASYNC_EN                 = "FALSE",      // PCIe async enable
    parameter PCIE_TXBUF_EN                 = "FALSE",      // PCIe TX buffer enable for Gen1/Gen2 only
    parameter PCIE_RXBUF_EN                 = "TRUE",       // PCIe RX buffer enable for Gen3      only
    parameter PCIE_TXSYNC_MODE              = 0,            // PCIe TX sync mode
    parameter PCIE_RXSYNC_MODE              = 0,            // PCIe RX sync mode
    parameter PCIE_CHAN_BOND                = 1,            // PCIe channel bonding mode
    parameter PCIE_CHAN_BOND_EN             = "TRUE",       // PCIe channel bonding enable for Gen1/Gen2 only
    parameter PCIE_LANE                     = 1,            // PCIe number of lanes
    parameter PCIE_LINK_SPEED               = 1,            // PCIe link speed 
    parameter PCIE_REFCLK_FREQ              = 0,            // PCIe reference clock frequency
    parameter PCIE_USERCLK1_FREQ            = 2,            // PCIe user clock 1 frequency
    parameter PCIE_USERCLK2_FREQ            = 2,            // PCIe user clock 2 frequency
    parameter PCIE_TX_EIDLE_ASSERT_DELAY    = 3'd2,         // PCIe TX electrical idle assert delay
    parameter PCIE_RXEQ_MODE_GEN3           = 1,            // PCIe RX equalization mode
    parameter PCIE_OOBCLK_MODE              = 1,            // PCIe OOB clock mode
    parameter PCIE_JTAG_MODE                = 0,            // PCIe JTAG mode
    parameter PCIE_DEBUG_MODE               = 0             // PCIe debug mode 
    
)                                                     
                                                            //--------------------------------------
(                                                           // Gen1/Gen2  | Gen3 
                                                            //--------------------------------------
    //---------- PIPE Clock & Reset Ports ------------------
    input                           PIPE_CLK,               // Reference clock that drives MMCM
    input                           PIPE_RESET_N,           // PCLK       | PCLK
   
    output                          PIPE_PCLK,              // Drives [TX/RX]USRCLK in Gen1/Gen2
                                                            // Drives TXUSRCLK in Gen3
                                                            // Drives RXUSRCLK in Gen3 async mode only
    //---------- PIPE TX Data Ports ------------------------
    input       [(PCIE_LANE*32)-1:0]PIPE_TXDATA,            // PCLK       | PCLK
    input       [(PCIE_LANE*4)-1:0] PIPE_TXDATAK,           // PCLK       | PCLK
    
    output      [PCIE_LANE-1:0]     PIPE_TXP,               // Serial data
    output      [PCIE_LANE-1:0]     PIPE_TXN,               // Serial data

    //---------- PIPE RX Data Ports ------------------------
    input       [PCIE_LANE-1:0]     PIPE_RXP,               // Serial data
    input       [PCIE_LANE-1:0]     PIPE_RXN,               // Serial data
    
    output      [(PCIE_LANE*32)-1:0]PIPE_RXDATA,            // PCLK       | RXUSRCLK
    output      [(PCIE_LANE*4)-1:0] PIPE_RXDATAK,           // PCLK       | RXUSRCLK
    
    //---------- PIPE Command Ports ------------------------
    input                           PIPE_TXDETECTRX,        // PCLK       | PCLK
    input       [PCIE_LANE-1:0]     PIPE_TXELECIDLE,        // PCLK       | PCLK
    input       [PCIE_LANE-1:0]     PIPE_TXCOMPLIANCE,      // PCLK       | PCLK   
    input       [PCIE_LANE-1:0]     PIPE_RXPOLARITY,        // PCLK       | RXUSRCLK
    input       [(PCIE_LANE*2)-1:0] PIPE_POWERDOWN,         // PCLK       | PCLK
    input       [ 1:0]              PIPE_RATE,              // PCLK       | PCLK
    
    //---------- PIPE Electrical Command Ports -------------   
    input       [ 2:0]              PIPE_TXMARGIN,          // Async      | Async 
    input                           PIPE_TXSWING,           // Async      | Async 
    input       [PCIE_LANE-1:0]     PIPE_TXDEEMPH,          // Async/PCLK | Async/PCLK  
    input       [(PCIE_LANE*2)-1:0] PIPE_TXEQ_CONTROL,      // PCLK       | PCLK  
    input       [(PCIE_LANE*4)-1:0] PIPE_TXEQ_PRESET,       // PCLK       | PCLK  
    input       [(PCIE_LANE*4)-1:0] PIPE_TXEQ_PRESET_DEFAULT,// PCLK      | PCLK 
    input       [(PCIE_LANE*6)-1:0] PIPE_TXEQ_DEEMPH,       // PCLK       | PCLK  
                                                                            
    input       [(PCIE_LANE*2)-1:0] PIPE_RXEQ_CONTROL,      // PCLK       | PCLK  
    input       [(PCIE_LANE*3)-1:0] PIPE_RXEQ_PRESET,       // PCLK       | PCLK  
    input       [(PCIE_LANE*6)-1:0] PIPE_RXEQ_LFFS,         // PCLK       | PCLK  
    input       [(PCIE_LANE*4)-1:0] PIPE_RXEQ_TXPRESET,     // PCLK       | PCLK  
    input       [PCIE_LANE-1:0]     PIPE_RXEQ_USER_EN,      // PCLK       | PCLK      
    input       [(PCIE_LANE*18)-1:0]PIPE_RXEQ_USER_TXCOEFF, // PCLK       | PCLK
    input       [PCIE_LANE-1:0]     PIPE_RXEQ_USER_MODE,    // PCLK       | PCLK
                                                                           
    output      [ 5:0]              PIPE_TXEQ_FS,           // Async      | Async  
    output      [ 5:0]              PIPE_TXEQ_LF,           // Async      | Async 
    output      [(PCIE_LANE*18)-1:0]PIPE_TXEQ_COEFF,        // PCLK       | PCLK  
    output      [PCIE_LANE-1:0]     PIPE_TXEQ_DONE,         // PCLK       | PCLK  
                                                                           
    output      [(PCIE_LANE*18)-1:0]PIPE_RXEQ_NEW_TXCOEFF,  // PCLK       | PCLK  
    output      [PCIE_LANE-1:0]     PIPE_RXEQ_LFFS_SEL,     // PCLK       | PCLK  
    output      [PCIE_LANE-1:0]     PIPE_RXEQ_ADAPT_DONE,   // PCLK       | PCLK  
    output      [PCIE_LANE-1:0]     PIPE_RXEQ_DONE,         // PCLK       | PCLK  
    
    //---------- PIPE Status Ports -------------------------
    output      [PCIE_LANE-1:0]     PIPE_RXVALID,           // PCLK       | RXUSRCLK
    output      [PCIE_LANE-1:0]     PIPE_PHYSTATUS,         // PCLK       | RXUSRCLK
    output      [PCIE_LANE-1:0]     PIPE_PHYSTATUS_RST,     // PCLK       | RXUSRCLK
    output      [PCIE_LANE-1:0]     PIPE_RXELECIDLE,        // Async      | Async
    output      [PCIE_LANE-1:0]     PIPE_EYESCANDATAERROR,  // Async      | Async
    output      [(PCIE_LANE*3)-1:0] PIPE_RXSTATUS,          // PCLK       | RXUSRCLK
    output      [PCIE_LANE-1:0]     PIPE_RXPMARESETDONE,    // Async      | Async
    output      [(PCIE_LANE*3)-1:0] PIPE_RXBUFSTATUS,       // PCLK       | RXUSRCLK
    output      [PCIE_LANE-1:0]     PIPE_TXPHALIGNDONE,     // Async      | Async
    output      [PCIE_LANE-1:0]     PIPE_TXPHINITDONE,      // Async      | Async
    output      [PCIE_LANE-1:0]     PIPE_TXDLYSRESETDONE,   // Async      | Async
    output      [PCIE_LANE-1:0]     PIPE_RXPHALIGNDONE,     // Async      | Async
    output      [PCIE_LANE-1:0]     PIPE_RXDLYSRESETDONE,   // Async      | Async
    output      [PCIE_LANE-1:0]     PIPE_RXSYNCDONE,        // PCLK       | RXUSRCLK
    output      [(PCIE_LANE*8)-1:0] PIPE_RXDISPERR,         // PCLK       | RXUSRCLK
    output      [(PCIE_LANE*8)-1:0] PIPE_RXNOTINTABLE,      // PCLK       | RXUSRCLK
    output      [PCIE_LANE-1:0]     PIPE_RXCOMMADET,        // PCLK       | RXUSRCLK
    
    //---------- PIPE User Ports ---------------------------
    input                           PIPE_MMCM_RST_N,        // Async      | Async
    input       [PCIE_LANE-1:0]     PIPE_RXSLIDE,           // PCLK       | RXUSRCLK
    
    output      [PCIE_LANE-1:0]     PIPE_CPLL_LOCK,         // Async      | Async
    output      [(PCIE_LANE-1)>>2:0]PIPE_QPLL_LOCK,         // Async      | Async
    output                          PIPE_PCLK_LOCK,         // Async      | Async
    output      [PCIE_LANE-1:0]     PIPE_RXCDRLOCK,         // Async      | Async
    output                          PIPE_USERCLK1,          // Optional user clock
    output                          PIPE_USERCLK2,          // Optional user clock
    output                          PIPE_RXUSRCLK,          // RXUSRCLK 
                                                            // Equivalent to PCLK in Gen1/Gen2
                                                            // Equivalent to RXOUTCLK[0] in Gen3
    output      [PCIE_LANE-1:0]     PIPE_RXOUTCLK,          // RX recovered clock (for debug only)
    output      [PCIE_LANE-1:0]     PIPE_TXSYNC_DONE,       // PCLK       | PCLK
    output      [PCIE_LANE-1:0]     PIPE_RXSYNC_DONE,       // PCLK       | PCLK
    output      [PCIE_LANE-1:0]     PIPE_GEN3_RDY,          // PCLK       | RXUSRCLK
    output      [PCIE_LANE-1:0]     PIPE_RXCHANISALIGNED,
    output      [PCIE_LANE-1:0]     PIPE_ACTIVE_LANE,

// Shared Logic Internal
    output                          INT_PCLK_OUT_SLAVE,     // PCLK       | PCLK
    output                          INT_RXUSRCLK_OUT,       // RXUSERCLK
    output  [PCIE_LANE-1:0  ]       INT_RXOUTCLK_OUT,       // RX recovered clock
    output                          INT_DCLK_OUT,           // DCLK       | DCLK
    output                          INT_USERCLK1_OUT,       // Optional user clock
    output                          INT_USERCLK2_OUT,       // Optional user clock
    output                          INT_OOBCLK_OUT,         // OOB        | OOB
    output                          INT_MMCM_LOCK_OUT,      // Async      | Async
    output  [1:0]                   INT_QPLLLOCK_OUT,
    output  [1:0]                   INT_QPLLOUTCLK_OUT,
    output  [1:0]                   INT_QPLLOUTREFCLK_OUT,
    input   [PCIE_LANE-1:0]         INT_PCLK_SEL_SLAVE,

 
  // Shared Logic External
    
    //---------- External Clock Ports ----------------------
    input                           PIPE_PCLK_IN,           // PCLK       | PCLK
    input                           PIPE_RXUSRCLK_IN,       // RXUSERCLK
                                                            // Equivalent to PCLK in Gen1/Gen2
                                                            // Equivalent to RXOUTCLK[0] in Gen3
    input       [PCIE_LANE-1:0]     PIPE_RXOUTCLK_IN,       // RX recovered clock
    input                           PIPE_DCLK_IN,           // DCLK       | DCLK
    input                           PIPE_USERCLK1_IN,       // Optional user clock
    input                           PIPE_USERCLK2_IN,       // Optional user clock
    input                           PIPE_OOBCLK_IN,         // OOB        | OOB
    input                           PIPE_MMCM_LOCK_IN,      // Async      | Async
    
    output                          PIPE_TXOUTCLK_OUT,      // PCLK       | PCLK
    output      [PCIE_LANE-1:0]     PIPE_RXOUTCLK_OUT,      // RX recovered clock (for debug only)
    output      [PCIE_LANE-1:0]     PIPE_PCLK_SEL_OUT,      // PCLK       | PCLK
    output                          PIPE_GEN3_OUT,          // PCLK       | PCLK
    //---------- External GT COMMON Ports ----------------------
    input       [11:0]              QPLL_DRP_CRSCODE,
    input       [17:0]              QPLL_DRP_FSM,
    input       [1:0]               QPLL_DRP_DONE,
    input       [1:0]               QPLL_DRP_RESET,
    input       [1:0]               QPLL_QPLLLOCK,
    input       [1:0]               QPLL_QPLLOUTCLK,
    input       [1:0]               QPLL_QPLLOUTREFCLK,
    output              	          QPLL_QPLLPD,
    output      [1:0]               QPLL_QPLLRESET,
    output              	          QPLL_DRP_CLK,
    output              	          QPLL_DRP_RST_N,
    output              	          QPLL_DRP_OVRD,
    output              	          QPLL_DRP_GEN3,
    output              	          QPLL_DRP_START,

    //---------- TRANSCEIVER DEBUG -----------------------
    input       [ 2:0]              PIPE_TXPRBSSEL,         // PCLK       | PCLK
    input       [ 2:0]              PIPE_RXPRBSSEL,         // PCLK       | PCLK
    input                           PIPE_TXPRBSFORCEERR,    // PCLK       | PCLK
    input                           PIPE_RXPRBSCNTRESET,    // PCLK       | PCLK
    input       [ 2:0]              PIPE_LOOPBACK,          // PCLK       | PCLK
    
    output      [PCIE_LANE-1:0]     PIPE_RXPRBSERR,         // PCLK       | PCLK
    input       [PCIE_LANE-1:0]     PIPE_TXINHIBIT,         // PCLK       | PCLK
    
    //---------- FSM Ports ---------------------------------
    output      [4:0]               PIPE_RST_FSM,           // PCLK       | PCLK
    output      [11:0]              PIPE_QRST_FSM,          // PCLK       | PCLK
    output      [(PCIE_LANE*5)-1:0] PIPE_RATE_FSM,          // PCLK       | PCLK
    output      [(PCIE_LANE*6)-1:0] PIPE_SYNC_FSM_TX,       // PCLK       | PCLK
    output      [(PCIE_LANE*7)-1:0] PIPE_SYNC_FSM_RX,       // PCLK       | PCLK
    output      [(PCIE_LANE*7)-1:0] PIPE_DRP_FSM,           // DCLK       | DCLK
    output      [(PCIE_LANE*6)-1:0] PIPE_TXEQ_FSM,          // PCLK       | PCLK
    output      [(PCIE_LANE*6)-1:0] PIPE_RXEQ_FSM,          // PCLK       | PCLK
    output      [((((PCIE_LANE-1)>>2)+1)*9)-1:0]PIPE_QDRP_FSM, // DCLK    | DCLK  
        
    output                          PIPE_RST_IDLE,          // PCLK       | PCLK 
    output                          PIPE_QRST_IDLE,         // PCLK       | PCLK 
    output                          PIPE_RATE_IDLE,         // PCLK       | PCLK 
    
    //----------- Channel DRP----------------------------
    output                            EXT_CH_GT_DRPCLK,
    input        [(PCIE_LANE*9)-1:0] EXT_CH_GT_DRPADDR,
    input        [PCIE_LANE-1:0]     EXT_CH_GT_DRPEN,
    input        [(PCIE_LANE*16)-1:0]EXT_CH_GT_DRPDI,
    input        [PCIE_LANE-1:0]     EXT_CH_GT_DRPWE,

    output       [(PCIE_LANE*16)-1:0]EXT_CH_GT_DRPDO,
    output       [PCIE_LANE-1:0]     EXT_CH_GT_DRPRDY,

    //---------- JTAG Ports --------------------------------
    input                           PIPE_JTAG_EN,           // DCLK       | DCLK
    output      [PCIE_LANE-1:0]     PIPE_JTAG_RDY,          // DCLK       | DCLK
    
    //---------- Debug Ports -------------------------------
    output      [PCIE_LANE-1:0]     PIPE_DEBUG_0,           // Async      | Async 
    output      [PCIE_LANE-1:0]     PIPE_DEBUG_1,           // Async      | Async 
    output      [PCIE_LANE-1:0]     PIPE_DEBUG_2,           // Async      | Async 
    output      [PCIE_LANE-1:0]     PIPE_DEBUG_3,           // Async      | Async 
    output      [PCIE_LANE-1:0]     PIPE_DEBUG_4,           // Async      | Async 
    output      [PCIE_LANE-1:0]     PIPE_DEBUG_5,           // Async      | Async   
    output      [PCIE_LANE-1:0]     PIPE_DEBUG_6,           // Async      | Async   
    output      [PCIE_LANE-1:0]     PIPE_DEBUG_7,           // Async      | Async   
    output      [PCIE_LANE-1:0]     PIPE_DEBUG_8,           // Async      | Async   
    output      [PCIE_LANE-1:0]     PIPE_DEBUG_9,           // Async      | Async   
    output      [31:0]              PIPE_DEBUG,             // Async      | Async 
    
    output      [(PCIE_LANE*15)-1:0] PIPE_DMONITOROUT       // DMONITORCLK
    
);

    //---------- Input Registers ---------------------------
(* ASYNC_REG = "TRUE", SHIFT_EXTRACT = "NO" *)    reg                             reset_n_reg1;
(* ASYNC_REG = "TRUE", SHIFT_EXTRACT = "NO" *)    reg                             reset_n_reg2;

    //---------- PIPE Clock Module Output ------------------ 
    wire                            clk_pclk;  
    wire                            clk_rxusrclk;
    wire        [PCIE_LANE-1:0]     clk_rxoutclk;
    wire                            clk_dclk;
    wire                            clk_oobclk;
    wire                            clk_mmcm_lock;
    
    //---------- PIPE Reset Module Output ------------------
    wire                            rst_cpllreset;
    wire                            rst_cpllpd;
    wire                            rst_rxusrclk_reset;
    wire                            rst_dclk_reset;   
    wire rst_gtreset;
    wire                            rst_drp_start;
    wire                            rst_drp_x16x20_mode;
    wire                            rst_drp_x16;
    wire rst_userrdy;
    wire                            rst_txsync_start;
    wire                            rst_idle;
    wire        [4:0]               rst_fsm;
    
    //------------------------------------------------------
    wire                            gtp_rst_qpllreset;      // GTP
    wire                            gtp_rst_qpllpd;         // GTP
    
    //------------------------------------------------------
    wire        [(PCIE_LANE-1)>>2:0]qpllreset;          
    wire                            qpllpd;
    
    //---------- QPLL Reset Module Output ------------------
    wire                            qrst_ovrd;
    wire                            qrst_drp_start;
    wire                            qrst_qpllreset;
    wire                            qrst_qpllpd;
    wire                            qrst_idle;
    wire        [3:0]               qrst_fsm;
    
    //---------- PIPE_JTAG Master Module Output ------------
    wire        [(PCIE_LANE*37)-1:0] jtag_sl_iport;
    wire        [(PCIE_LANE*17)-1:0] jtag_sl_oport;
    
    //---------- PIPE User Module Output -------------------
    wire [PCIE_LANE-1:0] gt_txpmareset_i;                 
    wire [PCIE_LANE-1:0] gt_rxpmareset_i;                 

    wire        [PCIE_LANE-1:0]     user_oobclk;
    wire        [PCIE_LANE-1:0]     user_resetovrd;
    wire        [PCIE_LANE-1:0]     user_txpmareset;                 
    wire        [PCIE_LANE-1:0]     user_rxpmareset;                
    wire        [PCIE_LANE-1:0]     user_rxcdrreset;
    wire        [PCIE_LANE-1:0]     user_rxcdrfreqreset;
    wire [PCIE_LANE-1:0] user_rxdfelpmreset;
    wire [PCIE_LANE-1:0] user_eyescanreset;
    wire [PCIE_LANE-1:0] user_txpcsreset;                   
    wire [PCIE_LANE-1:0] user_rxpcsreset;                 
    wire [PCIE_LANE-1:0] user_rxbufreset;
    wire        [PCIE_LANE-1:0]     user_resetovrd_done;
    wire        [PCIE_LANE-1:0]     user_active_lane;
    wire        [PCIE_LANE-1:0]     user_resetdone /* synthesis syn_keep=1 */;
    wire        [PCIE_LANE-1:0]     user_rxcdrlock;
    wire        [PCIE_LANE-1:0]     user_rx_converge; 
    wire        [PCIE_LANE-1:0]     PIPE_RXEQ_CONVERGE; 
    
    //---------- PIPE Rate Module Output -------------------
    wire        [PCIE_LANE-1:0]     rate_cpllpd;
    wire        [PCIE_LANE-1:0]     rate_qpllpd;
    wire        [PCIE_LANE-1:0]     rate_cpllreset;
    wire        [PCIE_LANE-1:0]     rate_qpllreset;
    wire        [PCIE_LANE-1:0]     rate_txpmareset;
    wire        [PCIE_LANE-1:0]     rate_rxpmareset;
    wire        [(PCIE_LANE*2)-1:0] rate_sysclksel;
    wire        [PCIE_LANE-1:0]     rate_pclk_sel;
    wire        [PCIE_LANE-1:0]     rate_drp_start;
    wire        [PCIE_LANE-1:0]     rate_drp_x16x20_mode;
    wire        [PCIE_LANE-1:0]     rate_drp_x16;
    wire        [PCIE_LANE-1:0]     rate_gen3;
    wire        [(PCIE_LANE*3)-1:0] rate_rate;
    wire        [PCIE_LANE-1:0]     rate_resetovrd_start;
    wire        [PCIE_LANE-1:0]     rate_txsync_start;
    wire        [PCIE_LANE-1:0]     rate_done;
    wire        [PCIE_LANE-1:0]     rate_rxsync_start;
    wire        [PCIE_LANE-1:0]     rate_rxsync;
    wire        [PCIE_LANE-1:0]     rate_idle;
    wire        [(PCIE_LANE*5)-1:0] rate_fsm;

    //---------- PIPE Sync Module Output -------------------
    wire        [PCIE_LANE-1:0]     sync_txphdlyreset;
    wire        [PCIE_LANE-1:0]     sync_txphalign;    
    wire        [PCIE_LANE-1:0]     sync_txphalignen; 
    wire        [PCIE_LANE-1:0]     sync_txphinit;   
    wire        [PCIE_LANE-1:0]     sync_txdlybypass; 
    wire        [PCIE_LANE-1:0]     sync_txdlysreset;   
    wire        [PCIE_LANE-1:0]     sync_txdlyen;      
    wire        [PCIE_LANE-1:0]     sync_txsync_done;
    wire        [(PCIE_LANE*6)-1:0] sync_fsm_tx;
    
    wire        [PCIE_LANE-1:0]     sync_rxphalign;
    wire        [PCIE_LANE-1:0]     sync_rxphalignen;
    wire        [PCIE_LANE-1:0]     sync_rxdlybypass;
    wire        [PCIE_LANE-1:0]     sync_rxdlysreset;
    wire        [PCIE_LANE-1:0]     sync_rxdlyen;
    wire        [PCIE_LANE-1:0]     sync_rxddien;
    wire        [PCIE_LANE-1:0]     sync_rxsync_done; 
    wire        [PCIE_LANE-1:0]     sync_rxsync_donem;      
    wire        [(PCIE_LANE*7)-1:0] sync_fsm_rx;
 
    wire        [PCIE_LANE-1:0]     txdlysresetdone;
    wire        [PCIE_LANE-1:0]     txphaligndone;
    wire        [PCIE_LANE-1:0]     rxdlysresetdone;
    wire        [PCIE_LANE-1:0]     rxphaligndone_s;    
    
    wire                            txsyncallin;            // GTH     
    wire                            rxsyncallin;            // GTH
    
    //---------- PIPE DRP Module Output --------------------
    wire        [(PCIE_LANE*9)-1:0] drp_addr;
    wire        [PCIE_LANE-1:0]     drp_en;
    wire        [(PCIE_LANE*16)-1:0]drp_di;   
    wire        [PCIE_LANE-1:0]     drp_we;
    wire        [PCIE_LANE-1:0]     drp_done;
    wire        [(PCIE_LANE*3)-1:0] drp_fsm;

    //---------- PIPE JTAG Slave Module Output--------------
    wire	      [(PCIE_LANE*17)-1:0]jtag_sl_addr;
    wire        [PCIE_LANE-1:0]     jtag_sl_den;
    wire        [PCIE_LANE-1:0]     jtag_sl_en;
    wire        [(PCIE_LANE*16)-1:0]jtag_sl_di;
    wire        [PCIE_LANE-1:0]     jtag_sl_we;
    
    //---------- PIPE DRP MUX Output -----------------------
    wire	      [(PCIE_LANE*9)-1:0] drp_mux_addr;
    wire        [PCIE_LANE-1:0]     drp_mux_en;
    wire        [(PCIE_LANE*16)-1:0]drp_mux_di;
    wire        [PCIE_LANE-1:0]     drp_mux_we;

    //---------- PIPE EQ Module Output ---------------------
    wire        [PCIE_LANE-1:0]     eq_txeq_deemph;
    wire [(PCIE_LANE*5)-1:0] eq_txeq_precursor;
    wire        [(PCIE_LANE*7)-1:0] eq_txeq_maincursor;
    wire [(PCIE_LANE*5)-1:0] eq_txeq_postcursor;
    
    wire        [PCIE_LANE-1:0]     eq_rxeq_adapt_done;
    
    //---------- PIPE DRP Module Output --------------------
    wire        [((((PCIE_LANE-1)>>2)+1)*8)-1:0]  qdrp_addr;
    wire        [(PCIE_LANE-1)>>2:0]              qdrp_en;
    wire        [((((PCIE_LANE-1)>>2)+1)*16)-1:0] qdrp_di;   
    wire        [(PCIE_LANE-1)>>2:0]              qdrp_we;
    wire        [(PCIE_LANE-1)>>2:0]              qdrp_done;
    wire        [(PCIE_LANE-1)>>2:0]              qdrp_qpllreset;
    wire        [((((PCIE_LANE-1)>>2)+1)*6)-1:0]  qdrp_crscode;
    wire        [((((PCIE_LANE-1)>>2)+1)*9)-1:0]  qdrp_fsm;

    //---------- QPLL Wrapper Output -----------------------
    wire        [(PCIE_LANE-1)>>2:0]              qpll_qplloutclk;
    wire        [(PCIE_LANE-1)>>2:0]              qpll_qplloutrefclk;
    wire        [(PCIE_LANE-1)>>2:0]              qpll_qplllock;
    wire        [((((PCIE_LANE-1)>>2)+1)*16)-1:0] qpll_do;
    wire        [(PCIE_LANE-1)>>2:0]              qpll_rdy;

    //---------- GTX Wrapper Output ------------------------
    wire        [PCIE_LANE-1:0]     gt_txoutclk;
    wire        [PCIE_LANE-1:0]     gt_rxoutclk;
    wire        [PCIE_LANE-1:0] gt_cplllock;
    wire        [PCIE_LANE-1:0]     gt_rxcdrlock;
    wire        [PCIE_LANE-1:0]     gt_txresetdone;
    wire        [PCIE_LANE-1:0]     gt_rxresetdone;
    wire        [PCIE_LANE-1:0]     gt_eyescandataerror;
    wire        [PCIE_LANE-1:0] gt_rxpmaresetdone;
    wire        [(PCIE_LANE*8)-1:0]     gt_rxdisperr;
    wire        [(PCIE_LANE*8)-1:0]     gt_rxnotintable;
    wire        [PCIE_LANE-1:0]     gt_rxvalid;
    wire        [PCIE_LANE-1:0]     gt_phystatus;
    wire        [(PCIE_LANE*3)-1:0] gt_rxstatus;
    wire        [(PCIE_LANE*3)-1:0] gt_rxbufstatus;
    wire        [PCIE_LANE-1:0]     gt_rxelecidle;
    wire        [PCIE_LANE-1:0]     gt_txratedone;
    wire        [PCIE_LANE-1:0]     gt_rxratedone;
    wire        [(PCIE_LANE*16)-1:0]gt_do;
    wire        [PCIE_LANE-1:0]     gt_rdy;
    wire        [PCIE_LANE-1:0] gt_txphinitdone;  
    wire        [PCIE_LANE-1:0] gt_txdlysresetdone;
    wire        [PCIE_LANE-1:0] gt_txphaligndone;
    wire        [PCIE_LANE-1:0] gt_rxdlysresetdone;
    wire        [PCIE_LANE:0] gt_rxphaligndone;       // Custom width for calculation        
    wire        [PCIE_LANE-1:0]     gt_txsyncout;           // GTH  
    wire        [PCIE_LANE-1:0]     gt_txsyncdone;          // GTH                                                           
    wire        [PCIE_LANE-1:0]     gt_rxsyncout;           // GTH     
    wire        [PCIE_LANE-1:0] gt_rxsyncdone;          // GTH     
    wire        [PCIE_LANE-1:0] gt_rxcommadet;                        
    wire        [(PCIE_LANE*4)-1:0] gt_rxchariscomma;                      
    wire        [PCIE_LANE-1:0]     gt_rxbyteisaligned;                   
    wire        [PCIE_LANE-1:0]     gt_rxbyterealign; 
    wire        [ 4:0]              gt_rxchbondi [PCIE_LANE:0]; 
    wire        [(PCIE_LANE*3)-1:0] gt_rxchbondlevel;
    wire        [ 4:0]              gt_rxchbondo [PCIE_LANE:0];  
   
    wire        [PCIE_LANE-1:0]     rxchbonden;
    wire        [PCIE_LANE-1:0]     rxchbondmaster;
    wire        [PCIE_LANE-1:0]     rxchbondslave;    
    wire        [PCIE_LANE-1:0]     oobclk; 

    //---------- TX EQ -------------------------------------                                      
    localparam                      TXEQ_FS = 6'd40;        // TX equalization full swing 
    localparam                      TXEQ_LF = 6'd15;        // TX equalization low frequency

    //---------- Select JTAG Slave Type ----------------------------------------
    localparam GC_XSDB_SLAVE_TYPE = (PCIE_GT_DEVICE == "GTP") ? 16'h0400 : (PCIE_GT_DEVICE == "GTH") ? 16'h004A : 16'h0046; 

    //---------- Generate Per-Lane Signals -----------------
    genvar                          i;                      // Index for per-lane signals
    
    
    
//---------- Assignments -------------------------------------------------------
assign gt_rxchbondo[0]             = 5'd0;                  // Initialize rxchbond for lane 0 
assign gt_rxphaligndone[PCIE_LANE] = 1'd1;                  // Mot used
assign txsyncallin                 = &(gt_txphaligndone | (~user_active_lane));     
assign rxsyncallin                 = &(gt_rxphaligndone | (~user_active_lane));  

//---------- Reset Synchronizer ------------------------------------------------
always @ (posedge clk_pclk or negedge PIPE_RESET_N)
begin

    if (!PIPE_RESET_N) 
        begin
        reset_n_reg1 <= 1'd0;
        reset_n_reg2 <= 1'd0;
        end
    else
        begin
        reset_n_reg1 <= 1'd1;
        reset_n_reg2 <= reset_n_reg1;
        end   
end  


//---------- PIPE Clock Module -------------------------------------------------
generate

        begin : pipe_clock_int
pcie_7x_0_pipe_clock #
        (
        
            .PCIE_ASYNC_EN                  (PCIE_ASYNC_EN),        // PCIe async enable
            .PCIE_TXBUF_EN                  (PCIE_TXBUF_EN),        // PCIe TX buffer enable for Gen1/Gen2 only
            .PCIE_LANE                      (PCIE_LANE),            // PCIe number of lanes
            .PCIE_LINK_SPEED                (PCIE_LINK_SPEED),      // PCIe link speed 
            .PCIE_REFCLK_FREQ               (PCIE_REFCLK_FREQ),     // PCIe reference clock frequency
            .PCIE_USERCLK1_FREQ             (PCIE_USERCLK1_FREQ),   // PCIe user clock 1 frequency
            .PCIE_USERCLK2_FREQ             (PCIE_USERCLK2_FREQ),   // PCIe user clock 2 frequency
            .PCIE_OOBCLK_MODE               (PCIE_OOBCLK_MODE),     // PCIe OOB clock mode
            .PCIE_DEBUG_MODE                (PCIE_DEBUG_MODE)       // PCIe debug mode
                
        )
        pipe_clock_i
        (
        
            //---------- Input -------------------------------------
            .CLK_CLK                        (PIPE_CLK),
            .CLK_TXOUTCLK                   (gt_txoutclk[0]),       // Reference clock from lane 0
            .CLK_RXOUTCLK_IN                (gt_rxoutclk),         
          //.CLK_RST_N                      (1'b1),                 
            .CLK_RST_N                      (PIPE_MMCM_RST_N),      // Allow system reset for error recovery             
            .CLK_PCLK_SEL                   (rate_pclk_sel),    
            .CLK_PCLK_SEL_SLAVE             (INT_PCLK_SEL_SLAVE ), 
            .CLK_GEN3                       (rate_gen3[0]),          
            
            //---------- Output ------------------------------------
            .CLK_PCLK                       (clk_pclk),
            .CLK_PCLK_SLAVE                 (INT_PCLK_OUT_SLAVE),
            .CLK_RXUSRCLK                   (clk_rxusrclk),  
            .CLK_RXOUTCLK_OUT               (clk_rxoutclk),
            .CLK_DCLK                       (clk_dclk),
            .CLK_USERCLK1                   (PIPE_USERCLK1),
            .CLK_USERCLK2                   (PIPE_USERCLK2),
            .CLK_OOBCLK                     (clk_oobclk),
            .CLK_MMCM_LOCK                  (clk_mmcm_lock)
            
        );

        assign INT_RXUSRCLK_OUT  = clk_rxusrclk;
        assign INT_RXOUTCLK_OUT  = clk_rxoutclk;
        assign INT_DCLK_OUT      = clk_dclk;
        assign INT_USERCLK1_OUT  = PIPE_USERCLK1;
        assign INT_USERCLK2_OUT  = PIPE_USERCLK2;
        assign INT_OOBCLK_OUT    = clk_oobclk;
        assign INT_MMCM_LOCK_OUT = clk_mmcm_lock;
        end 
endgenerate
   



//---------- PIPE Reset Module -------------------------------------------------
generate 

    if (PCIE_GT_DEVICE == "GTP")
        
        begin : gtp_pipe_reset

        //---------- GTP PIPE Reset Module -------------------------------------
pcie_7x_0_gtp_pipe_reset #
        (
        
            .PCIE_SIM_SPEEDUP               (PCIE_SIM_SPEEDUP),                 // PCIe sim mode
          //.PCIE_PLL_SEL                   (PCIE_PLL_SEL),                     // removed for GTP               
          //.PCIE_POWER_SAVING              (PCIE_POWER_SAVING),                // removed for GTP                                
          //.PCIE_TXBUF_EN                  (PCIE_TXBUF_EN),                    // PCIe TX buffer enable for Gen1/Gen2 only
            .PCIE_LANE                      (PCIE_LANE)                         // PCIe number of lanes
        
        )
        gtp_pipe_reset_i
        (
        
            //---------- Input -----------------------------
            .RST_CLK                        (clk_pclk),                 
            .RST_RXUSRCLK                   (clk_rxusrclk),
            .RST_DCLK                       (clk_dclk),
            .RST_RST_N                      (reset_n_reg2),
            .RST_DRP_DONE                   (drp_done),
            .RST_RXPMARESETDONE             (gt_rxpmaresetdone),
            .RST_PLLLOCK                    (&qpll_qplllock), 
          //.RST_QPLL_IDLE                  (qrst_idle),                        // removed for GTP  
            .RST_RATE_IDLE                  (rate_idle),
            .RST_RXCDRLOCK                  (user_rxcdrlock),
            .RST_MMCM_LOCK                  (clk_mmcm_lock),
            .RST_RESETDONE                  (user_resetdone),
            .RST_PHYSTATUS                  (gt_phystatus),
            .RST_TXSYNC_DONE                (sync_txsync_done),
            
            //---------- Output ----------------------------
            .RST_CPLLRESET                  (rst_cpllreset),                   
            .RST_CPLLPD                     (rst_cpllpd),                      
            .RST_RXUSRCLK_RESET             (rst_rxusrclk_reset),
            .RST_DCLK_RESET                 (rst_dclk_reset),
            .RST_GTRESET                    (rst_gtreset),
            .RST_DRP_START                  (rst_drp_start),
            .RST_DRP_X16                    (rst_drp_x16),
            .RST_USERRDY                    (rst_userrdy),
            .RST_TXSYNC_START               (rst_txsync_start),
            .RST_IDLE                       (rst_idle),
            .RST_FSM                        (rst_fsm)
        
        );
        
        //---------- Default ---------------------------------------------------
        assign gtp_rst_qpllreset   = rst_cpllreset;
        assign gtp_rst_qpllpd      = rst_cpllpd;
        
        end

    else 

        begin : pipe_reset

        //---------- PIPE Reset Module -----------------------------------------
pcie_7x_0_pipe_reset #
        (
        
            .PCIE_SIM_SPEEDUP               (PCIE_SIM_SPEEDUP),                 // PCIe sim mode
            .PCIE_GT_DEVICE                 (PCIE_GT_DEVICE),                   // PCIe GT Device
            .PCIE_PLL_SEL                   (PCIE_PLL_SEL),                     // PCIe PLL select for Gen1/Gen2 only
            .PCIE_POWER_SAVING              (PCIE_POWER_SAVING),                // PCIe power saving
            .PCIE_TXBUF_EN                  (PCIE_TXBUF_EN),                    // PCIe TX buffer enable for Gen1/Gen2 only
            .PCIE_LANE                      (PCIE_LANE)                         // PCIe number of lanes
        
        )
        pipe_reset_i
        (
        
            //---------- Input -----------------------------                    
            .RST_CLK                        (clk_pclk),                         
            .RST_RXUSRCLK                   (clk_rxusrclk),                     
            .RST_DCLK                       (clk_dclk),                         
            .RST_RST_N                      (reset_n_reg2),   
            .RST_DRP_DONE                   (drp_done),
            .RST_RXPMARESETDONE             (gt_rxpmaresetdone),                  
            .RST_CPLLLOCK                   (gt_cplllock),                      
            .RST_QPLL_IDLE                  (qrst_idle),                        
            .RST_RATE_IDLE                  (rate_idle),                        
            .RST_RXCDRLOCK                  (user_rxcdrlock),                   
            .RST_MMCM_LOCK                  (clk_mmcm_lock),                    
            .RST_RESETDONE                  (user_resetdone),                   
            .RST_PHYSTATUS                  (gt_phystatus),                     
            .RST_TXSYNC_DONE                (sync_txsync_done),                 
                                                                                
            //---------- Output ----------------------------                    
            .RST_CPLLRESET                  (rst_cpllreset),                    
            .RST_CPLLPD                     (rst_cpllpd),                       
            .RST_RXUSRCLK_RESET             (rst_rxusrclk_reset),               
            .RST_DCLK_RESET                 (rst_dclk_reset),                   
            .RST_GTRESET                    (rst_gtreset), 
            .RST_DRP_START                  (rst_drp_start),
            .RST_DRP_X16X20_MODE            (rst_drp_x16x20_mode),
            .RST_DRP_X16                    (rst_drp_x16),                     
            .RST_USERRDY                    (rst_userrdy),                      
            .RST_TXSYNC_START               (rst_txsync_start),                 
            .RST_IDLE                       (rst_idle),                         
            .RST_FSM                        (rst_fsm[4:0])                           
                                                                                
        );
       
        //---------- Default ---------------------------------------------------
        assign gtp_rst_qpllreset = 1'd0;
        assign gtp_rst_qpllpd    = 1'd0; 
       
        end
    
endgenerate



//---------- QPLL Reset Module -------------------------------------------------
generate 

    if ((PCIE_LINK_SPEED == 3) || (PCIE_PLL_SEL == "QPLL"))

        begin : qpll_reset

pcie_7x_0_qpll_reset #
        (
        
            .PCIE_PLL_SEL                   (PCIE_PLL_SEL),     // PCIe PLL select for Gen1/Gen2 only
            .PCIE_POWER_SAVING              (PCIE_POWER_SAVING),// PCIe power saving
            .PCIE_LANE                      (PCIE_LANE)         // PCIe number of lanes
            
        )
        qpll_reset_i
        (
        
            //---------- Input ---------------------------------
            .QRST_CLK                       (clk_pclk),                 
            .QRST_RST_N                     (reset_n_reg2),
            .QRST_MMCM_LOCK                 (clk_mmcm_lock),
            .QRST_CPLLLOCK                  (gt_cplllock),
            .QRST_DRP_DONE                  (qdrp_done),
            .QRST_QPLLLOCK                  (qpll_qplllock),
            .QRST_RATE                      (PIPE_RATE),
            .QRST_QPLLRESET_IN              (rate_qpllreset),
            .QRST_QPLLPD_IN                 (rate_qpllpd),
            
            //---------- Output --------------------------------
            .QRST_OVRD                      (qrst_ovrd),
            .QRST_DRP_START                 (qrst_drp_start),
            .QRST_QPLLRESET_OUT             (qrst_qpllreset),
            .QRST_QPLLPD_OUT                (qrst_qpllpd),
            .QRST_IDLE                      (qrst_idle),
            .QRST_FSM                       (qrst_fsm)
        
        );

        end 
    
    else
     
        //---------- QPLL Reset Defaults ---------------------------------------
        begin : qpll_reset_disable
        assign qrst_ovrd      =  1'd0;
        assign qrst_drp_start =  1'd0;
        assign qrst_qpllreset =  1'd0;
        assign qrst_qpllpd    =  1'd0;
        assign qrst_idle      =  1'd0;
        assign qrst_fsm       =  1;
        end
     
endgenerate
        
assign jtag_sl_iport = {PCIE_LANE{37'd0}};

//Reference Clock for CPLLPD Fix

wire gt_cpllpdrefclk;

BUFG cpllpd_refclk_inst (.I (PIPE_CLK), .O (gt_cpllpdrefclk));
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
