TomKeddie/prj-artix7-pcie/fpga/v2/plan/xilinx_ip/pcie_7x_0_ex/pcie_7x_0_ex.srcs/sources_1/ip/pcie_7x_0/ip_0/hdl/jtag_axi_v1_2_syn_rfs.v

`pragma protect begin_protected
`pragma protect version = 1
`pragma protect encrypt_agent = "XILINX"
`pragma protect encrypt_agent_info = "Xilinx Encryption Tool 2019.1"
`pragma protect key_keyowner = "Cadence Design Systems.", key_keyname = "cds_rsa_key", key_method = "rsa"
`pragma protect encoding = (enctype = "BASE64", line_length = 76, bytes = 64)
`pragma protect key_block
ogKSSBZAMazc5rcqGPU3YJvah5qAqo3UhcbPcBOXoiP5NBdyWu+5LeJFxn7K8KvmiV4XnKaT6Yxg
1RW0cy4F5g==

`pragma protect key_keyowner = "Synopsys", key_keyname = "SNPS-VCS-RSA-2", key_method = "rsa"
`pragma protect encoding = (enctype = "BASE64", line_length = 76, bytes = 128)
`pragma protect key_block
fWlgM1Nuy6Ji+lw0KY3DR8F2XTuI80TGsEzAQ6RkPReyUUl8/IWWi3UBKXW8IMzdkPRM3j8CYSwu
xfP/Mjx4yw46kr5KRYndeP0ixCMLelf+2ENA17OPX+JiXRkz+rgZB0tfIJ6fMrEKFRtMB6WVvHRi
kmHZJ9ZnDTS2vlCFNn4=

`pragma protect key_keyowner = "Aldec", key_keyname = "ALDEC15_001", key_method = "rsa"
`pragma protect encoding = (enctype = "BASE64", line_length = 76, bytes = 256)
`pragma protect key_block
XzGAkTnJBFDLpQ4hzw69c3euG3qC6TbFjIuuLNgTQDf07WWnBqx7JodKqtCF48Sf7/o3a5aZGV2L
PsDXhcb/6yWzNvzaN4oTBnyjrkyEC+PGE7A3Q7rGeT7QFu7li9hhtUAVbmKK5tjW91udU7Bm0xa4
fK5w0GfQC7p5VOOni/s/xY46o1CsiA/AU/te9kesfNBuEMrfHMOPbbwFNLWV5dUNauk7kgXp+7qt
zqkh5kD4VVPPyAKBNnkDGJkm6sJJaSD18ag4UuAeBXYo+qrYdnBzlf3zZ5BJHYWT3+YPV9rD6Hb2
4U9Ce86IW/ycOa5XGJnzE4bwwop1o6XkpVIm5A==
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
