TomKeddie/prj-artix7-pcie/(commit log)

2018-09-30 First pass at artix pcie board - serdes
    [7_Series_XPE_2018_2.xlsm, artix7-pcie-pwr.sch, artix7-pcie-serdes.sch, artix7-pcie.kicad_pcb, artix7-pcie.sch]
2020-02-13 Prepare for v2, move first attempt to v1
    [artix7-pcie-pwr.sch, artix7-pcie-serdes.sch, artix7-pcie.kicad_pcb, artix7-pcie.sch]
2020-02-13 Add NeTV2 schematic pdf
2020-02-15 v1 updates (abandoned)
    [artix7-pcie-serdes.sch, artix7-pcie.kicad_pcb]
2020-02-16 artix7-pcie-v2: added project with partially complete power sheet
    [artix7-pcie-v2-power.sch, artix7-pcie-v2.kicad_pcb, artix7-pcie-v2.sch]
2020-03-03 v2 schematic : add config block and connectors
    [artix7-pcie-v2.sch]
2020-03-03 v2 power schematic : annotated
    [artix7-pcie-v2-power.sch]
2020-03-03 v2 schematic: add bank14, serdes, fpga footprint
    [artix7-pcie-v2-bank14.sch, artix7-pcie-v2-power.sch, artix7-pcie-v2-serdes.sch, artix7-pcie-v2.sch]
2020-03-03 v2 schematic: moved 1.0V regulator to APXS006A0X4-SRZ
    [artix7-pcie-v2-power.sch]
2020-03-10 sch: moved all power supplies to APXS006A0X4-SRZ
    [artix7-pcie-v2-power.sch]
2020-03-10 v2 hardware - all io connectors in schematic
    [artix7-pcie-v2-bank14.sch, artix7-pcie-v2-bank15.sch, artix7-pcie-v2-bank34.sch, artix7-pcie-v2-power.sch, artix7-pcie-v2-serdes.sch, artix7-pcie-v2.kicad_pcb, artix7-pcie-v2.sch]
2020-03-15 v2 schematic/pcb: band 13 to NC for smaller device compatibility
    [artix7-pcie-v2-bank14.sch, artix7-pcie-v2-bank15.sch, artix7-pcie-v2-bank34.sch, artix7-pcie-v2-power-fpga.sch, artix7-pcie-v2-power.sch, artix7-pcie-v2-serdes.sch, artix7-pcie-v2.kicad_pcb, artix7-pcie-v2.sch]
2020-03-20 v2 hardware progress checkin, just prior to replacing p/s with TI parts
    [artix7-pcie-v2-bank14.sch, artix7-pcie-v2-bank15.sch, artix7-pcie-v2-bank34.sch, artix7-pcie-v2-power.sch, artix7-pcie-v2-serdes.sch, artix7-pcie-v2.kicad_pcb, artix7-pcie-v2.sch]
2020-03-20 Add v2 litex/migen pin planning impl.
2020-03-20 Addd kicad settings to gitignore
2020-03-22 v2 pcb/schematic update : drc passing, need to add caps
    [artix7-pcie-v2-bank14.sch, artix7-pcie-v2-bank15.sch, artix7-pcie-v2-bank34.sch, artix7-pcie-v2-power-fpga.sch, artix7-pcie-v2-power.sch, artix7-pcie-v2-serdes.sch, artix7-pcie-v2.kicad_pcb, artix7-pcie-v2.sch]
2020-03-22 fpga/plan : updates to match schematic
2020-03-28 v2 hardware: pcb progress commit, 155 unrouted
    [artix7-pcie-v2-bank14.sch, artix7-pcie-v2-bank15.sch, artix7-pcie-v2-bank34.sch, artix7-pcie-v2-power-fpga.sch, artix7-pcie-v2-power.sch, artix7-pcie-v2-serdes.sch, artix7-pcie-v2.kicad_pcb, artix7-pcie-v2.sch]
2020-03-28 v2 plan.py: add spi, move micro usb to ease routing
2020-04-10 v2 pcb/schematic progress commit, all tough signals routed out
    [artix7-pcie-v2-bank14.sch, artix7-pcie-v2-bank15.sch, artix7-pcie-v2-bank34.sch, artix7-pcie-v2-serdes.sch, artix7-pcie-v2.kicad_pcb, artix7-pcie-v2.sch]
2020-04-12 Add practice schematic/pcb for diff pair routing
    [practice.kicad_pcb, practice.sch]
2020-04-12 v2 schematic/pcb progress commit - 12 unrouted
    [artix7-pcie-v2-bank14.sch, artix7-pcie-v2-bank15.sch, artix7-pcie-v2-bank34.sch, artix7-pcie-v2.kicad_pcb, artix7-pcie-v2.sch]
2020-04-13 v2 hardware: all tracks routed, erc/drc pass
    [artix7-pcie-v2-bank14.sch, artix7-pcie-v2-bank34.sch, artix7-pcie-v2-serdes.sch, artix7-pcie-v2.kicad_pcb]
2020-04-14 v2 hardware progress commit - fixed mounting holes and board edge
    [artix7-pcie-v2-bank14.sch, artix7-pcie-v2.kicad_pcb, artix7-pcie-v2.sch]
2020-04-14 v2 progress commit : serdes lanes all deskewed
    [artix7-pcie-v2.kicad_pcb]
2020-04-17 First pass add adding pcie Final schematic updates
2020-04-19 v2 hardware: J2 differential pairs tuned
    [artix7-pcie-v2.kicad_pcb, artix7-pcie-v2.sch]
2020-04-19 v2 hardware: j2_34 diff pairs matched, fix 0402 resistor packages, dropped paste from DNP resistors
    [artix7-pcie-v2-bank14.sch, artix7-pcie-v2-power.sch, artix7-pcie-v2-serdes.sch, artix7-pcie-v2.kicad_pcb, artix7-pcie-v2.sch]
2020-04-19 v2 hardware : update tom-kicad submodules to pick up NoPaste parts
2020-04-19 v2 hardware : add missing mounting holes, all pairs tuned and passing. J1_34_DP0.5/0.5 -> MEETS INTER-PAIR TOLERANCE 0.5000 mm (current delta 0.4093) /artix7-pcie-v2-bank34/IO_L1_34 meets intra-pair 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
    [artix7-pcie-v2.kicad_pcb, artix7-pcie-v2.sch]
2020-04-20 Apr2020 rc1
    [artix7-pcie-v2-B_Cu.gbr, artix7-pcie-v2-B_Mask.gbr, artix7-pcie-v2-B_Paste.gbr, artix7-pcie-v2-B_SilkS.gbr, artix7-pcie-v2-Edge_Cuts.gbr, artix7-pcie-v2-F_Cu.gbr, artix7-pcie-v2-F_Mask.gbr, artix7-pcie-v2-F_Paste.gbr]
2020-04-20 v2 hardware: april 2020 rc2 - add teardrops
    [artix7-pcie-v2-B_Cu.gbr, artix7-pcie-v2-B_Mask.gbr, artix7-pcie-v2-B_Paste.gbr, artix7-pcie-v2-B_SilkS.gbr, artix7-pcie-v2-Edge_Cuts.gbr, artix7-pcie-v2-F_Cu.gbr, artix7-pcie-v2-F_Mask.gbr, artix7-pcie-v2-F_Paste.gbr]
2020-05-22 Replace bom with csv version
2020-05-22 rename bom
    [artix7-pcie-v2.csv]
2020-05-22 v2 hardware: add Digikey part numbers to schematic and generate bom
    [artix7-pcie-v2-bank14.sch, artix7-pcie-v2-bank15.sch, artix7-pcie-v2-bank34.sch, artix7-pcie-v2-power-fpga.sch, artix7-pcie-v2-power.sch, artix7-pcie-v2-serdes.sch, artix7-pcie-v2.csv, artix7-pcie-v2.sch]
2020-05-22 hardware v2: bom fixes
    [artix7-pcie-v2-power.sch, artix7-pcie-v2.csv, artix7-pcie-v2.sch]
2020-06-01 hardware v2: fix digikey part number for U3
    [artix7-pcie-v2-power.sch, artix7-pcie-v2.csv]
2020-06-21 hardware v2: fix digikey part number on MGTAVTT regulator
    [artix7-pcie-v2-power.sch]
2020-06-28 Add verilog-i2c module for i2c master
2020-07-11 v2 fpga: i2c working on Saleae, need to add stop at the end scl is staying low
2020-07-21 v2 fpga: vivado_1 i2c read working
2020-07-23 v2 fpga: finish clock config with reset sequence
    [top.v]
2020-08-01 Add arduino script for programming clock generator
2020-08-02 hardware: add USB 3.0 connector digikey part number
    [artix7-pcie-v2-serdes.sch]
2020-08-08 v2 hardware: arduino script for clock config
2020-08-09 v2 hardware: aug2020 pcb updates
    [artix7-pcie-v2-B_Cu.gbr, artix7-pcie-v2-B_Mask.gbr, artix7-pcie-v2-B_Paste.gbr, artix7-pcie-v2-B_SilkS.gbr, artix7-pcie-v2-Edge_Cuts.gbr, artix7-pcie-v2-F_Cu.gbr, artix7-pcie-v2-F_Mask.gbr, artix7-pcie-v2-F_Paste.gbr]
2020-08-10 v2 hardware: Aug2020/rc2 version - flip tx/rx pairs on s2 - add lcsc part numbers
    rc2 errata schematic
    - change serial port connector to add +3.3V ? (8-pin)(NO)
    - add test points for flash pre-programming
    - smaller package on input direction diodes (NO)
    - bom dupe errors
    - remove all p/s 0R bringup parts
    - optimise bom (use 1.5k for led, 10k/4.7k for i2c pullups)
    - done led is bright (change to 4.7k)
    - improve shield grounding with RC
    - check actual values of RGB resistors
    - remove caps from clock inputs
    rc2 errata pcb
    - no gnd marking on serial port connector pins
    - change serial port connector to add +3.3V ? (8-pin) (NO)
    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
    [artix7-pcie-v2-B_Cu.gbr, artix7-pcie-v2-B_Mask.gbr, artix7-pcie-v2-B_Paste.gbr, artix7-pcie-v2-B_SilkS.gbr, artix7-pcie-v2-Edge_Cuts.gbr, artix7-pcie-v2-F_Cu.gbr, artix7-pcie-v2-F_Mask.gbr, artix7-pcie-v2-F_Paste.gbr]
2020-08-10 v2 hardware : fix isues found by jlcpcb - change 0603 parts to add paste as they are now loaded - fix solder paste/mask issues with TPS power modules
    [artix7-pcie-v2-power.sch, artix7-pcie-v2.kicad_pcb]
2020-09-02 Added new regulator symbols for updated p/s
2020-09-02 Added new regulator footprints for updated p/s
2020-09-05 JLC power supplies almost routed VCCBRAM to go Need to - check BOM - add power good leds - fix vccbram inc caps - fix 100uF part number - update silk
    [artix7-pcie-v2-bank14.sch, artix7-pcie-v2-power.sch, artix7-pcie-v2-serdes.sch, artix7-pcie-v2.kicad_pcb, artix7-pcie-v2.sch]
2020-09-06 v2 hardware updates: fixed inductor footprint, updates for DFA
    [artix7-pcie-v2-B_Cu.gbr, artix7-pcie-v2-B_Mask.gbr, artix7-pcie-v2-B_Paste.gbr, artix7-pcie-v2-B_SilkS.gbr, artix7-pcie-v2-Edge_Cuts.gbr, artix7-pcie-v2-F_Cu.gbr, artix7-pcie-v2-F_Mask.gbr, artix7-pcie-v2-F_Paste.gbr]
2020-09-06 v2 hardware: add jlcpcb bom file
    [artix7-pcie-v2_jlcpcb.csv]
2020-09-09 v2 hardare: progress commit on Sept2020 run
    [artix7-pcie-v2.kicad_pcb]
2020-09-09 v2 hardware: fixed drc issues from inductor pad changes
    [artix7-pcie-v2.kicad_pcb]
2020-09-13 v2 hardware: change 100uF to 3528 for jlcpcb
    [artix7-pcie-v2-bank14.sch, artix7-pcie-v2-bank15.sch, artix7-pcie-v2-bank34.sch, artix7-pcie-v2-power-fpga.sch, artix7-pcie-v2.kicad_pcb]
2020-09-13 Update tom-kicad anchor
2020-09-13 v2 hardware: sep2020 run - fixed issues with parts missing from centroid file
    [artix7-pcie-v2-B_Cu.gbr, artix7-pcie-v2-B_Mask.gbr, artix7-pcie-v2-B_Paste.gbr, artix7-pcie-v2-B_SilkS.gbr, artix7-pcie-v2-Edge_Cuts.gbr, artix7-pcie-v2-F_Cu.gbr, artix7-pcie-v2-F_Mask.gbr, artix7-pcie-v2-F_Paste.gbr]
2020-09-18 v2 hardware: fix drc/unrouted ready for resubmission to JLC
    [artix7-pcie-v2-B_Cu.gbr, artix7-pcie-v2-B_Mask.gbr, artix7-pcie-v2-B_Paste.gbr, artix7-pcie-v2-B_SilkS.gbr, artix7-pcie-v2-Edge_Cuts.gbr, artix7-pcie-v2-F_Cu.gbr, artix7-pcie-v2-F_Mask.gbr, artix7-pcie-v2-F_Paste.gbr]
2020-09-21 hardware v2: sep2020 as submitted to jlcpcb
    [artix7-pcie-v2-B_Cu.gbr, artix7-pcie-v2-B_Mask.gbr, artix7-pcie-v2-B_Paste.gbr, artix7-pcie-v2-B_SilkS.gbr, artix7-pcie-v2-Edge_Cuts.gbr, artix7-pcie-v2-F_Cu.gbr, artix7-pcie-v2-F_Mask.gbr, artix7-pcie-v2-F_Paste.gbr]
2020-11-22 hardware: update pcb as per sep 2020b
    [artix7-pcie-v2-B_Cu.gbr, artix7-pcie-v2-B_Mask.gbr, artix7-pcie-v2-B_Paste.gbr, artix7-pcie-v2-B_SilkS.gbr, artix7-pcie-v2-Edge_Cuts.gbr, artix7-pcie-v2-F_Cu.gbr, artix7-pcie-v2-F_Mask.gbr, artix7-pcie-v2-F_Paste.gbr]
2020-11-22 Re-route HS diff pairs for 90R (0.147/0.253 as per RPI cm4 carrier) Add ground stitching
    [artix7-pcie-v2.kicad_pcb]
2020-11-22 hardware: minor fixes to v2 for Nov2020 run
    [artix7-pcie-v2-B_Cu.gbr, artix7-pcie-v2-B_Mask.gbr, artix7-pcie-v2-B_Paste.gbr, artix7-pcie-v2-B_SilkS.gbr, artix7-pcie-v2-Edge_Cuts.gbr, artix7-pcie-v2-F_Cu.gbr, artix7-pcie-v2-F_Mask.gbr, artix7-pcie-v2-F_Paste.gbr]
2020-12-10 v2 hardware: add ground pours to power layer
    [artix7-pcie-v2.kicad_pcb]
2020-12-11 v2 hardware: fix issues with pwr layer copper pour, add Dec2020 release
    [artix7-pcie-v2-B_Cu.gbr, artix7-pcie-v2-B_Mask.gbr, artix7-pcie-v2-B_Paste.gbr, artix7-pcie-v2-B_SilkS.gbr, artix7-pcie-v2-Edge_Cuts.gbr, artix7-pcie-v2-F_Cu.gbr, artix7-pcie-v2-F_Mask.gbr, artix7-pcie-v2-F_Paste.gbr]
